loco-can/loco-can-hardware/Graphics/module-images/Messinstrument.png

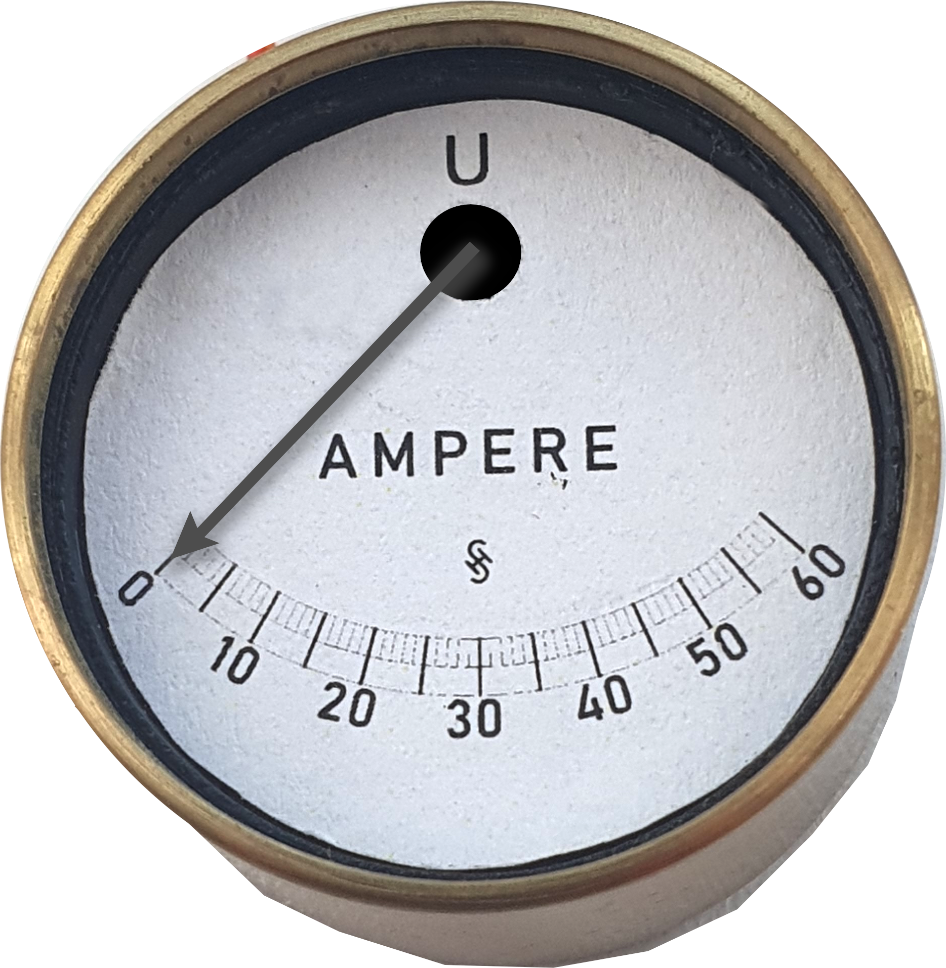
Graphics/module-images/Messinstrument.png
