loco-can/loco-can-hardware/Graphics/module-images/Motor.jpg

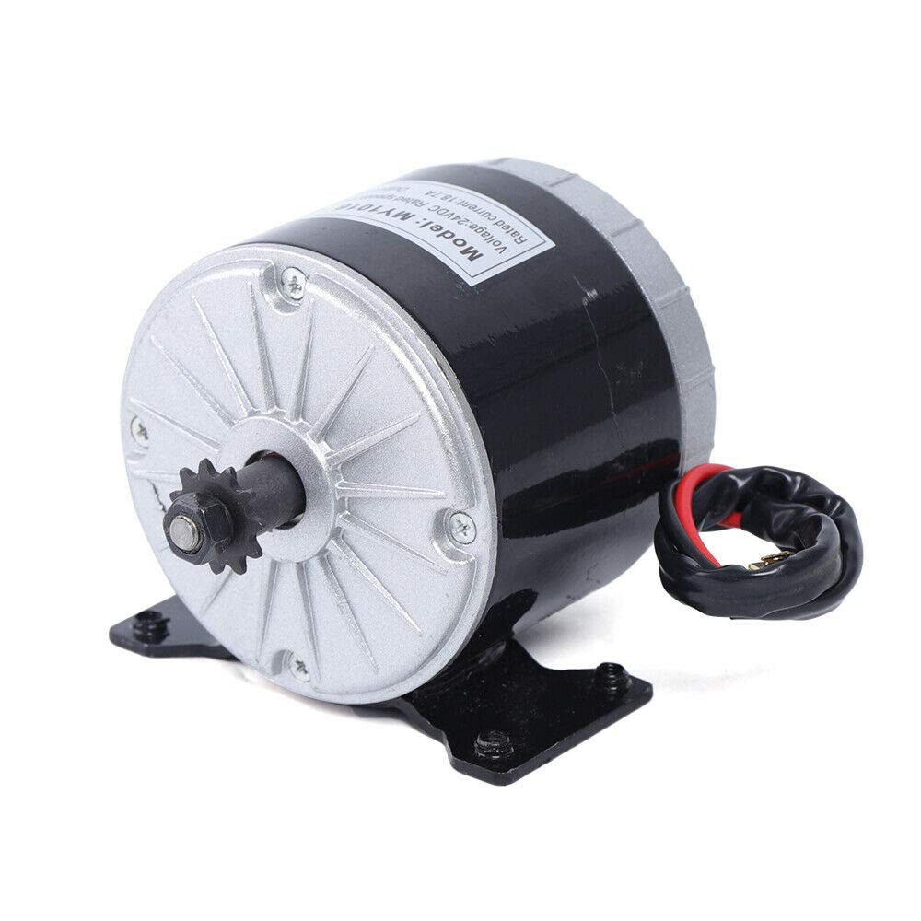
Graphics/module-images/Motor.jpg
