loco-can/loco-can-hardware/Graphics/documentation/Loco-CAN Zusammenstellung.pdf

# Klassische Steuerleitung

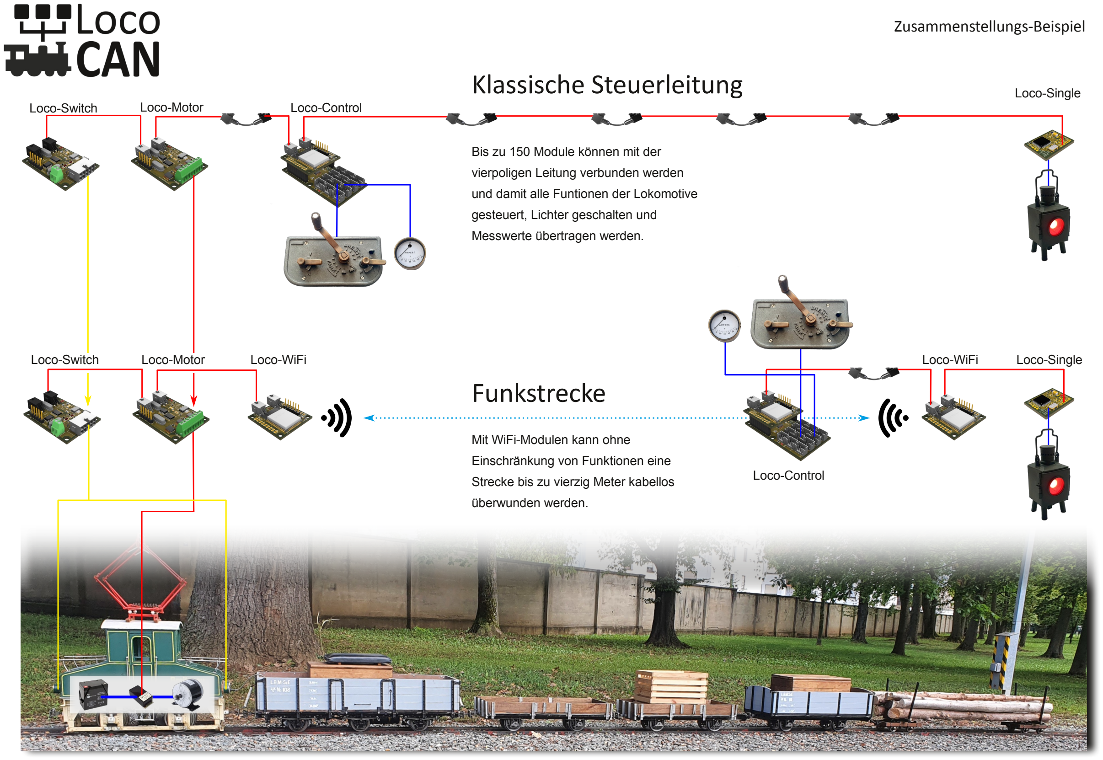
[picture p3: page 1]

Loco-WiFi Loco-Single

Loco-Control

Loco-WiFi

Loco-Single
Loco-Switch | Loco-Motor | Loco-Control
Loco-Switch | Loco-Motor

Bis zu 150 Module können mit der vierpoligen Leitung verbunden werden und damit alle Funtionen der Lokomotive gesteuert, Lichter geschalten und Messwerte übertragen werden.

Mit WiFi-Modulen kann ohne Einschränkung von Funktionen eine Strecke bis zu vierzig Meter kabellos überwunden werden.

# Funkstrecke

Zusammenstellungs‐Beispiel
