loco-can/loco-can-hardware/Graphics/module-images/4QD.png

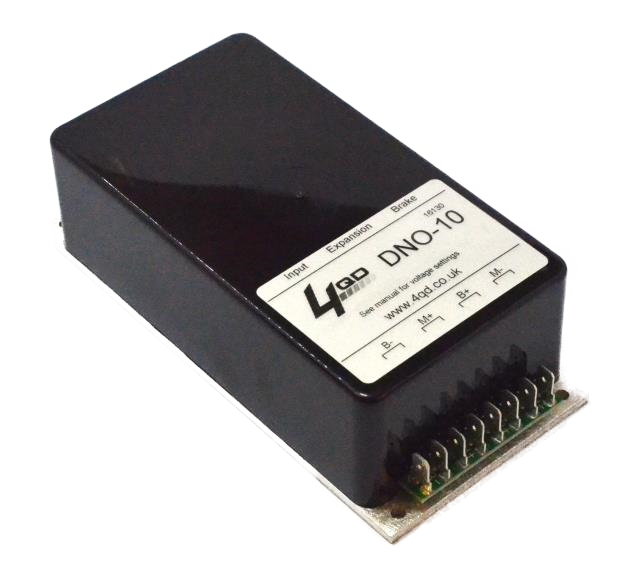
Graphics/module-images/4QD.png
