loco-can/loco-can-hardware/Graphics/module-images/Akku.png

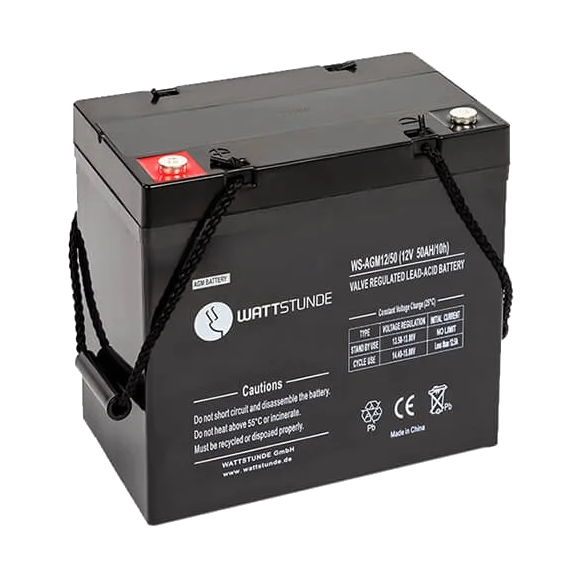
Graphics/module-images/Akku.png
