loco-can/loco-can-hardware/Graphics/module-images/Ausstecklaterne rot.jpg

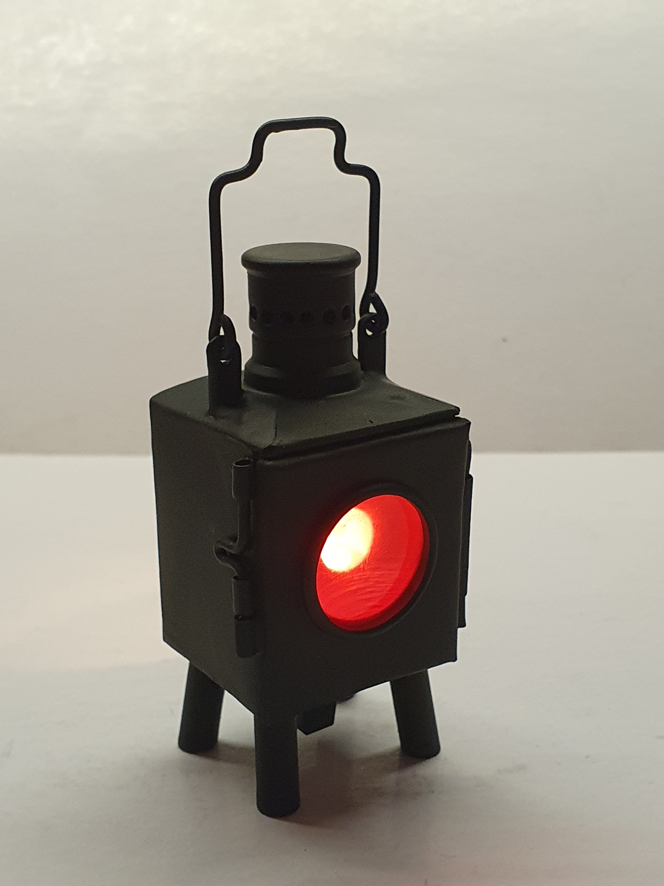
Graphics/module-images/Ausstecklaterne rot.jpg
