loco-can/loco-can-hardware/Graphics/module-images/Ausstecklaterne rot.png

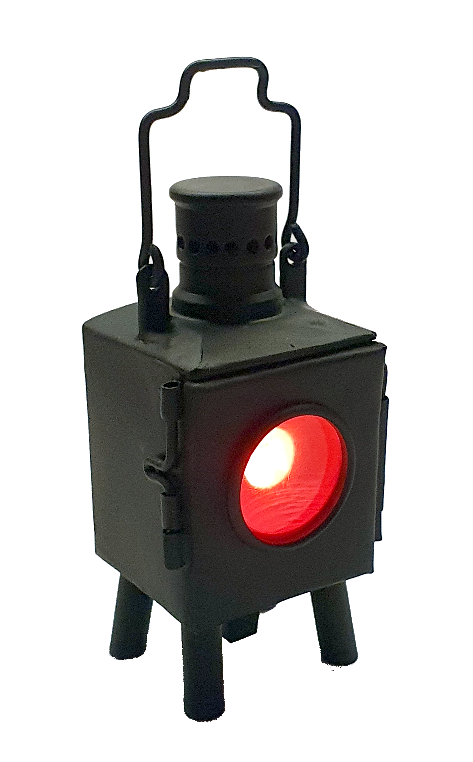
Graphics/module-images/Ausstecklaterne rot.png
