loco-can/loco-can-hardware/Graphics/module-images/Ausstecklaterne weiß.jpg

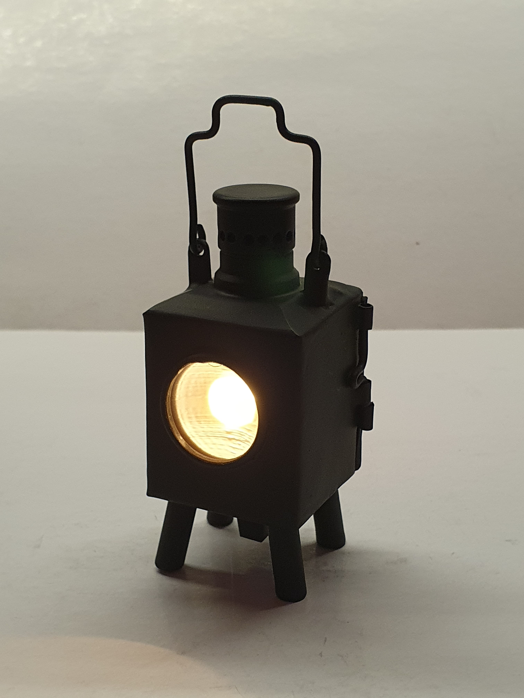
Graphics/module-images/Ausstecklaterne weiß.jpg
