loco-can/loco-can-hardware/Graphics/module-images/Heizungsstecker.jpg

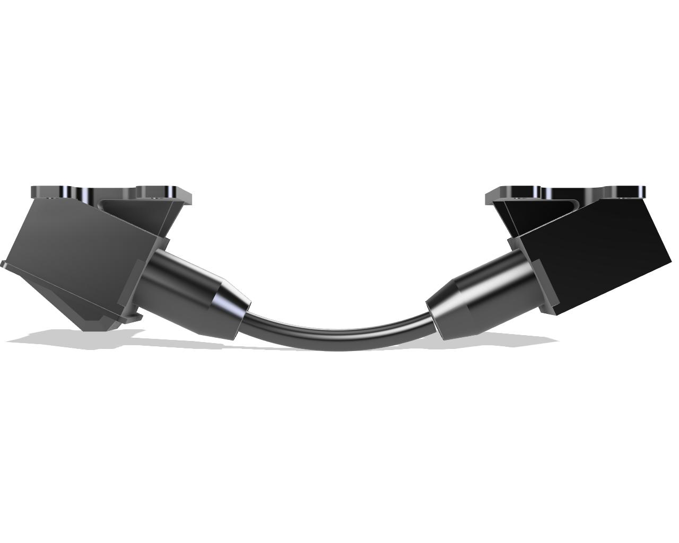
Graphics/module-images/Heizungsstecker.jpg
