loco-can/loco-can-hardware/Graphics/module-images/LOCO-Control-Adapter.jpg

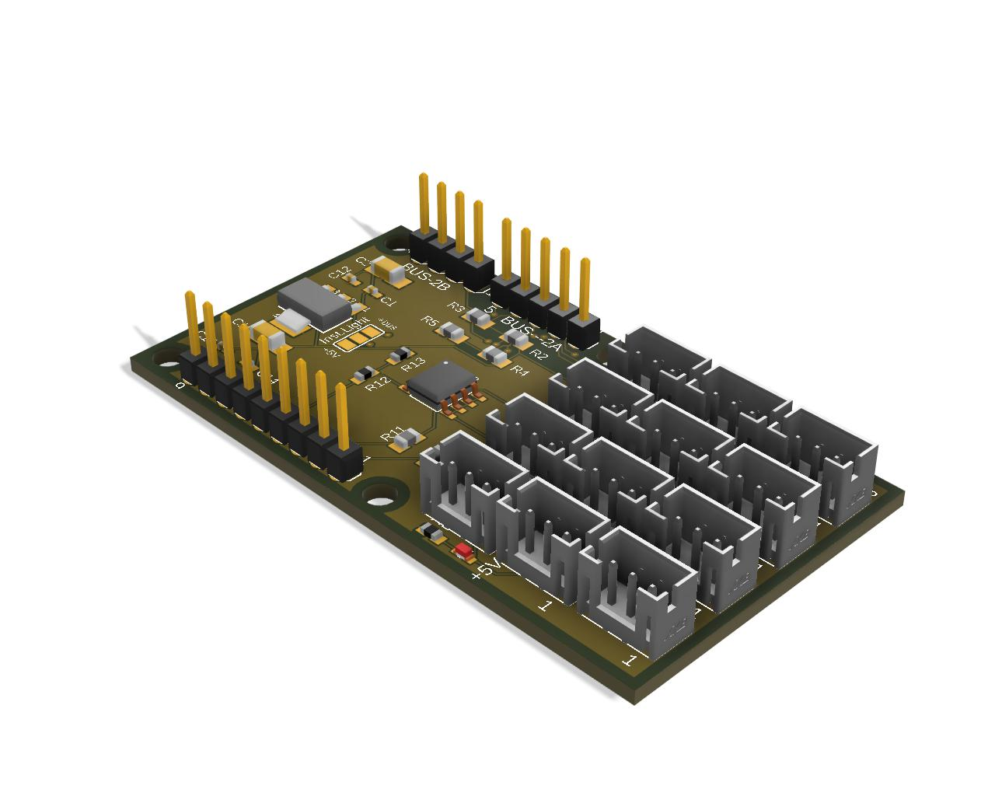
Graphics/module-images/LOCO-Control-Adapter.jpg
