loco-can/loco-can-hardware/Graphics/module-images/Loco-Control-WiFi.jpg

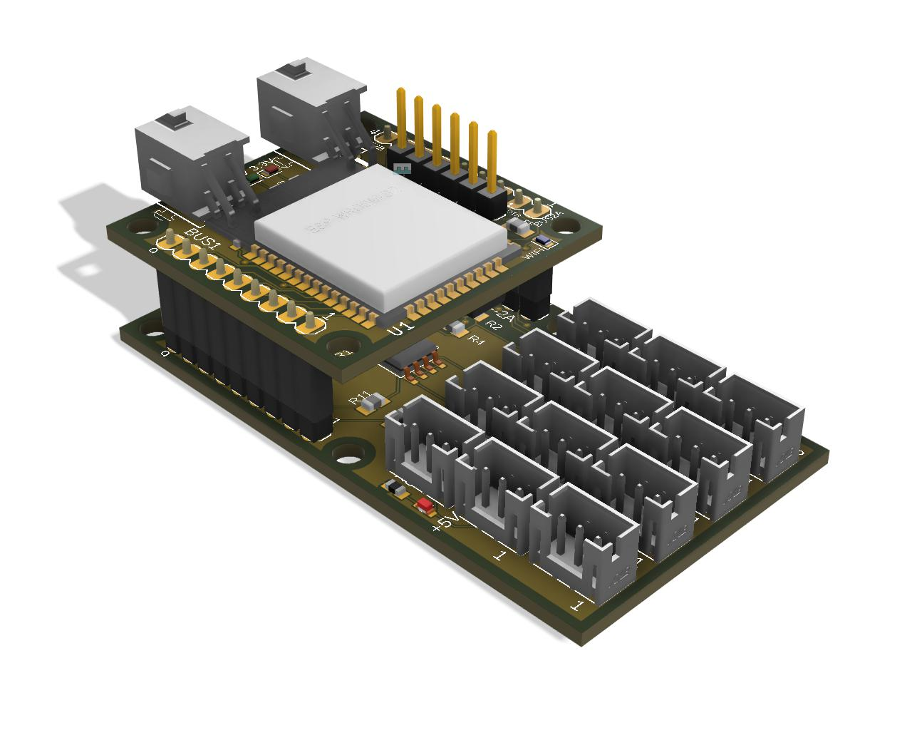
Graphics/module-images/Loco-Control-WiFi.jpg
