loco-can/loco-can-hardware/Graphics/module-images/Loco-Motor.jpg

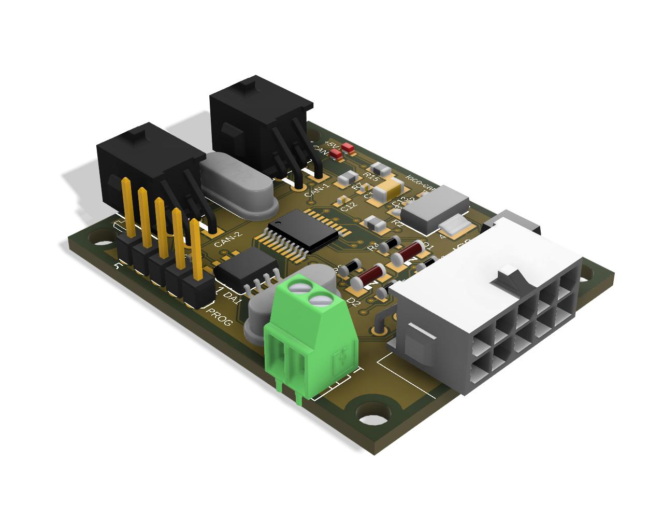
Graphics/module-images/Loco-Motor.jpg
