loco-can/loco-can-hardware/Graphics/module-images/Loco-Servo.jpg

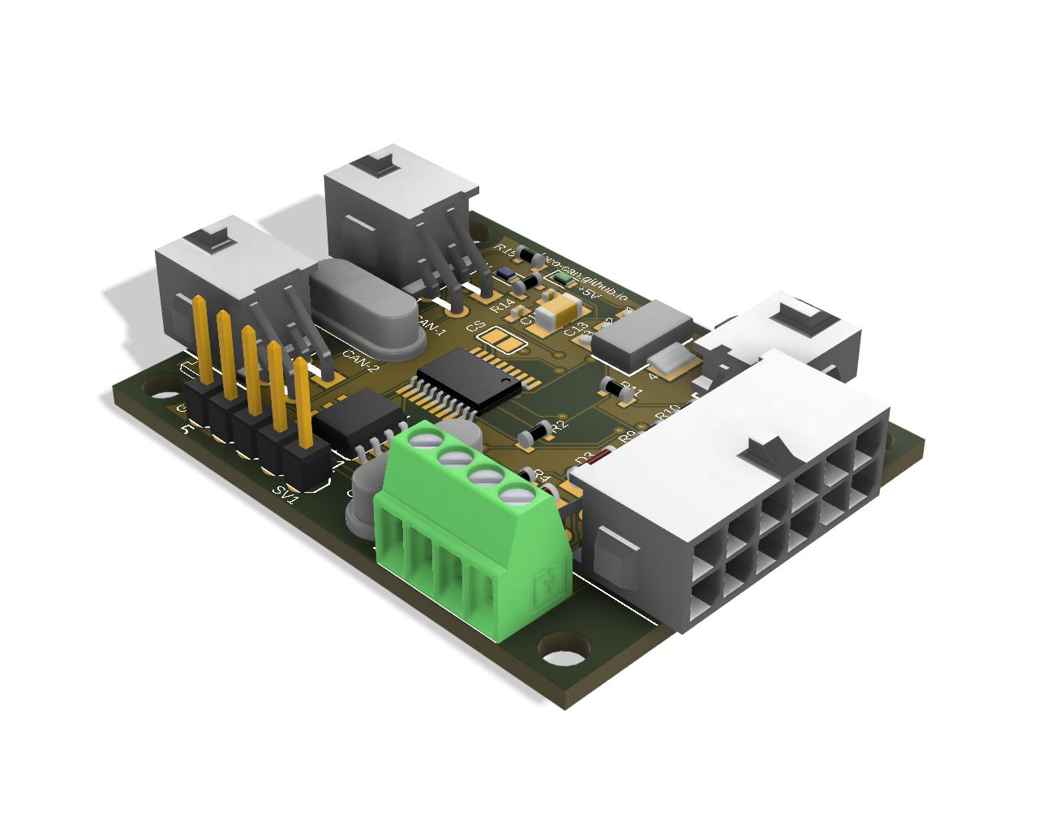
Graphics/module-images/Loco-Servo.jpg
