loco-can/loco-can-hardware/Graphics/module-images/Loco-Single Akku.png

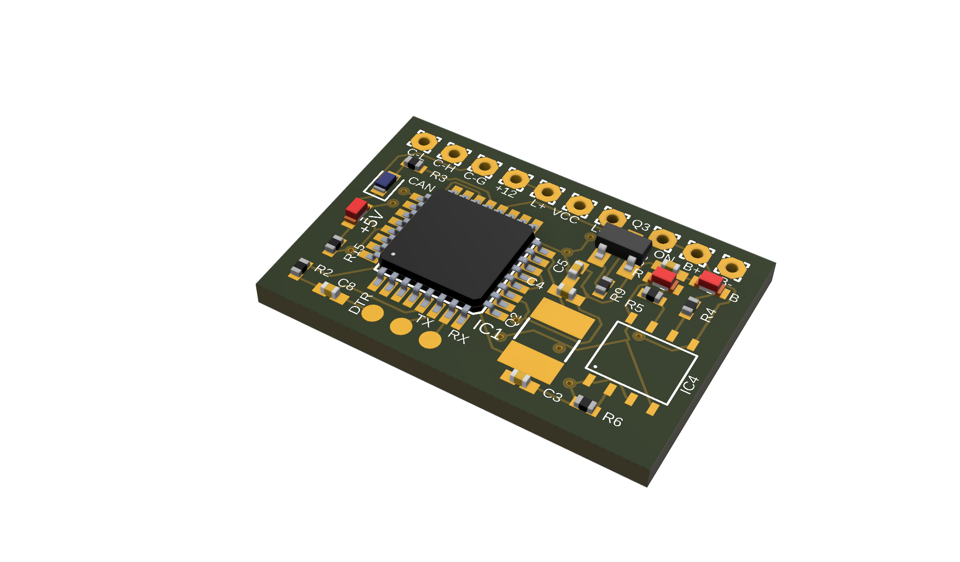
Graphics/module-images/Loco-Single Akku.png
