loco-can/loco-can-hardware/Graphics/module-images/Loco-Single.jpg

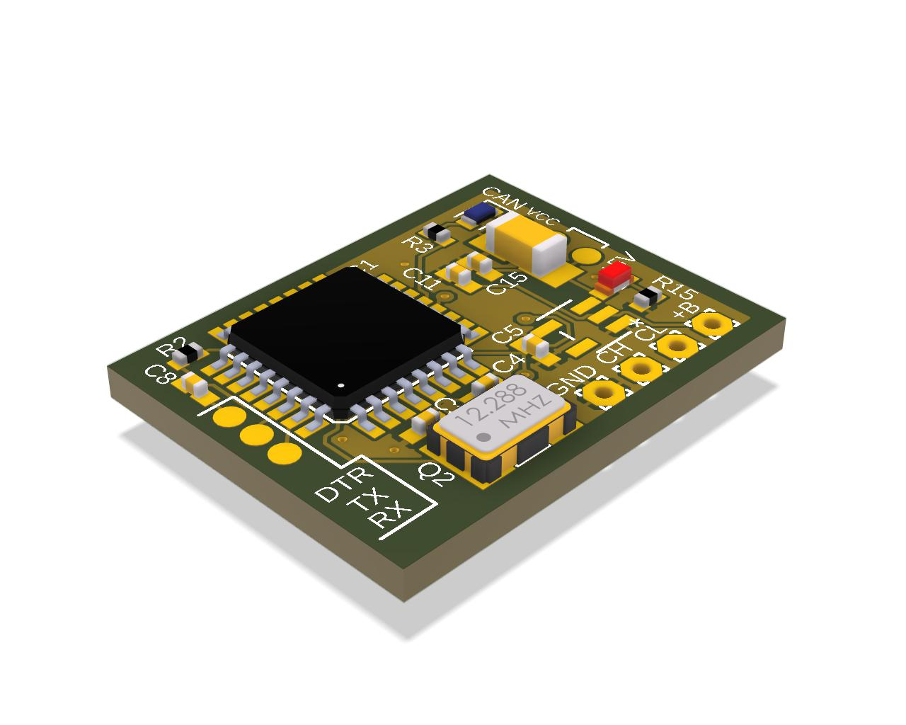
Graphics/module-images/Loco-Single.jpg
