loco-can/loco-can-hardware/Graphics/module-images/Loco-Split.jpg

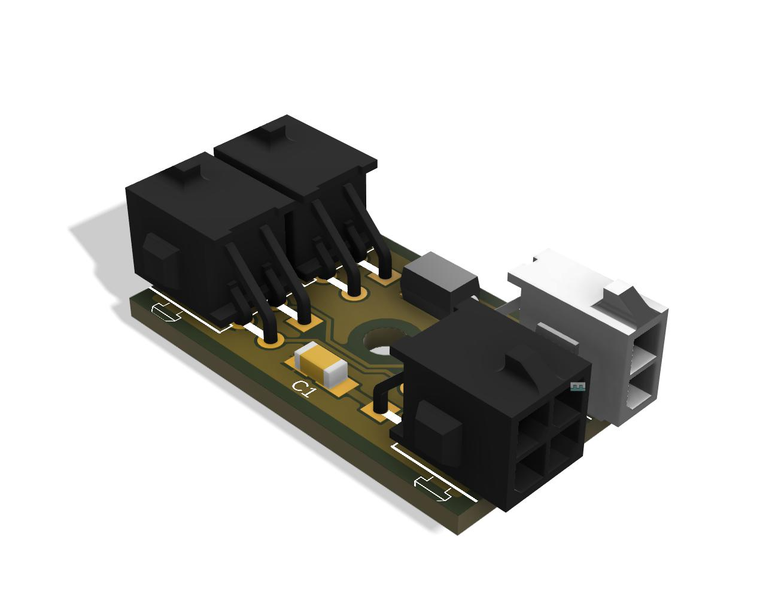
Graphics/module-images/Loco-Split.jpg
