loco-can/loco-can-hardware/Graphics/module-images/Loco-Switch.jpg

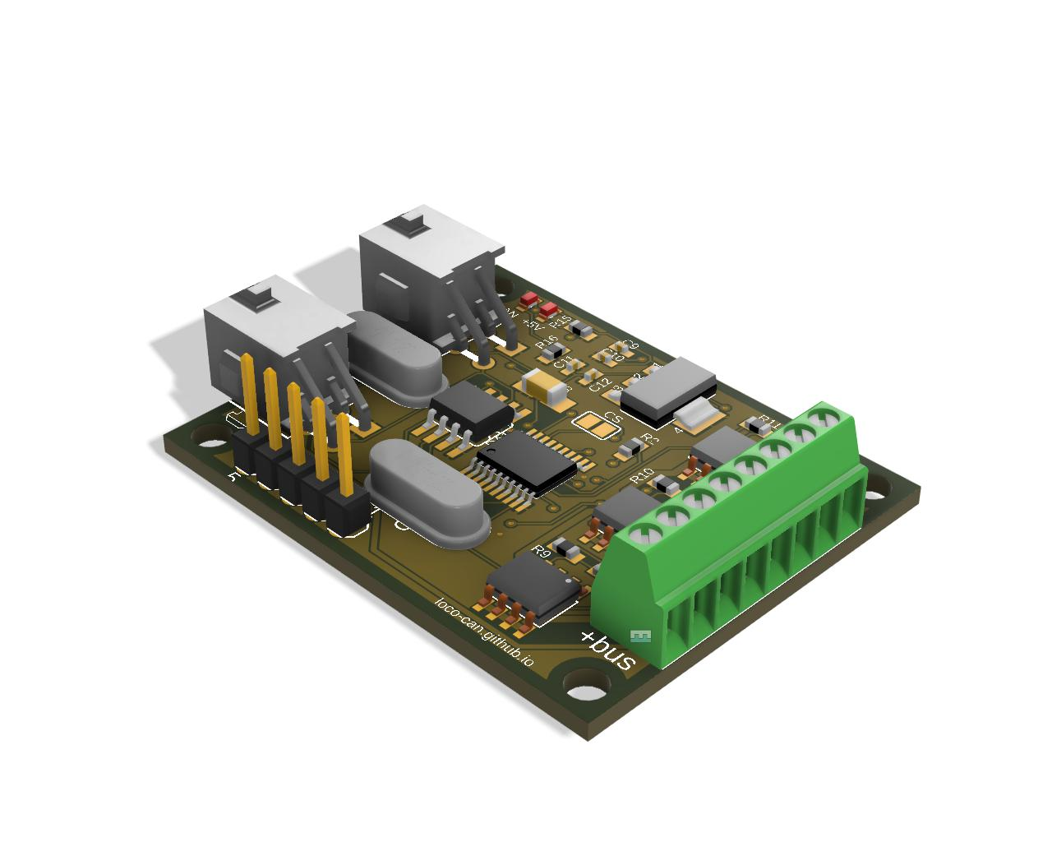
Graphics/module-images/Loco-Switch.jpg
