loco-can/loco-can-hardware/Graphics/module-images/Loco-Universal.jpg

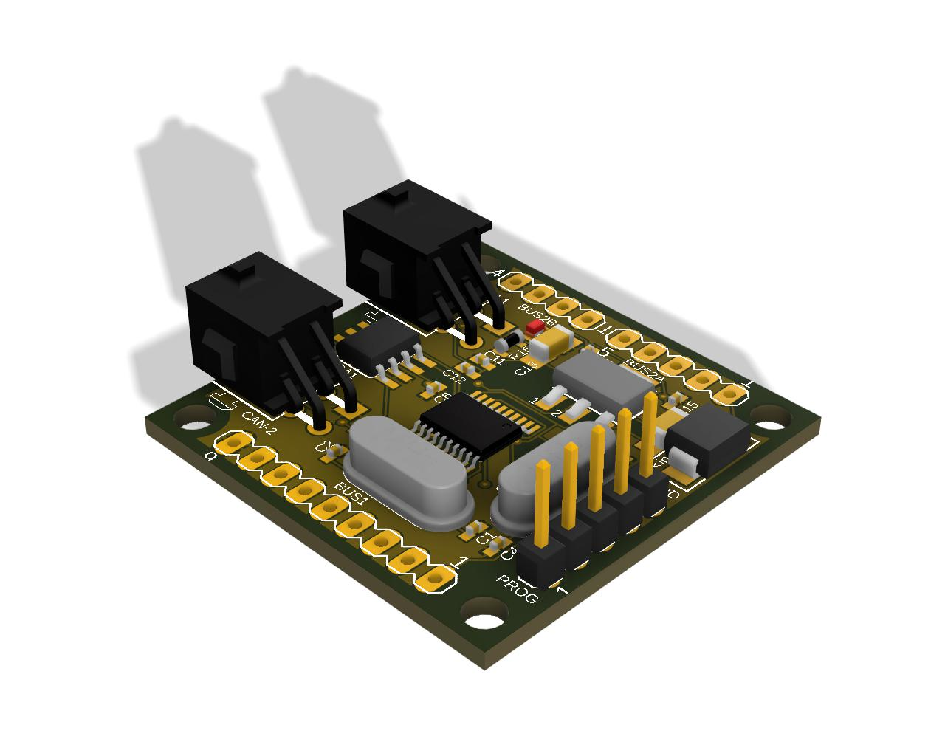
Graphics/module-images/Loco-Universal.jpg
