loco-can/loco-can-hardware/Graphics/module-images/Loco-WiFi.png

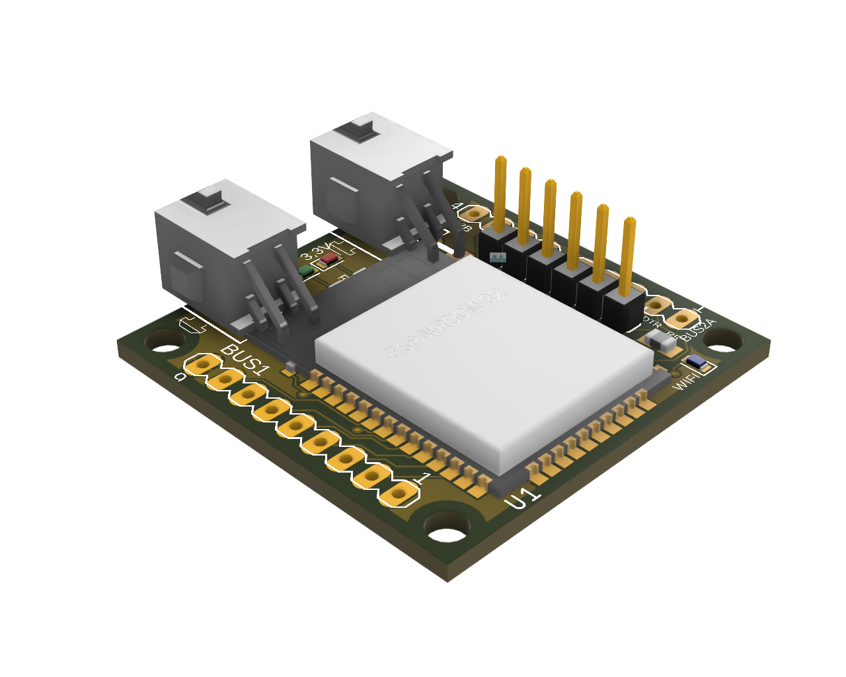
Graphics/module-images/Loco-WiFi.png
