loco-can/loco-can-hardware/Graphics/module-images/Motor.png

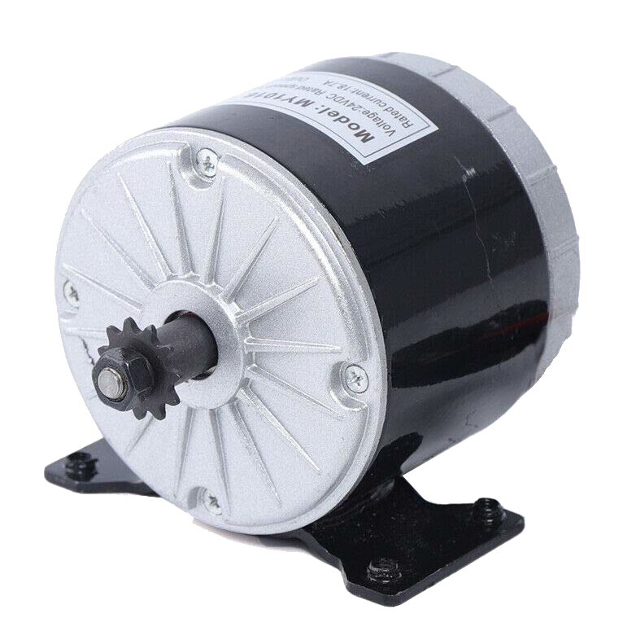
Graphics/module-images/Motor.png
