loco-can/loco-can-hardware/Graphics/module-images/oshw.bmp

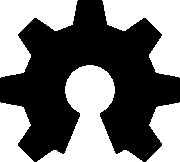
Graphics/module-images/oshw.bmp
