loco-can/loco-can-hardware/Mechanics/cover motor module.stl

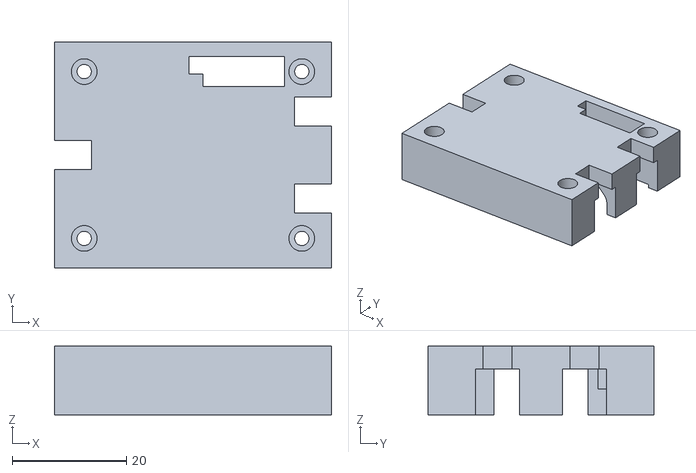
[picture p22: CAD file, 2023-09-08]
Mechanics/cover motor module.stl
48.5 x 39.5 x 12.0
