loco-can/loco-can-hardware/Mechanics/cover servo module.stl

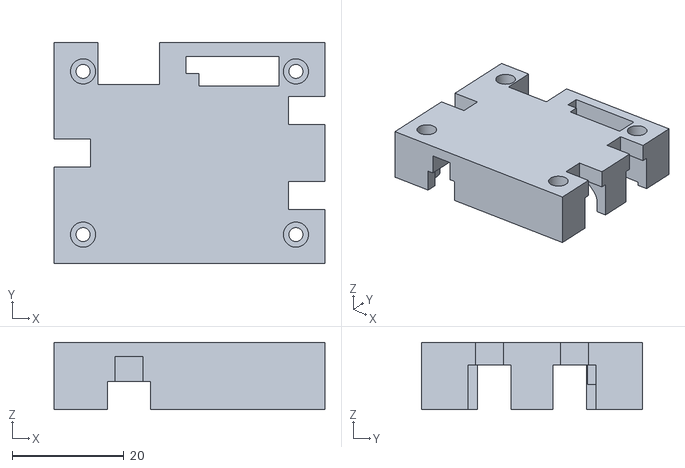
[picture p23: CAD file, 2023-09-08]
Mechanics/cover servo module.stl
48.5 x 39.5 x 12.0
