loco-can/loco-can-hardware/Mechanics/frame control adapter.stl

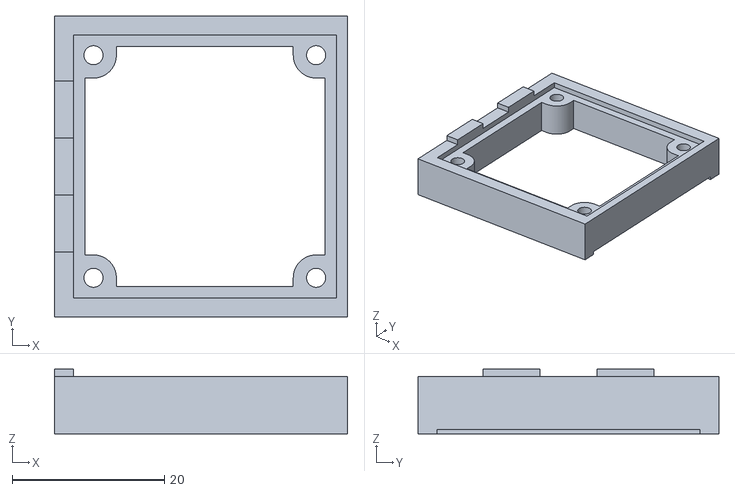
[picture p24: CAD file, 2023-09-08]
Mechanics/frame control adapter.stl
38.5 x 39.5 x 8.50
