loco-can/loco-can-hardware/Mechanics/baseplate controller.stl

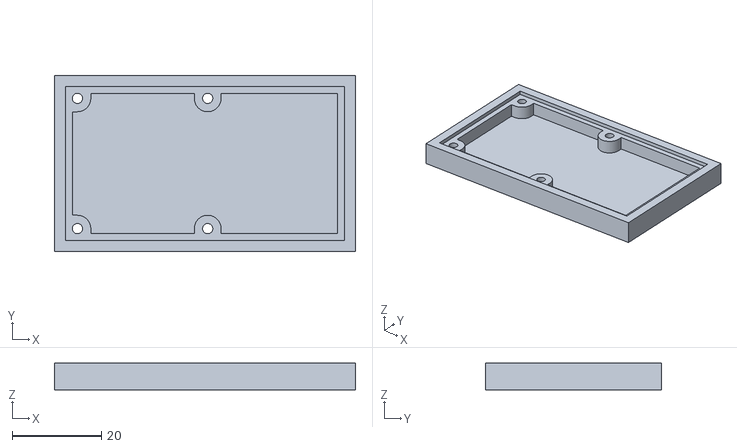
[picture p25: CAD file, 2023-09-08]
Mechanics/baseplate controller.stl
67.5 x 39.5 x 6.00
