loco-can/loco-can-hardware/Mechanics/baseplate.stl

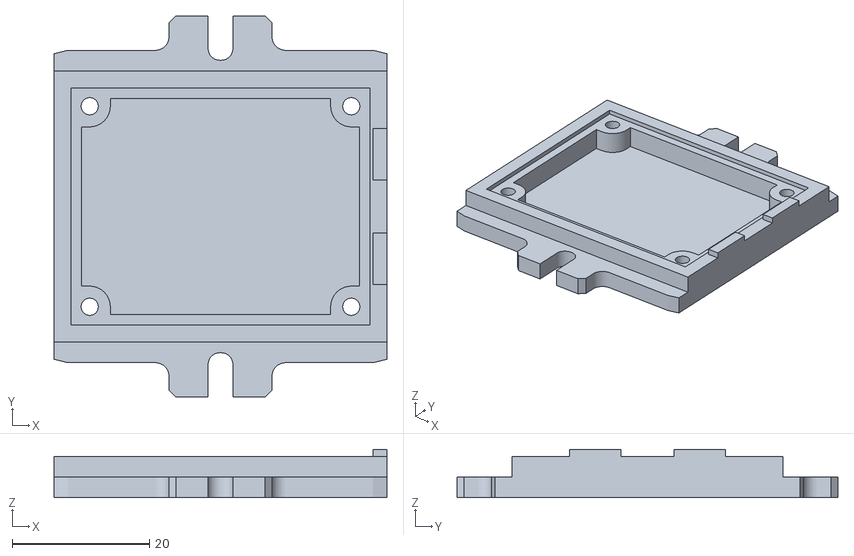
[picture p26: CAD file, 2023-09-08]
Mechanics/baseplate.stl
48.5 x 55.5 x 7.00
