loco-can/loco-can-hardware/Mechanics/cover universal module.stl

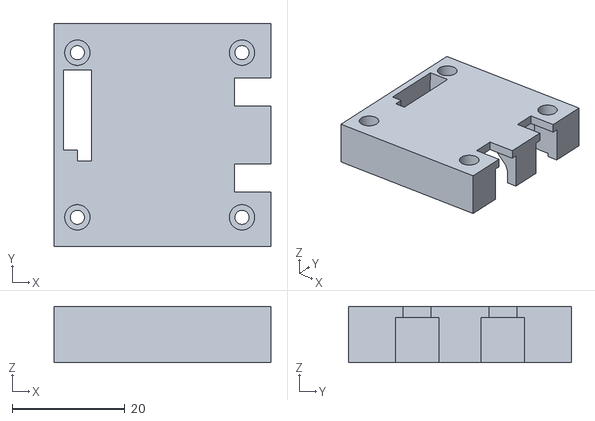
[picture p27: CAD file, 2023-09-08]
Mechanics/cover universal module.stl
38.5 x 39.5 x 10.0
