loco-can/loco-can-hardware/(list of files, cad)

Other CAD files:
Graphics/meter/Messgeräteskala.FCStd
Mechanics/cover switch module.stl
Graphics/meter/Messgeräteskala.dxf
Mechanics/baseplate controller.f3d
Mechanics/baseplate.f3d
Mechanics/cover motor module.f3d
Mechanics/cover servo module.f3d
Mechanics/cover switch module.f3d
Mechanics/cover universal module.f3d
Mechanics/frame control adapter.f3d
Program Cable/Program Cable v3.f3z
V2.x/Micro/Loco-Micro.f3z
V2.x/Powersplit/Powersplit v1.f3z
V2.x/Single Akku/LOCO-Single Light-Akku.f3z
V2.x/Single Akku/Loco-Single Akku.f3z
V2.x/Single/Loco-Single.f3z
V2.x/Split/Loco-Split.f3z
