loco-can/loco-can-hardware/Graphics/documentation/Loco-CAN Assembly.pdf

# Classic control line

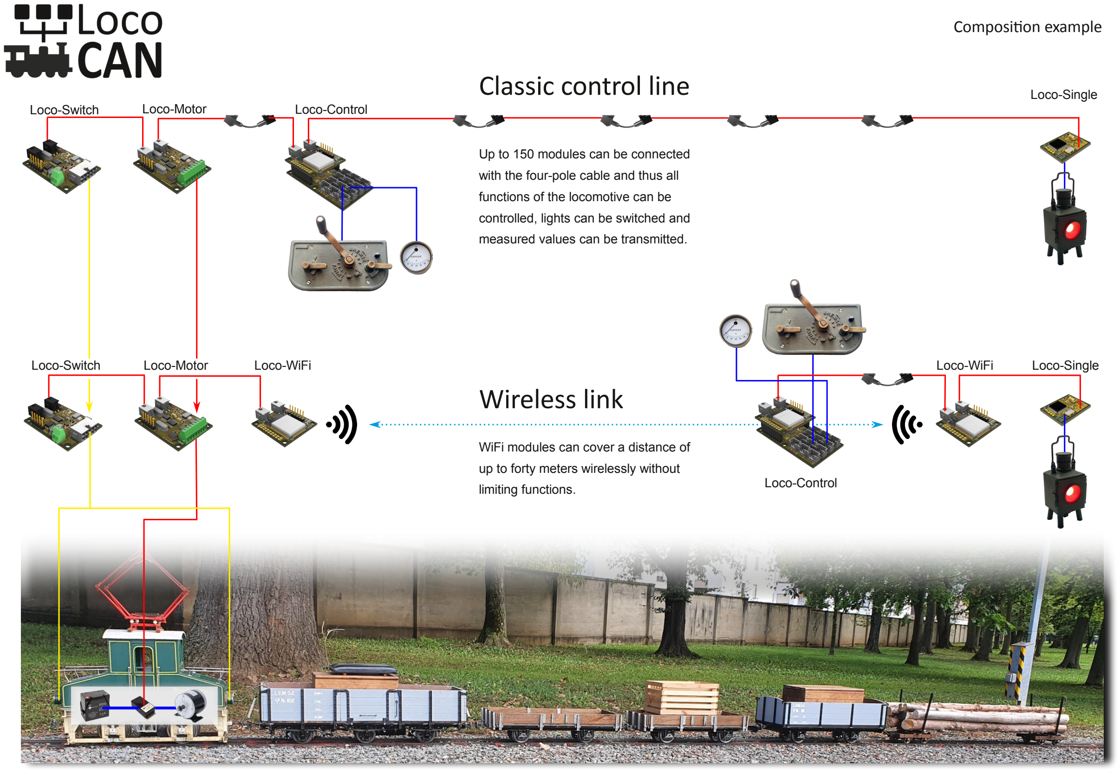
[picture p28: page 1]

Loco-WiFi Loco-Single

Loco-Control

Loco-WiFi

Loco-Single
Loco-Switch | Loco-Motor | Loco-Control
Loco-Switch | Loco-Motor

# Wireless link

Composion example

Up to 150 modules can be connected with the fourpole cable and thus all functions of the locomotive can be controlled, lights can be switched and measured values can be transmitted.

WiFi modules can cover a distance of up to forty meters wirelessly without limiting functions.
