loco-can/loco-can-hardware/Tripple LED/Tripple-LED.pdf

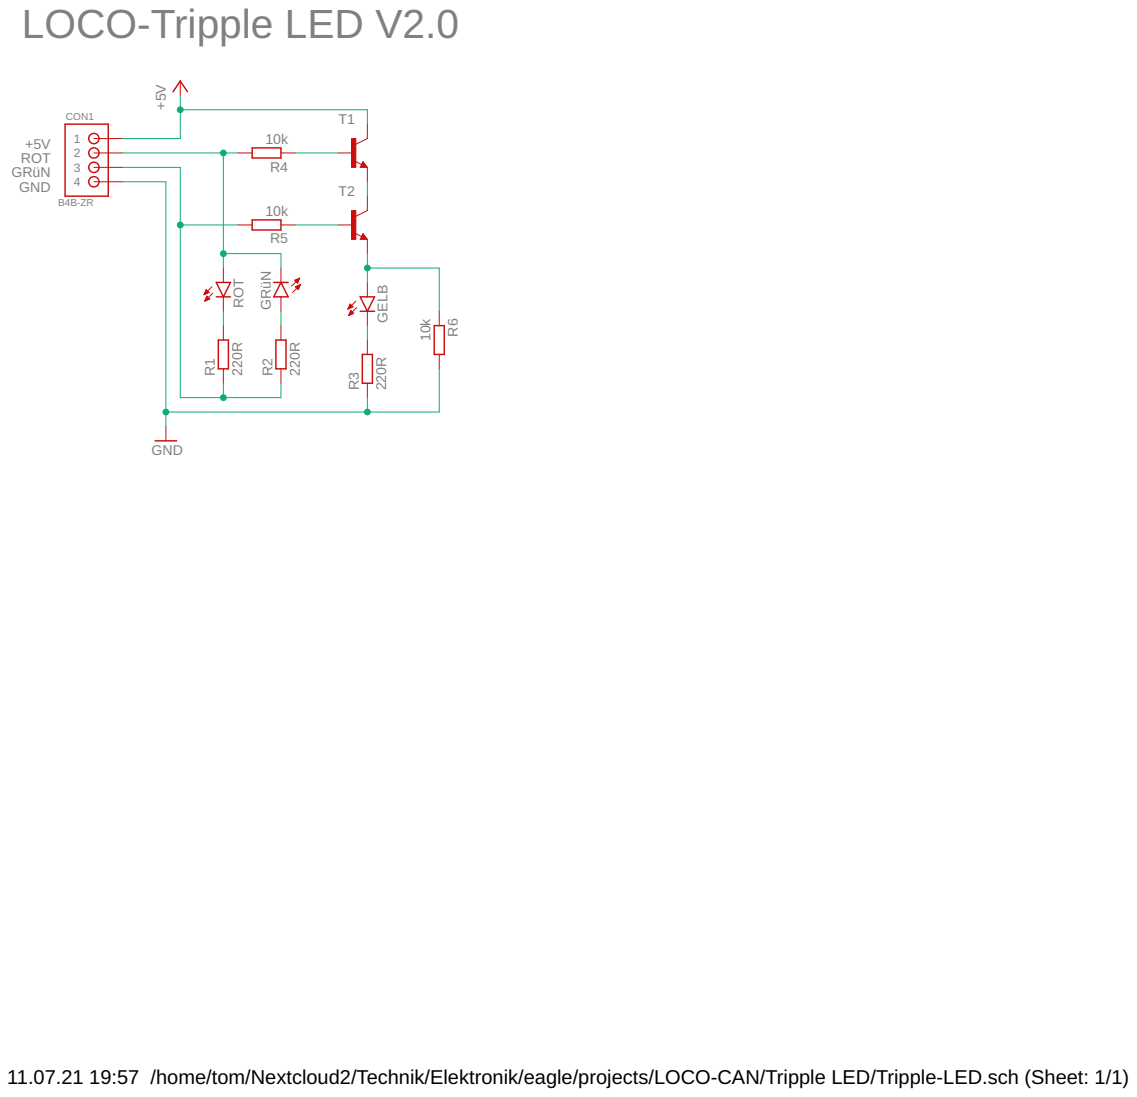
[picture p29: page 1]

B4B-ZR LOCO-Tripple LED V2.0

11.07.21 19:57 /home/tom/Nextcloud2/Technik/Elektronik/eagle/projects/LOCO-CAN/Tripple LED/Tripple-LED.sch (Sheet: 1/1)
