loco-can/loco-can-hardware/V2.x/Motor/Loco-Motor.pdf

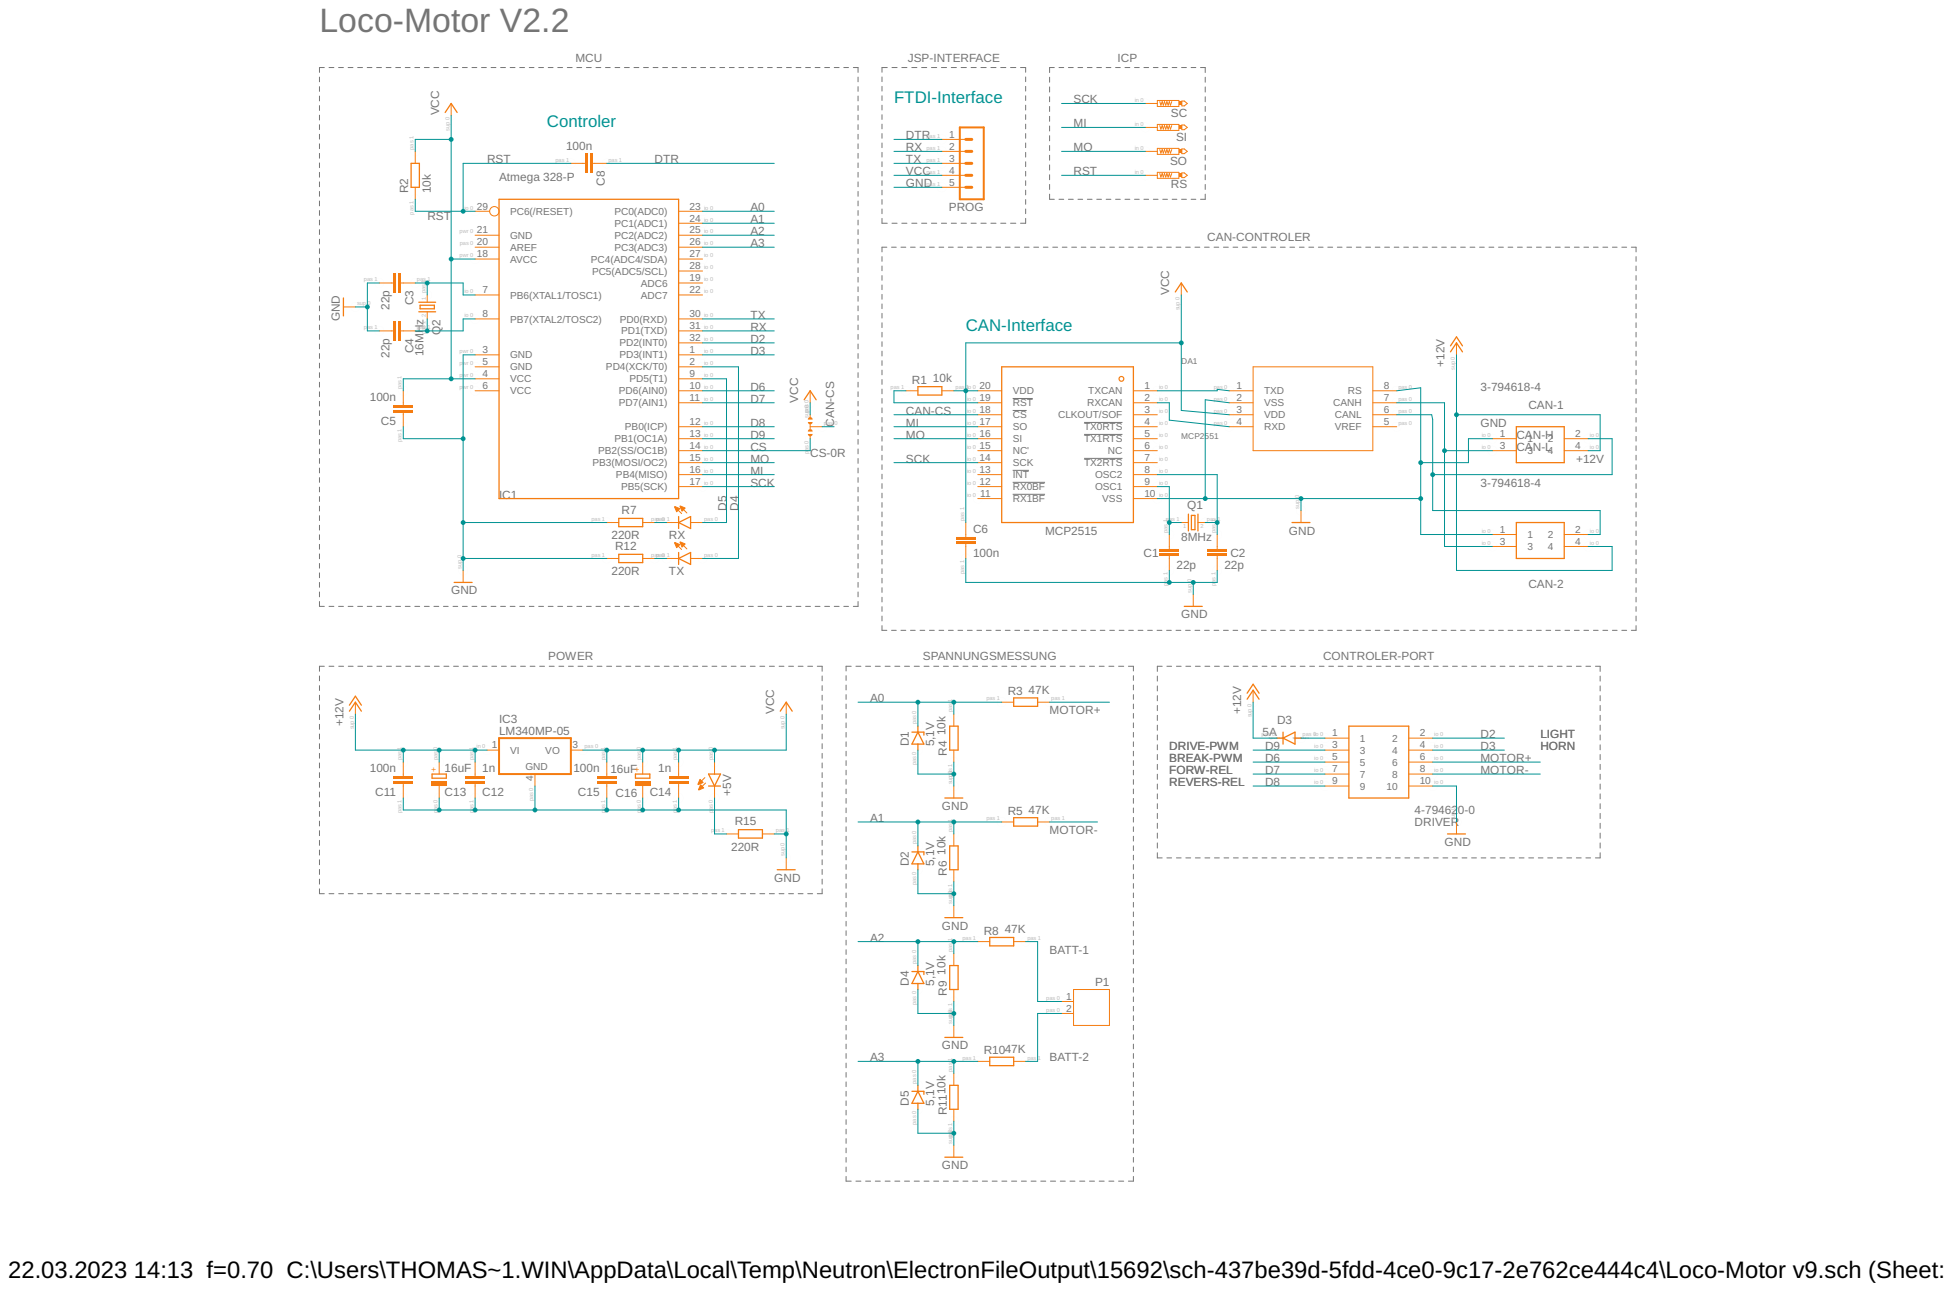
[picture p30: page 1]

CAN-CS CAN-CS D5

BREAK-PWM
FORW-REL REVERS-REL

22.03.2023 14:13 f=0.70 C:\Users\THOMAS~1.WIN\AppData\Local\Temp\Neutron\ElectronFileOutput\15692\sch-437be39d-5fdd-4ce0-9c17-2e762ce444c4\Loco-Motor v9.sch (Sheet: 1/2)
