loco-can/loco-can-hardware/V2.x/Switch/LOCO-Switch.pdf

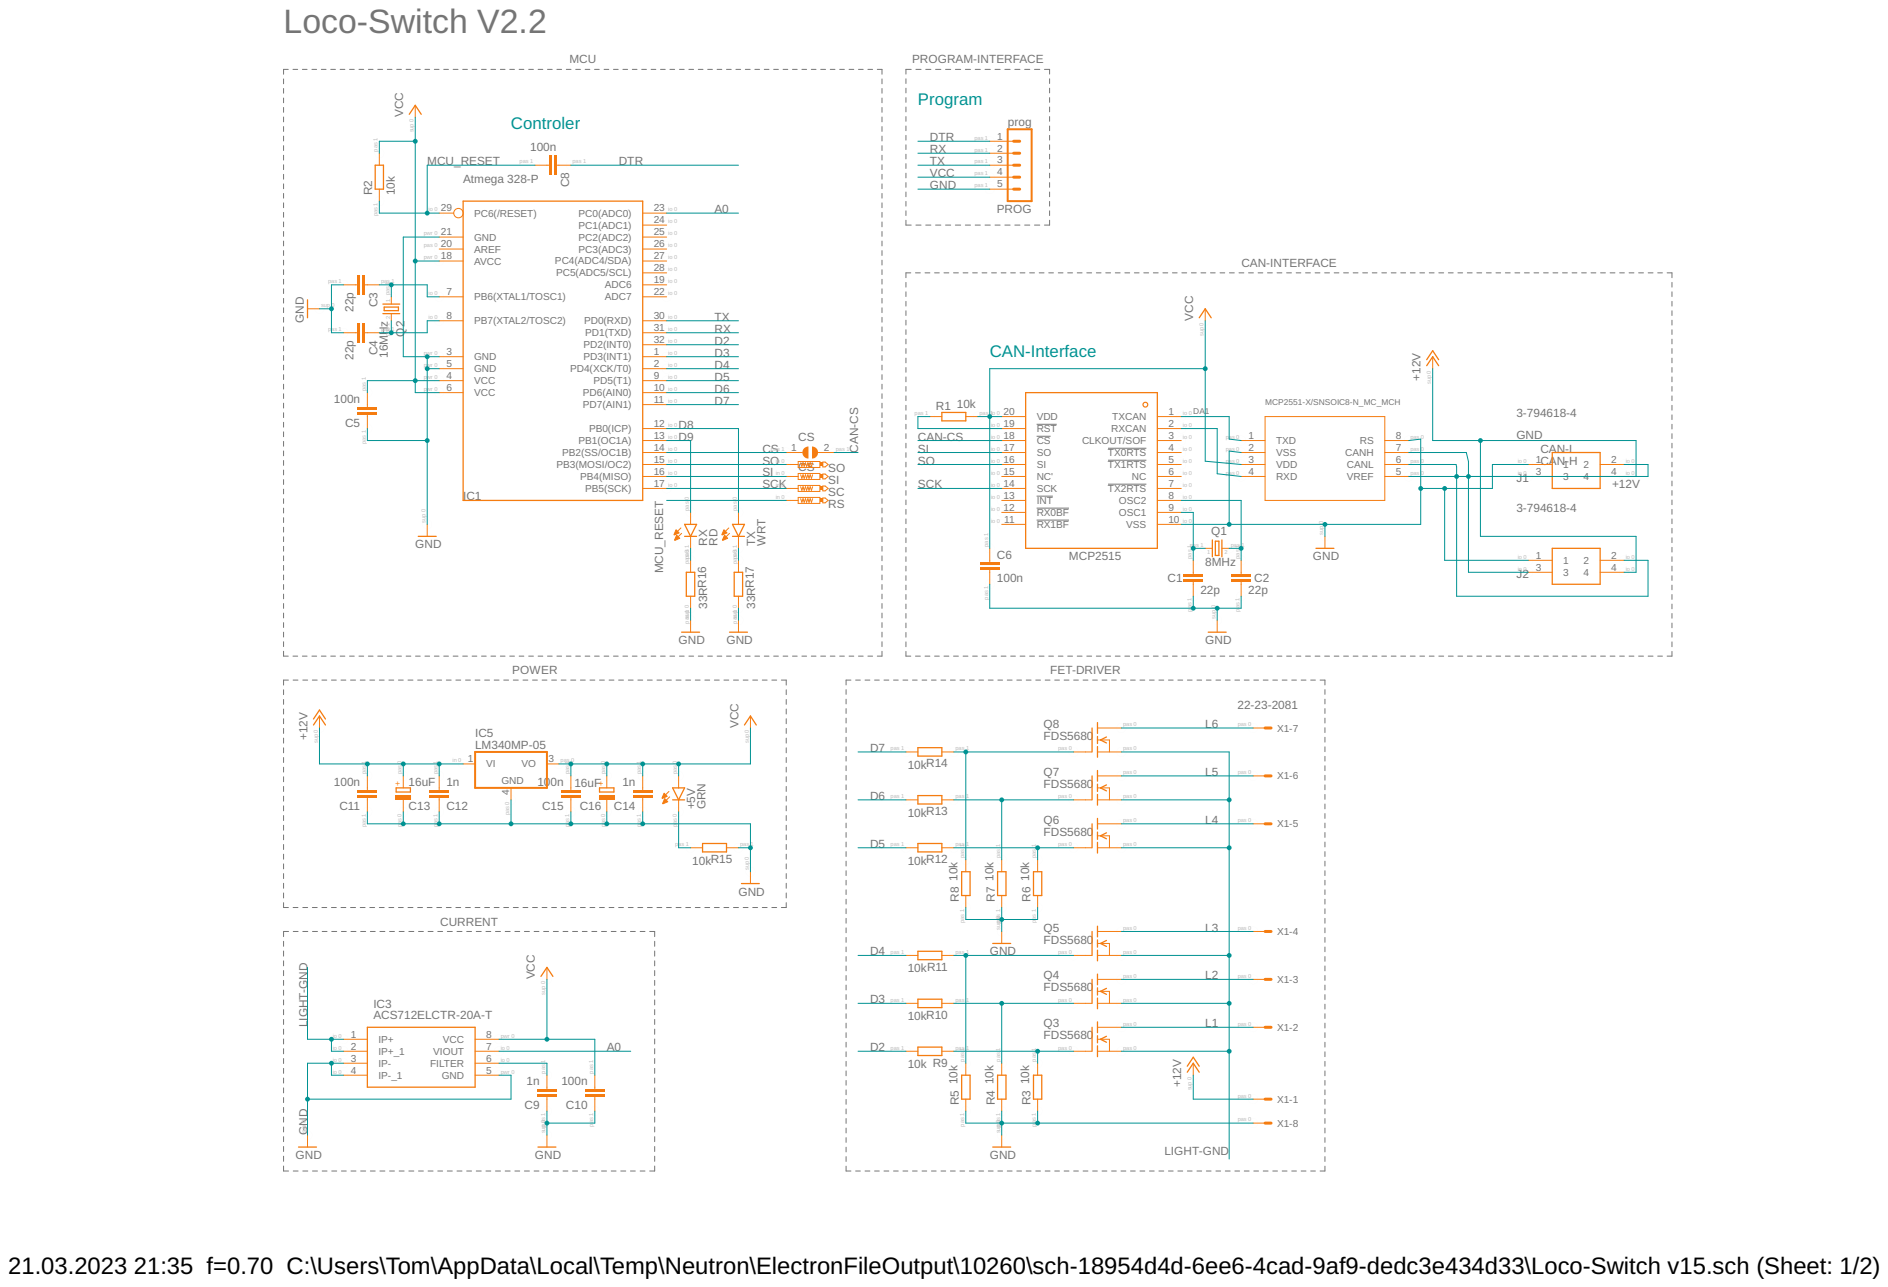
[picture p31: page 1]

CAN-CS

pas 0 pas 0 pas 1 pas 1 sup 0

sup 0 pas 1 pas 1 sup 0

21.03.2023 21:35 f=0.70 C:\Users\Tom\AppData\Local\Temp\Neutron\ElectronFileOutput\10260\sch-18954d4d-6ee6-4cad-9af9-dedc3e434d33\Loco-Switch v15.sch (Sheet: 1/2)
