loco-can/loco-can-hardware/V2.x/Servo/LOCO-Servo.pdf

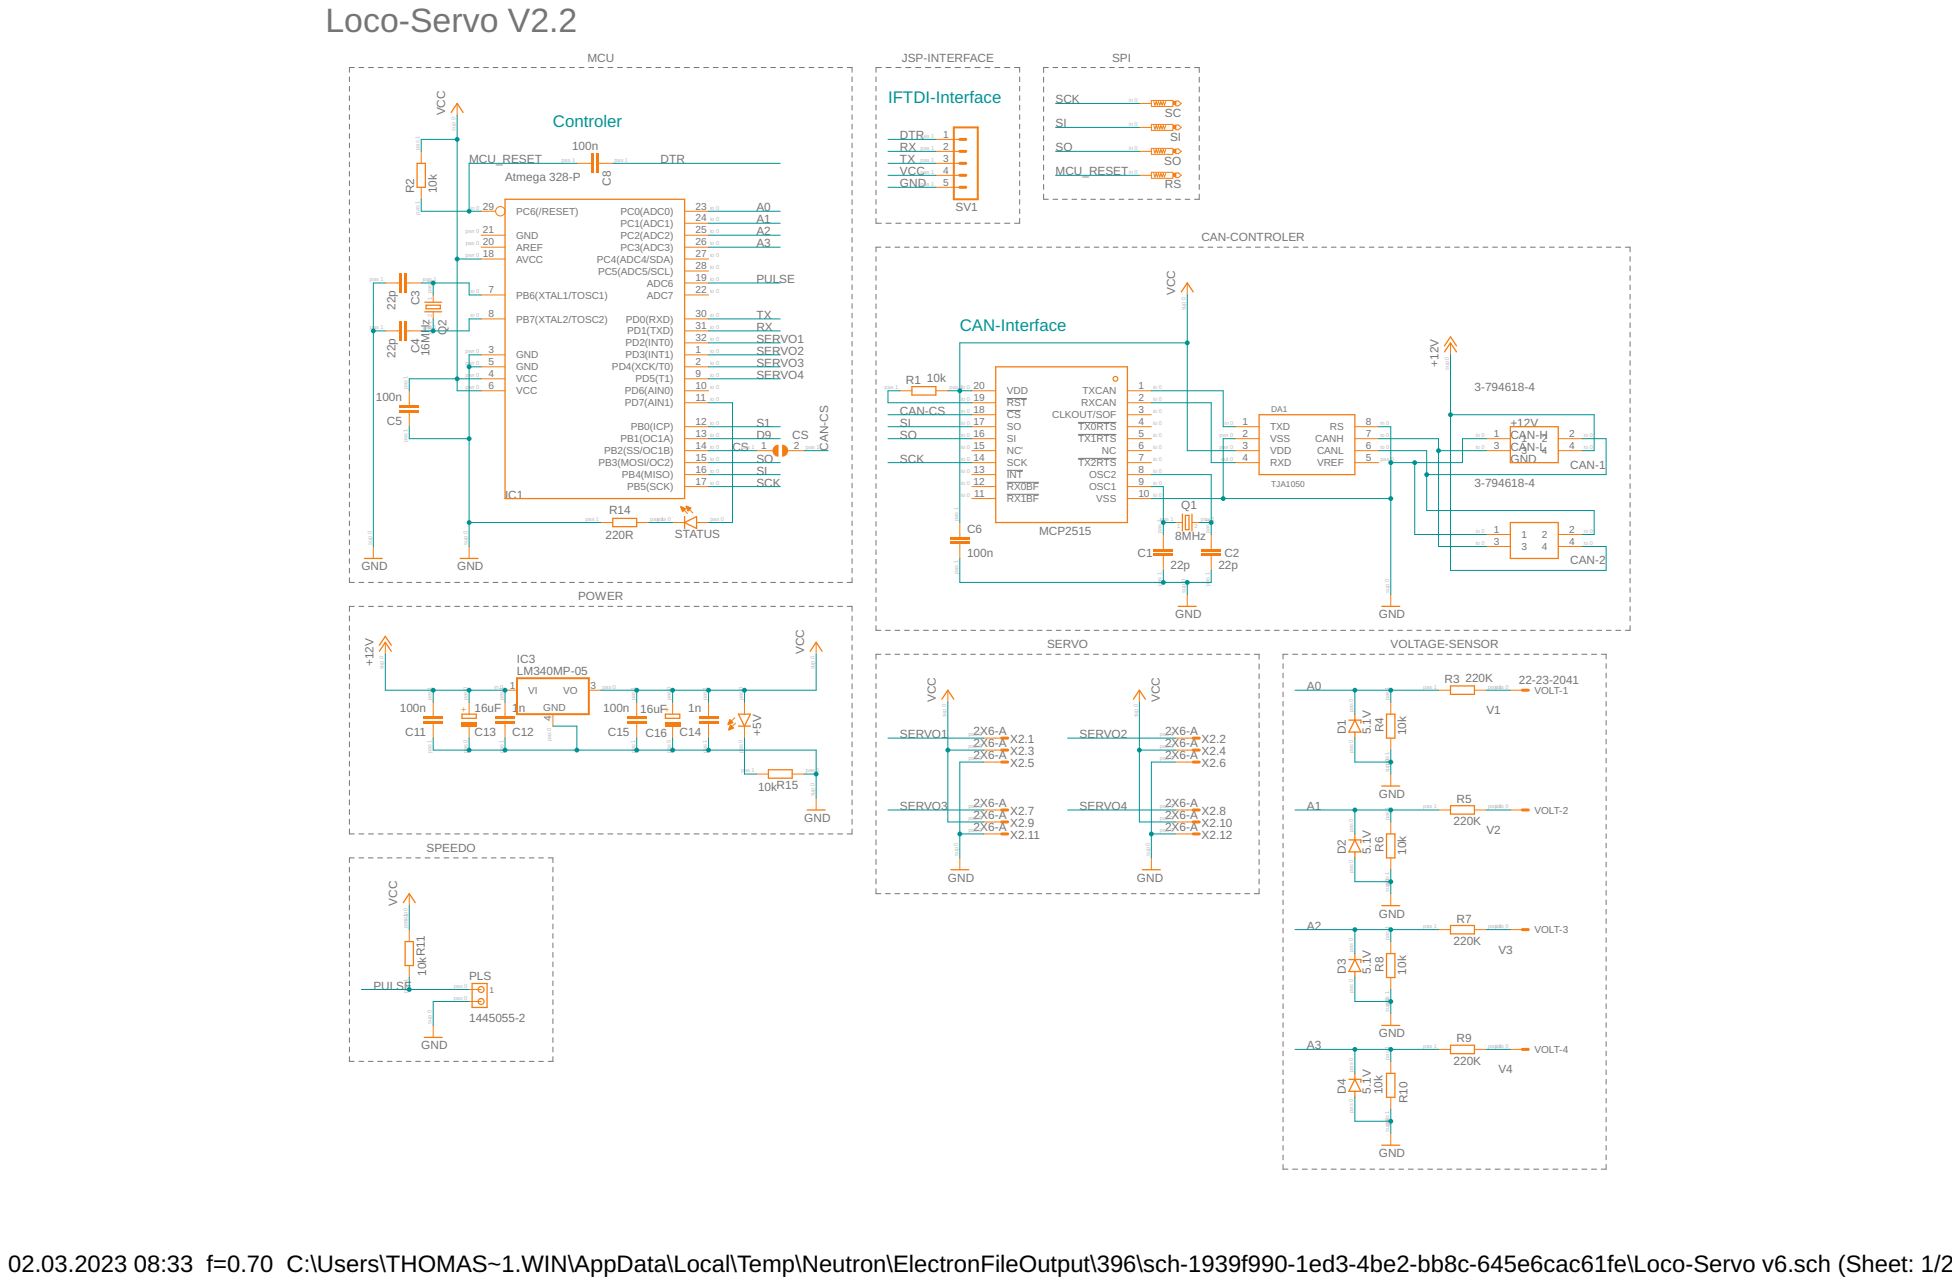
[picture p32: page 1]

02.03.2023 08:33 f=0.70 C:\Users\THOMAS~1.WIN\AppData\Local\Temp\Neutron\ElectronFileOutput\396\sch-1939f990-1ed3-4be2-bb8c-645e6cac61fe\Loco-Servo v6.sch (Sheet: 1/2)
