loco-can/loco-can-hardware/V2.x/Universal/Loco-Universal.pdf

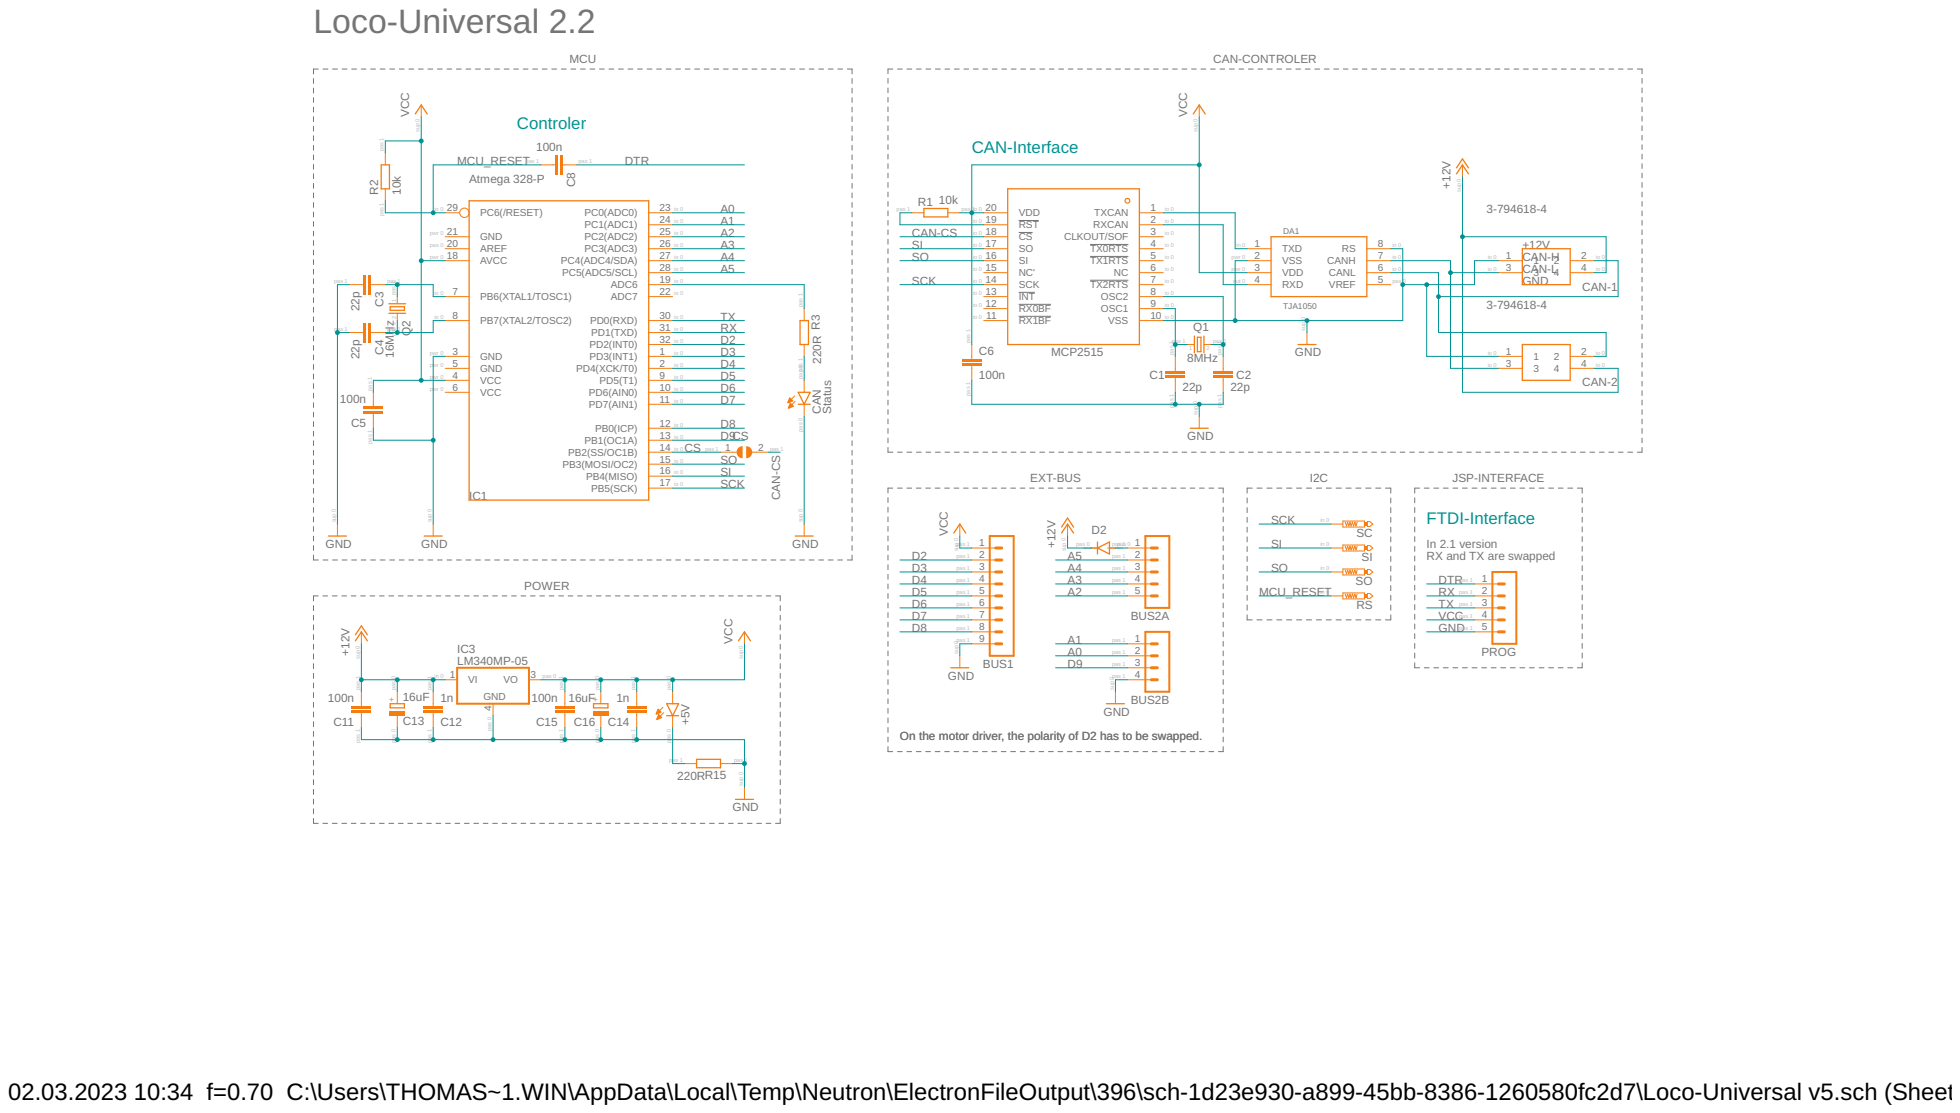
[picture p33: page 1]

pas 1 pas 1 sup 0 pas 0 pas 0

In 2.1 version
RX and TX are swapped

On the motor driver, the polarity of D2 has to be swapped.

02.03.2023 10:34 f=0.70 C:\Users\THOMAS~1.WIN\AppData\Local\Temp\Neutron\ElectronFileOutput\396\sch-1d23e930-a899-45bb-8386-1260580fc2d7\Loco-Universal v5.sch (Sheet: 1/2)
