loco-can/loco-can-hardware/V2.x/Powersplit/Powersplit.pdf

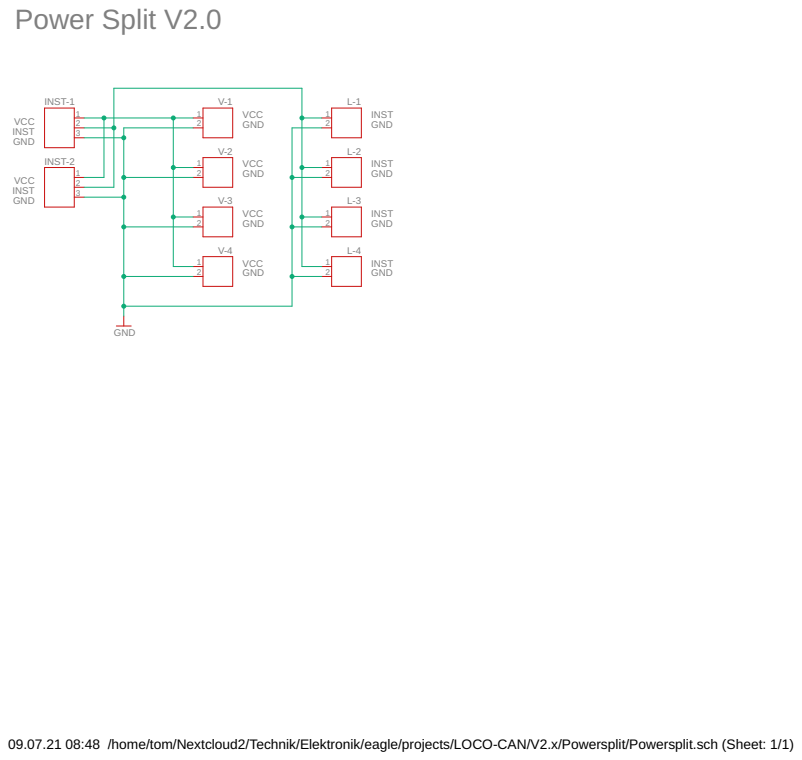
[picture p34: page 1]

09.07.21 08:48 /home/tom/Nextcloud2/Technik/Elektronik/eagle/projects/LOCO-CAN/V2.x/Powersplit/Powersplit.sch (Sheet: 1/1)
