loco-can/loco-can-hardware/V2.x/Speedometer/Loco-Speedometer.pdf

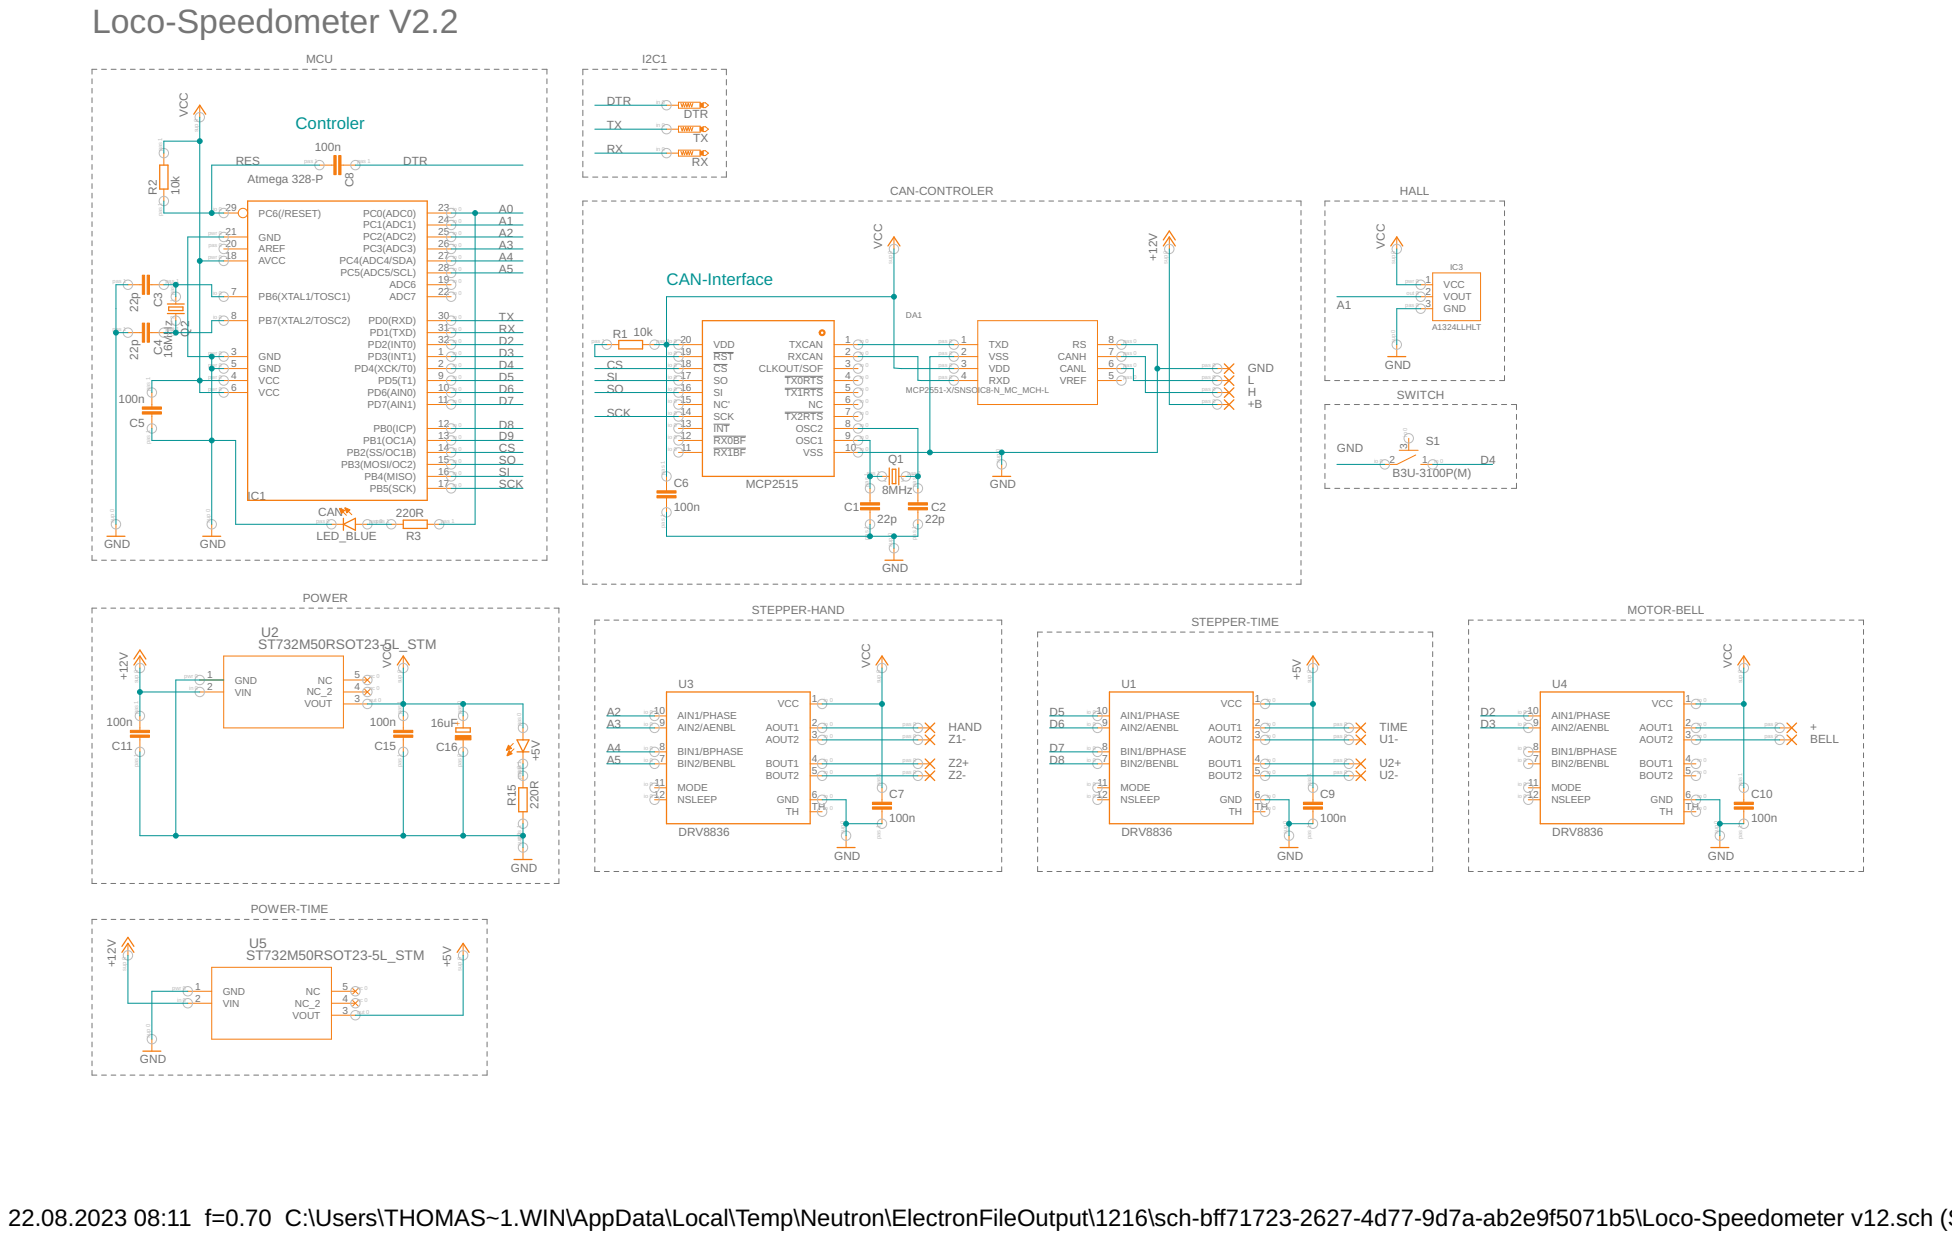
[picture p35: page 1]

sup 0 pas 1 pas 1 pas 0 pas 0

22.08.2023 08:11 f=0.70 C:\Users\THOMAS~1.WIN\AppData\Local\Temp\Neutron\ElectronFileOutput\1216\sch-bff71723-2627-4d77-9d7a-ab2e9f5071b5\Loco-Speedometer v12.sch (Sheet: 1/2)
