loco-can/loco-can-hardware/V2.x/Control Adapter/Loco-Control-Adapter.pdf

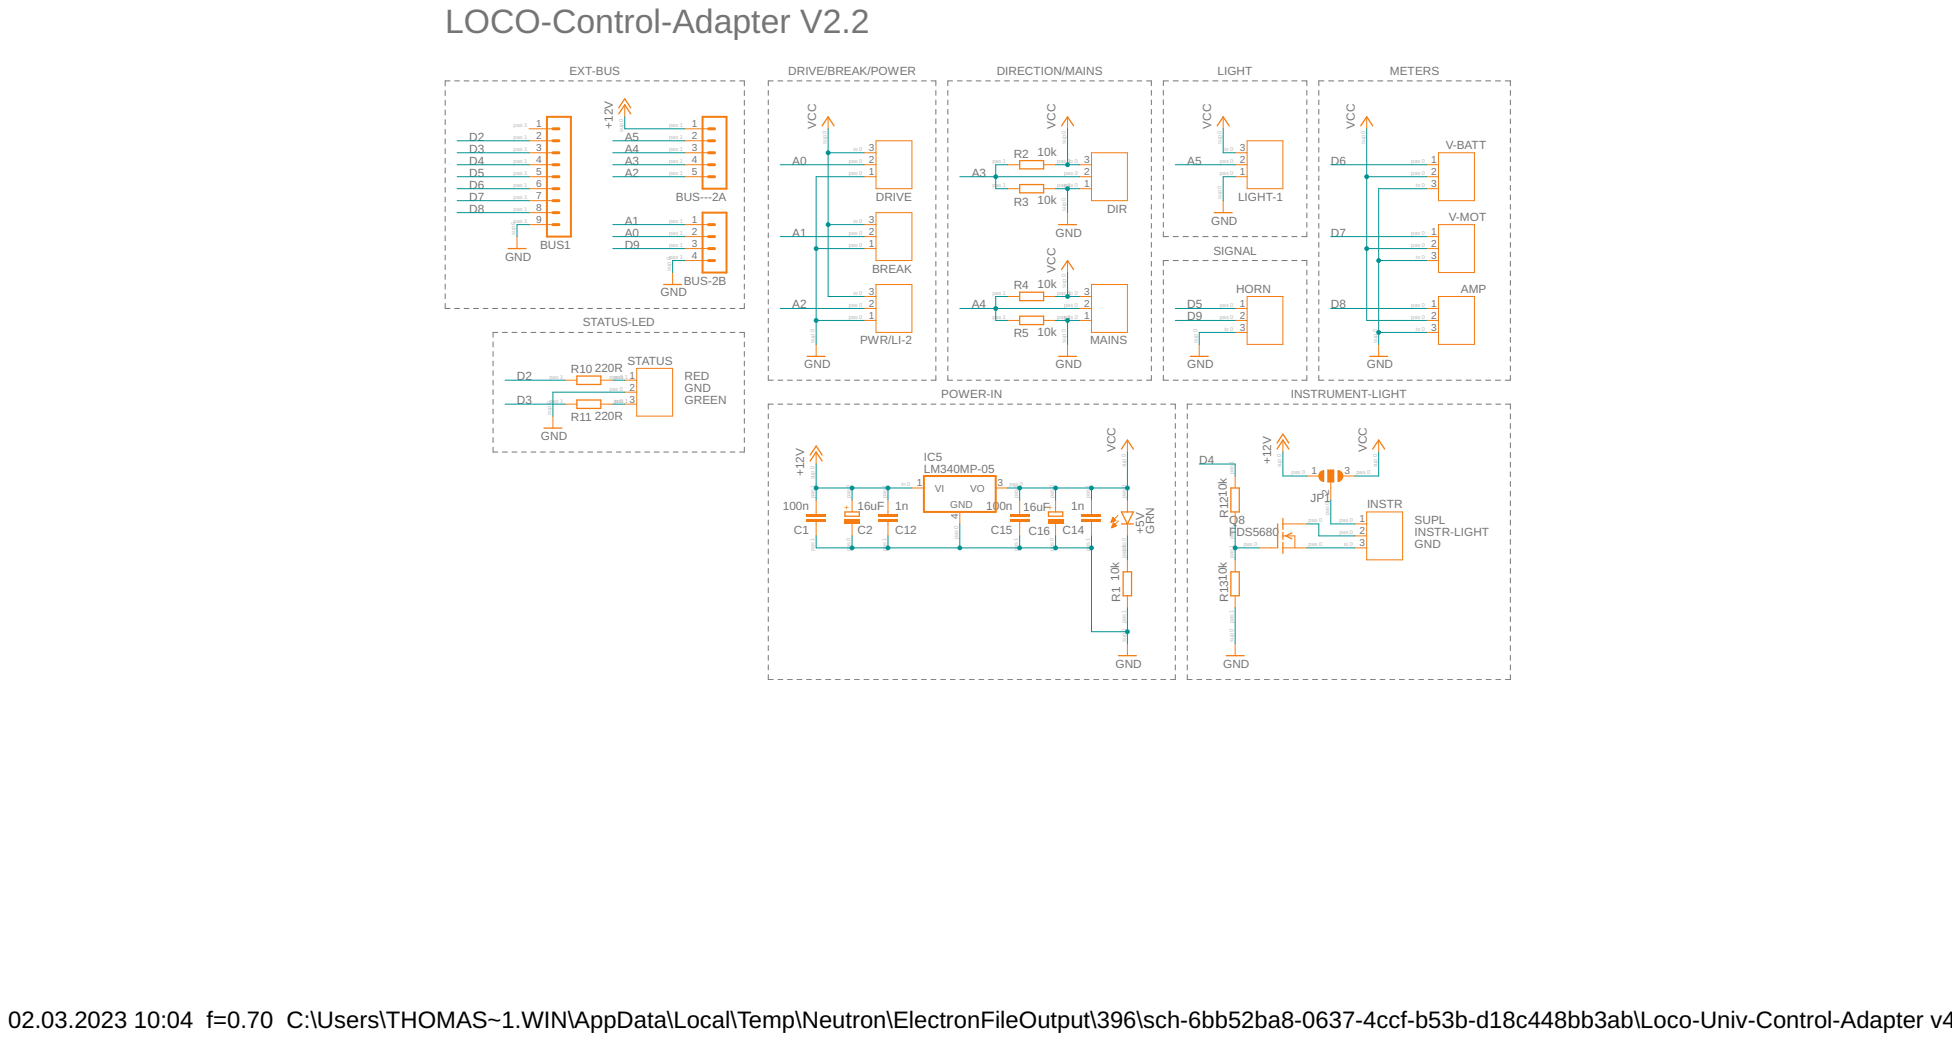
[picture p36: page 1]

pas 0 2

pas 1 pas 1 pas 1 pas 1 sup 0

sup 0 pas 1 pas 1 pas 0 pas

02.03.2023 10:04 f=0.70 C:\Users\THOMAS~1.WIN\AppData\Local\Temp\Neutron\ElectronFileOutput\396\sch-6bb52ba8-0637-4ccf-b53b-d18c448bb3ab\Loco-Univ-Control-Adapter v4.sch (Sheet: 1/2)
