loco-can/loco-can-hardware/V2.x/Single/Loco-Single.pdf

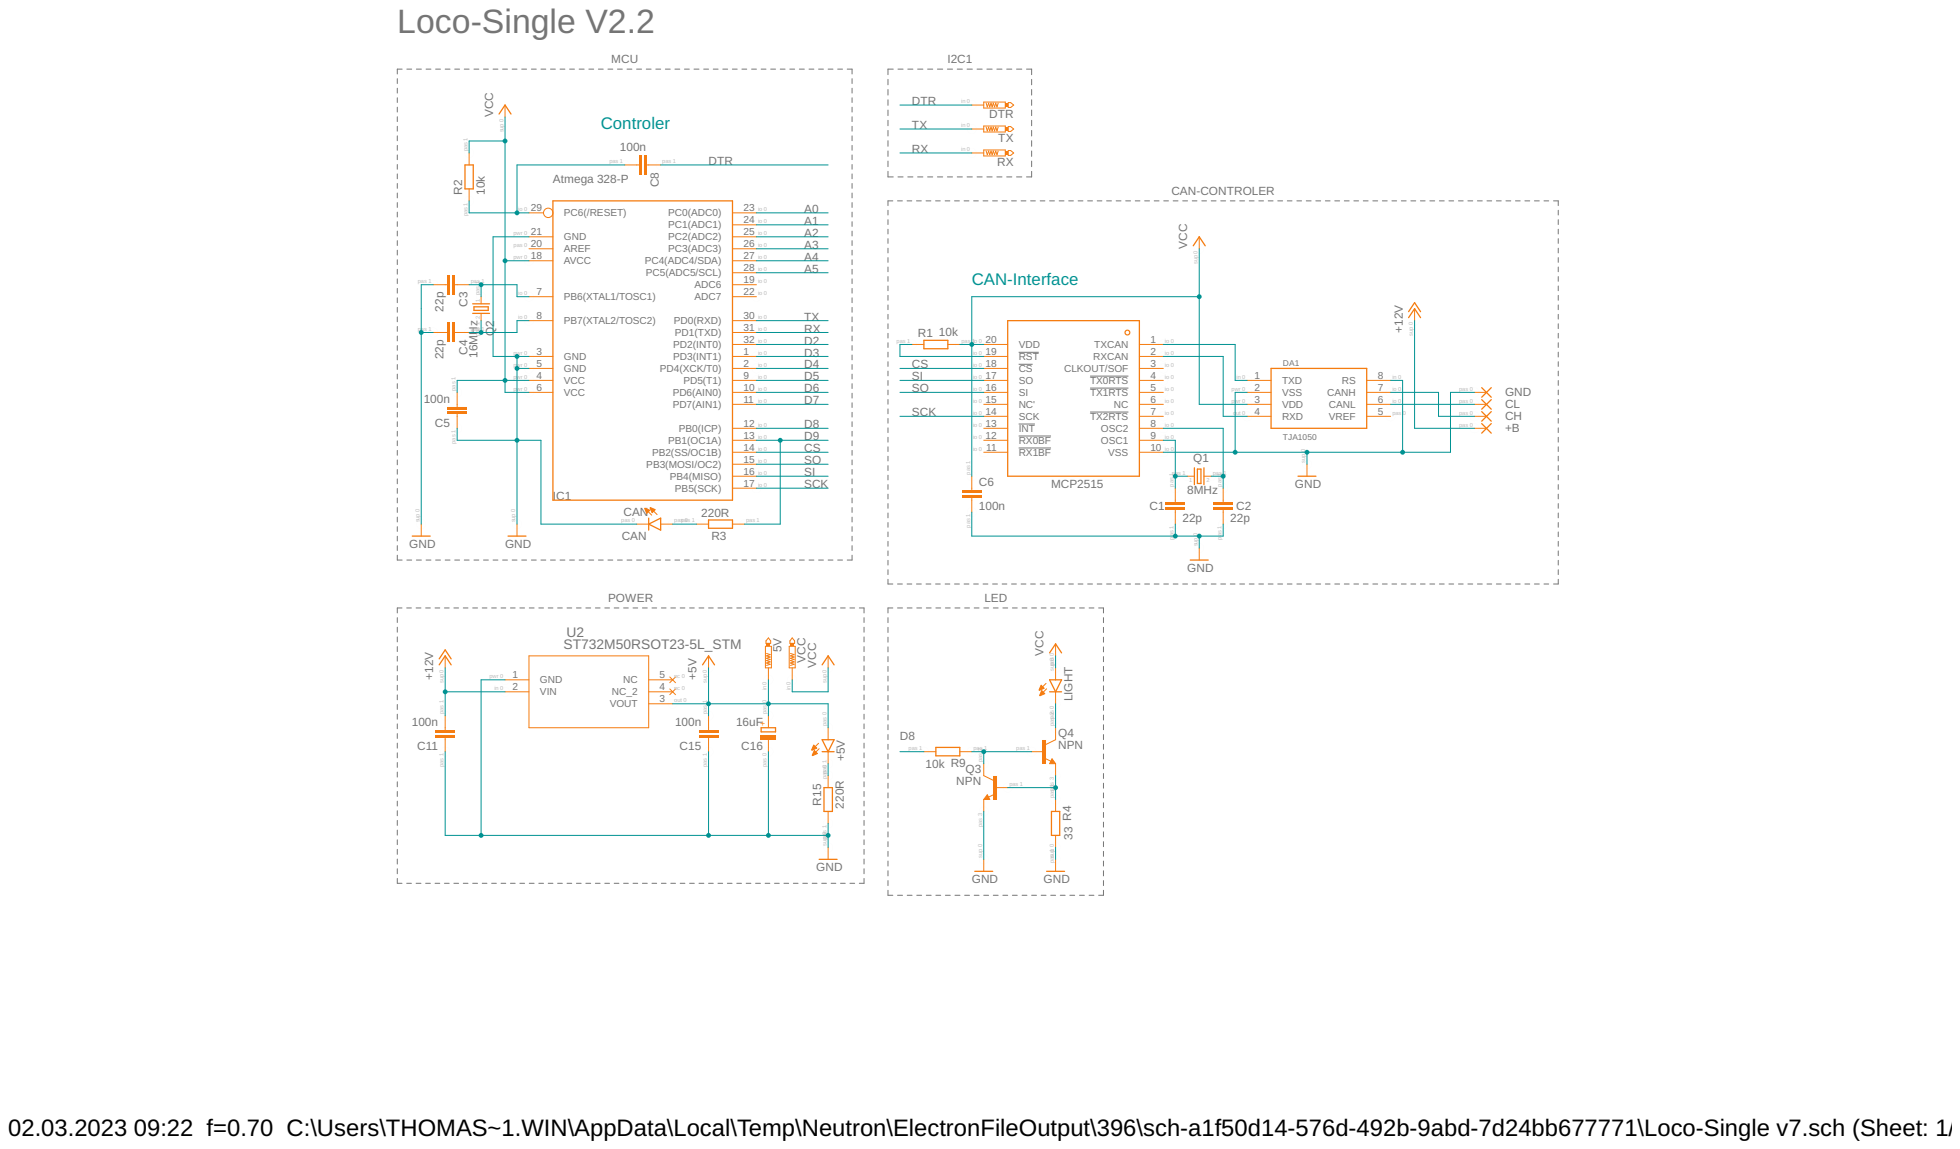
[picture p37: page 1]

pas 1 pas 1 pas 0 pas 0

pas 3 pas 2 pas 1 pas 1

02.03.2023 09:22 f=0.70 C:\Users\THOMAS~1.WIN\AppData\Local\Temp\Neutron\ElectronFileOutput\396\sch-a1f50d14-576d-492b-9abd-7d24bb677771\Loco-Single v7.sch (Sheet: 1/2)
