loco-can/loco-can-hardware/V2.x/Split/Loco-Split.pdf

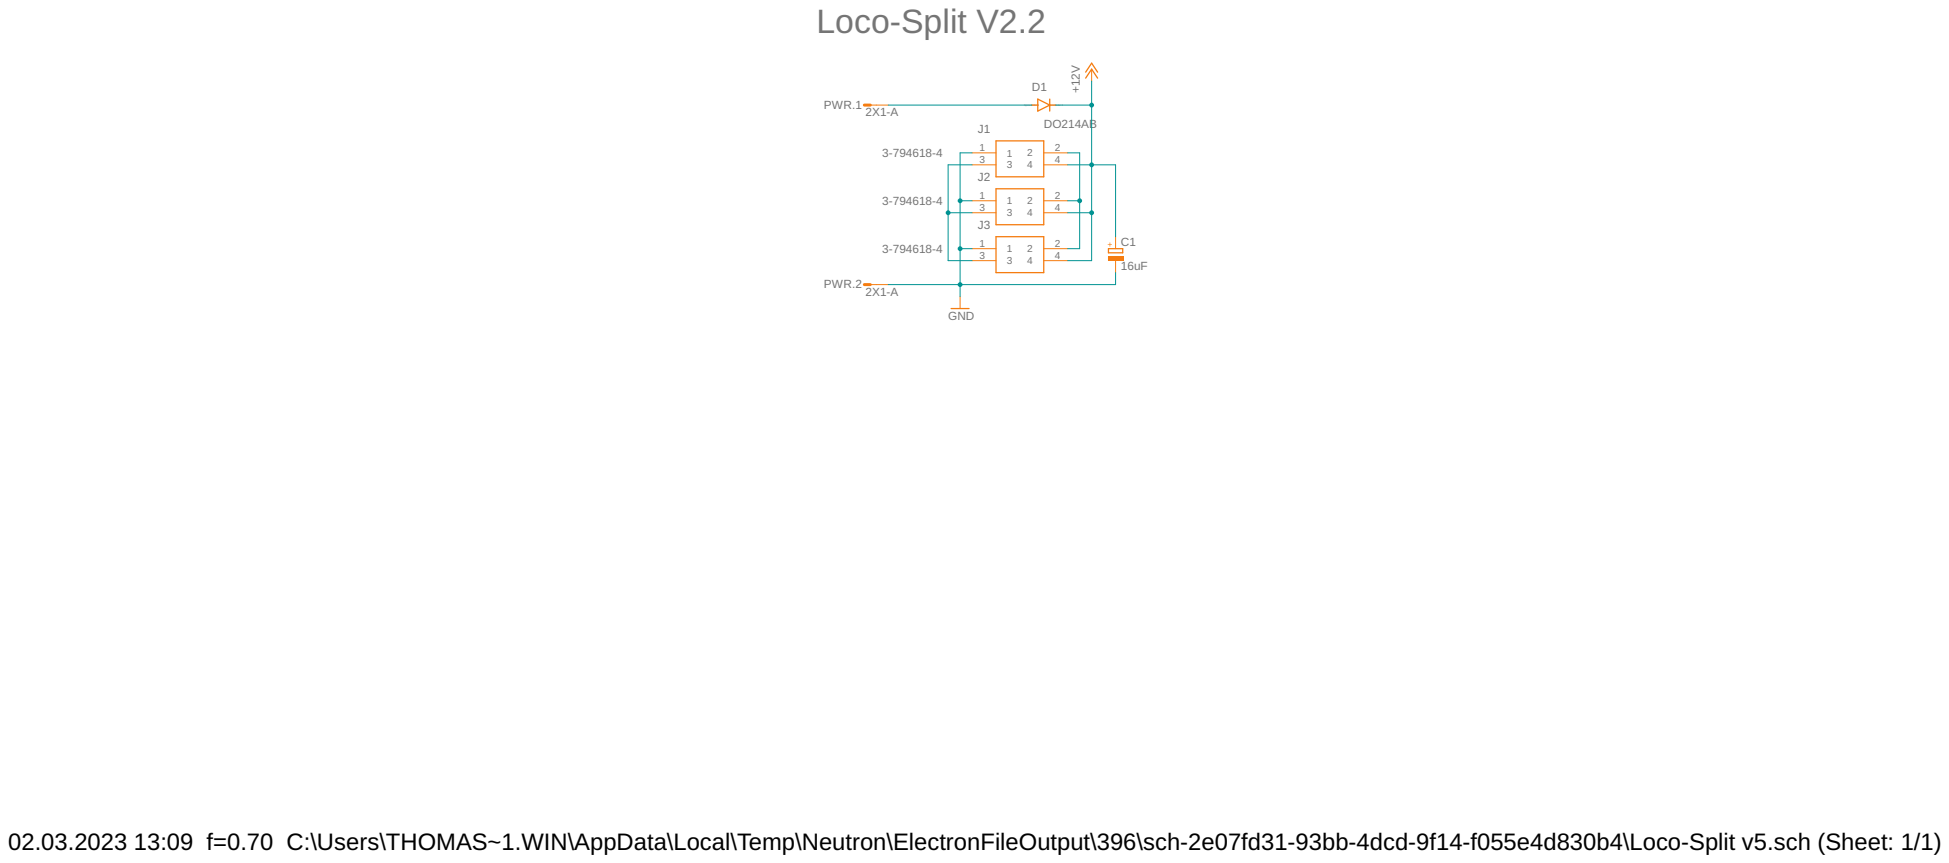
[picture p38: page 1]

02.03.2023 13:09 f=0.70 C:\Users\THOMAS~1.WIN\AppData\Local\Temp\Neutron\ElectronFileOutput\396\sch-2e07fd31-93bb-4dcd-9f14-f055e4d830b4\Loco-Split v5.sch (Sheet: 1/1)
