loco-can/loco-can-hardware/V2.x/Speedometer/Loco-Speedometer.brd

## EAGLE design V2.x/Speedometer/Loco-Speedometer.brd (2023-09-08, an earlier design)

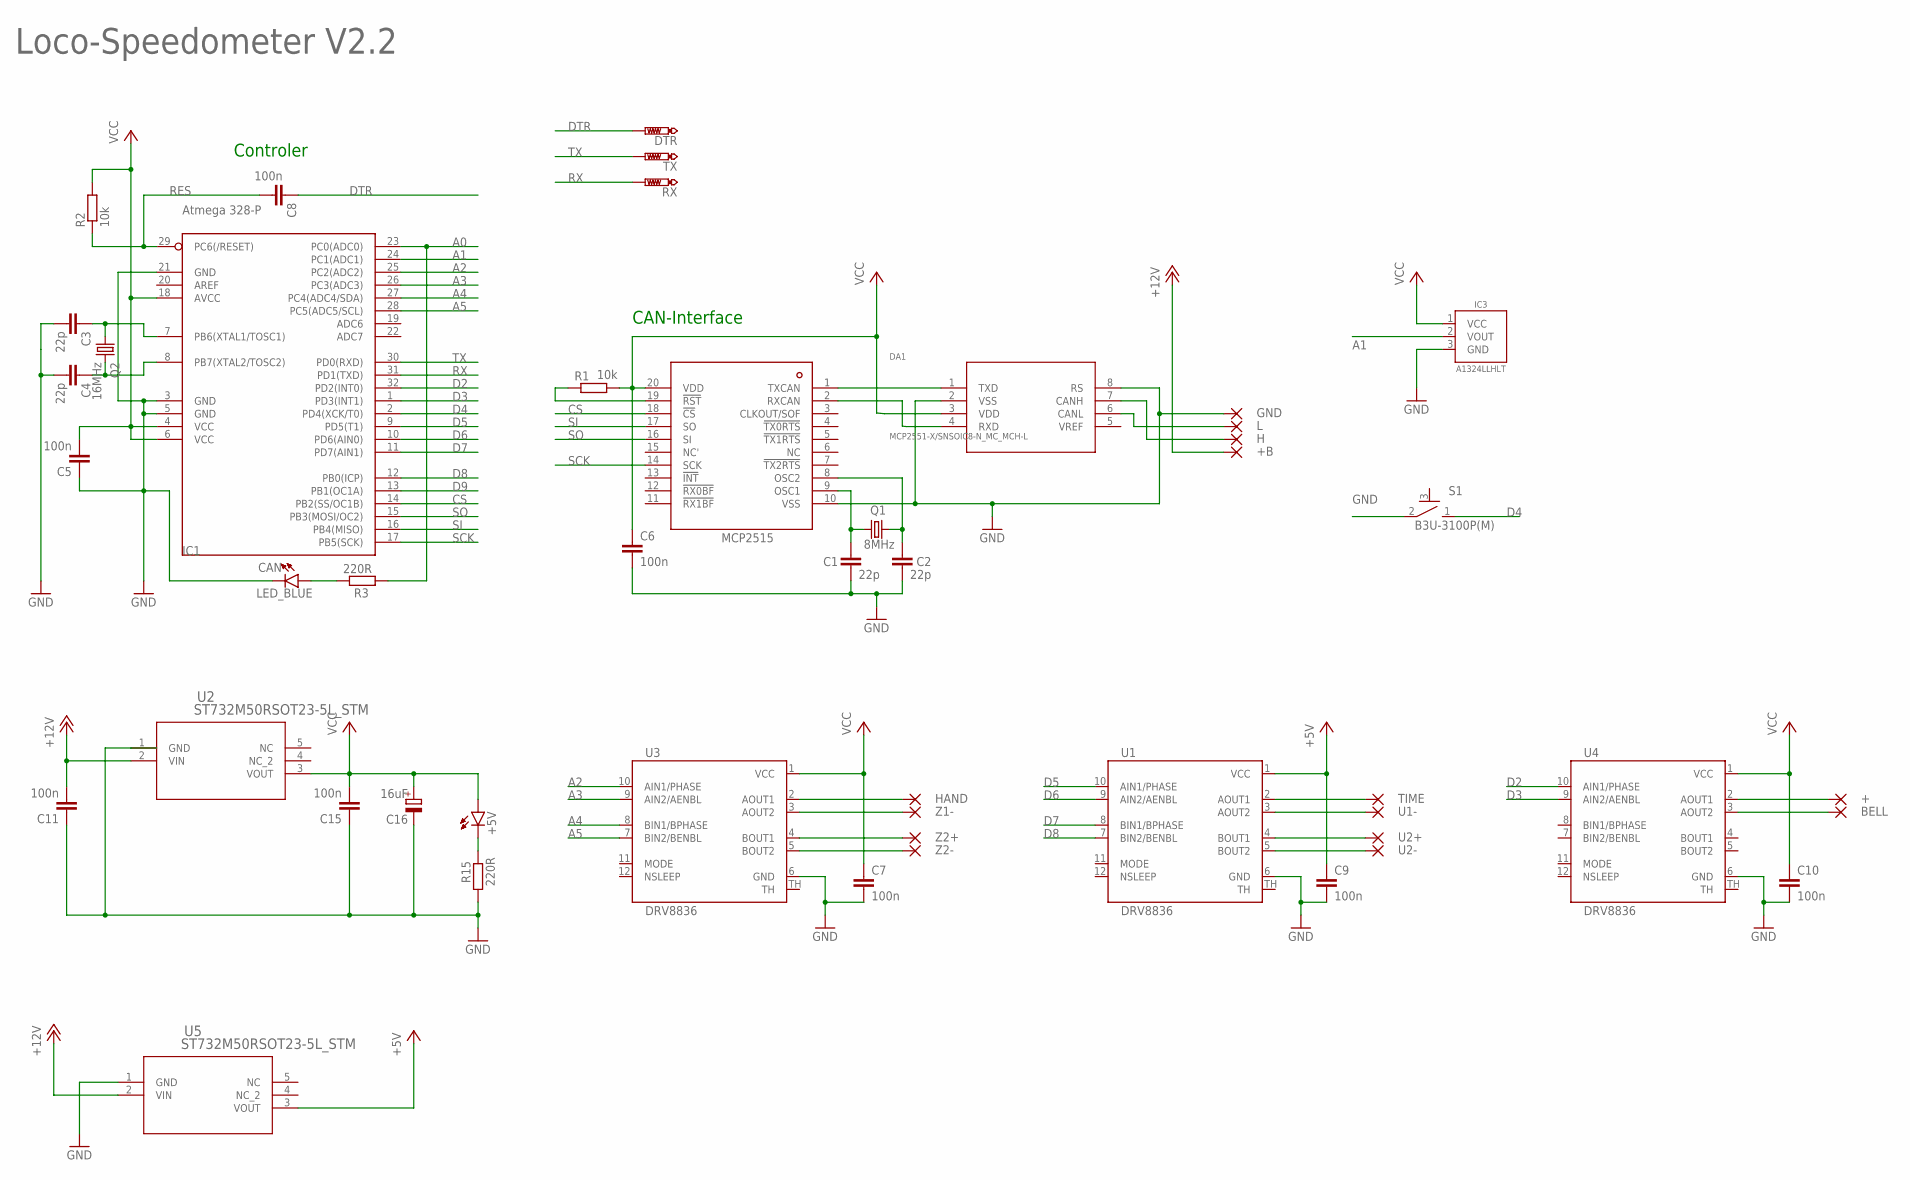
[picture p39: schematic Loco-Speedometer.sch, sheet 1]

Parts:
+: SMD1; SMD1,27-1,90
+5V: LEDCHIP-LED0603; CHIP-LED0603
+B: SMD1; SMD1,27-1,90
BELL: SMD1; SMD1,27-1,90
C1, C2, C3, C4: 22p; C0402K
C5, C6, C7, C8, C9, C10, C11, C15: 100n; C0402K
C16: 16uF; A/3216-18W
CAN: LED_BLUE; LEDC1608X39N_B
DA1: MCP2551-X/SNSOIC8-N_MC_MCH-L; SOIC8-N_MC_MCH-L
DTR: PTR1B1,27; B1,27
GND: SMD1; SMD1,27-1,90
H: SMD1; SMD1,27-1,90
HAND: SMD1; SMD1,27-1,90
IC1: Atmega 328-P; TQFP32-08
IC2: MCP2515; TSSOP20
IC3: A1324LLHLT; SOT95P285X113-3N
L: SMD1; SMD1,27-1,90
Q1: 8MHz; 5.0X3.2_2
Q2: 16MHz; 5.0X3.2_2
R1, R2: 10k; R0402
R3, R15: 220R; R0402
RX: PTR1B1,27; B1,27
S1: B3U-3100P(M)
TIME: SMD1; SMD1,27-1,90
TX: PTR1B1,27; B1,27
U1, U3, U4: DRV8836; 12WSON
U1-, U2+, U2-: SMD1; SMD1,27-1,90
U2, U5: ST732M50RSOT23-5L_STM; SOT23-5L_STM
Z1-, Z2+, Z2-: SMD1; SMD1,27-1,90

Connections:
+5V: C9.1, U1.1 (VCC), U5.3 (VOUT)
+12V: +B.1, C11.2, U2.2 (VIN), U5.2 (VIN)
A0: IC1.23 (PC0(ADC0)), R3.1
A1: IC1.24 (PC1(ADC1)), IC3.2 (VOUT)
A2: IC1.25 (PC2(ADC2)), U3.10 (AIN1/PHASE)
A3: IC1.26 (PC3(ADC3)), U3.9 (AIN2/AENBL)
A4: IC1.27 (PC4(ADC4/SDA)), U3.8 (BIN1/BPHASE)
A5: IC1.28 (PC5(ADC5/SCL)), U3.7 (BIN2/BENBL)
CAN-H: DA1.7 (CANH), H.1
CAN-L: DA1.6 (CANL), L.1
CAN-OCC1: C1.1, IC2.9 (OSC1), Q1.1
CAN-OCC2: C2.1, IC2.8 (OSC2), Q1.2
CS: IC1.14 (PB2(SS/OC1B)), IC2.18 (!CS)
D2: IC1.32 (PD2(INT0)), U4.10 (AIN1/PHASE)
D3: IC1.1 (PD3(INT1)), U4.9 (AIN2/AENBL)
D4: IC1.2 (PD4(XCK/T0)), S1.1 (2)
D5: IC1.9 (PD5(T1)), U1.10 (AIN1/PHASE)
D6: IC1.10 (PD6(AIN0)), U1.9 (AIN2/AENBL)
D7: IC1.11 (PD7(AIN1)), U1.8 (BIN1/BPHASE)
D8: IC1.12 (PB0(ICP)), U1.7 (BIN2/BENBL)
D9: IC1.13 (PB1(OC1A))
DTR: C8.1, DTR.TP
GND: C1.2, C2.2, C3.2, C4.2, C5.1, C6.2, C7.2, C9.2, C10.2, C11.1, C15.1, C16.-, CAN.1 (C), DA1.2 (VSS), DA1.8 (RS), GND.1, IC1.3 (GND), IC1.5 (GND), IC1.21 (GND), IC2.10 (VSS), IC3.3 (GND), R15.1, S1.2 (1), U1.6 (GND), U2.1 (GND), U3.6 (GND), U4.6 (GND), U5.1 (GND)
unnamed: CAN.2 (A), R3.2
unnamed: IC2.19 (!RST), R1.1
unnamed: C7.1, U3.1 (VCC)
unnamed: C3.1, IC1.7 (PB6(XTAL1/TOSC1)), Q2.1
unnamed: C4.1, IC1.8 (PB7(XTAL2/TOSC2)), Q2.2
unnamed: +5V.C, R15.2
RES: C8.2, IC1.29 (PC6(/RESET)), R2.1
RX: IC1.31 (PD1(TXD)), RX.TP
RXCAN: DA1.4 (RXD), IC2.2 (RXCAN)
SCK: IC1.17 (PB5(SCK)), IC2.14 (SCK)
SI: IC1.16 (PB4(MISO)), IC2.17 (SO)
SO: IC1.15 (PB3(MOSI/OC2)), IC2.16 (SI)
TX: IC1.30 (PD0(RXD)), TX.TP
TXCAN: DA1.1 (TXD), IC2.1 (TXCAN)
U1+: TIME.1, U1.2 (AOUT1)
U1+1: +.1, U4.2 (AOUT1)
U1-: U1.3 (AOUT2), U1-.1
U1-1: BELL.1, U4.3 (AOUT2)
U2+: U1.4 (BOUT1), U2+.1
U2-: U1.5 (BOUT2), U2-.1
VCC: +5V.A, C5.2, C6.1, C10.1, C15.2, C16.+, DA1.3 (VDD), IC1.4 (VCC), IC1.6 (VCC), IC1.18 (AVCC), IC2.20 (VDD), IC3.1 (VCC), R1.2, R2.2, U2.3 (VOUT), U4.1 (VCC)
Z1+: HAND.1, U3.2 (AOUT1)
Z1-: U3.3 (AOUT2), Z1-.1
Z2+: U3.4 (BOUT1), Z2+.1
Z2-: U3.5 (BOUT2), Z2-.1

Notes on the sheet:
CAN-Interface
Controler
Loco-Speedometer V2.2

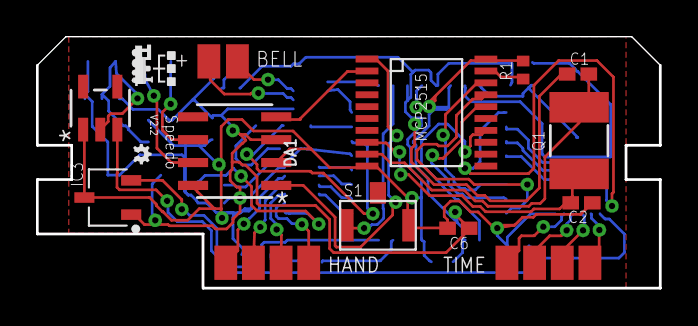
[picture p40: board Loco-Speedometer.brd from above]

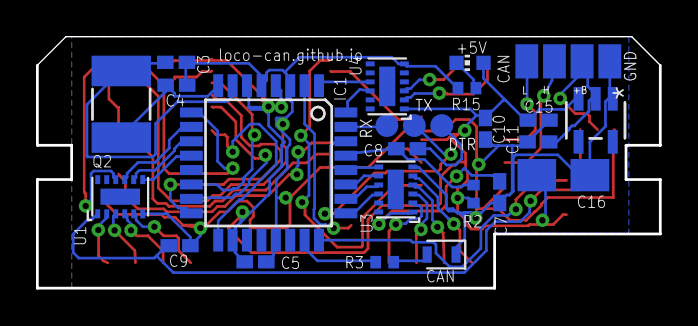
[picture p41: board Loco-Speedometer.brd from below]

Board: 2 copper layers, 34.6 x 14.0 mm, 48 parts (28 on the bottom side), 47 nets.
