loco-can/loco-can-hardware/V2.x/Motor/Loco-Motor.brd

## EAGLE design V2.x/Motor/Loco-Motor.brd (2023-04-18, an earlier design)

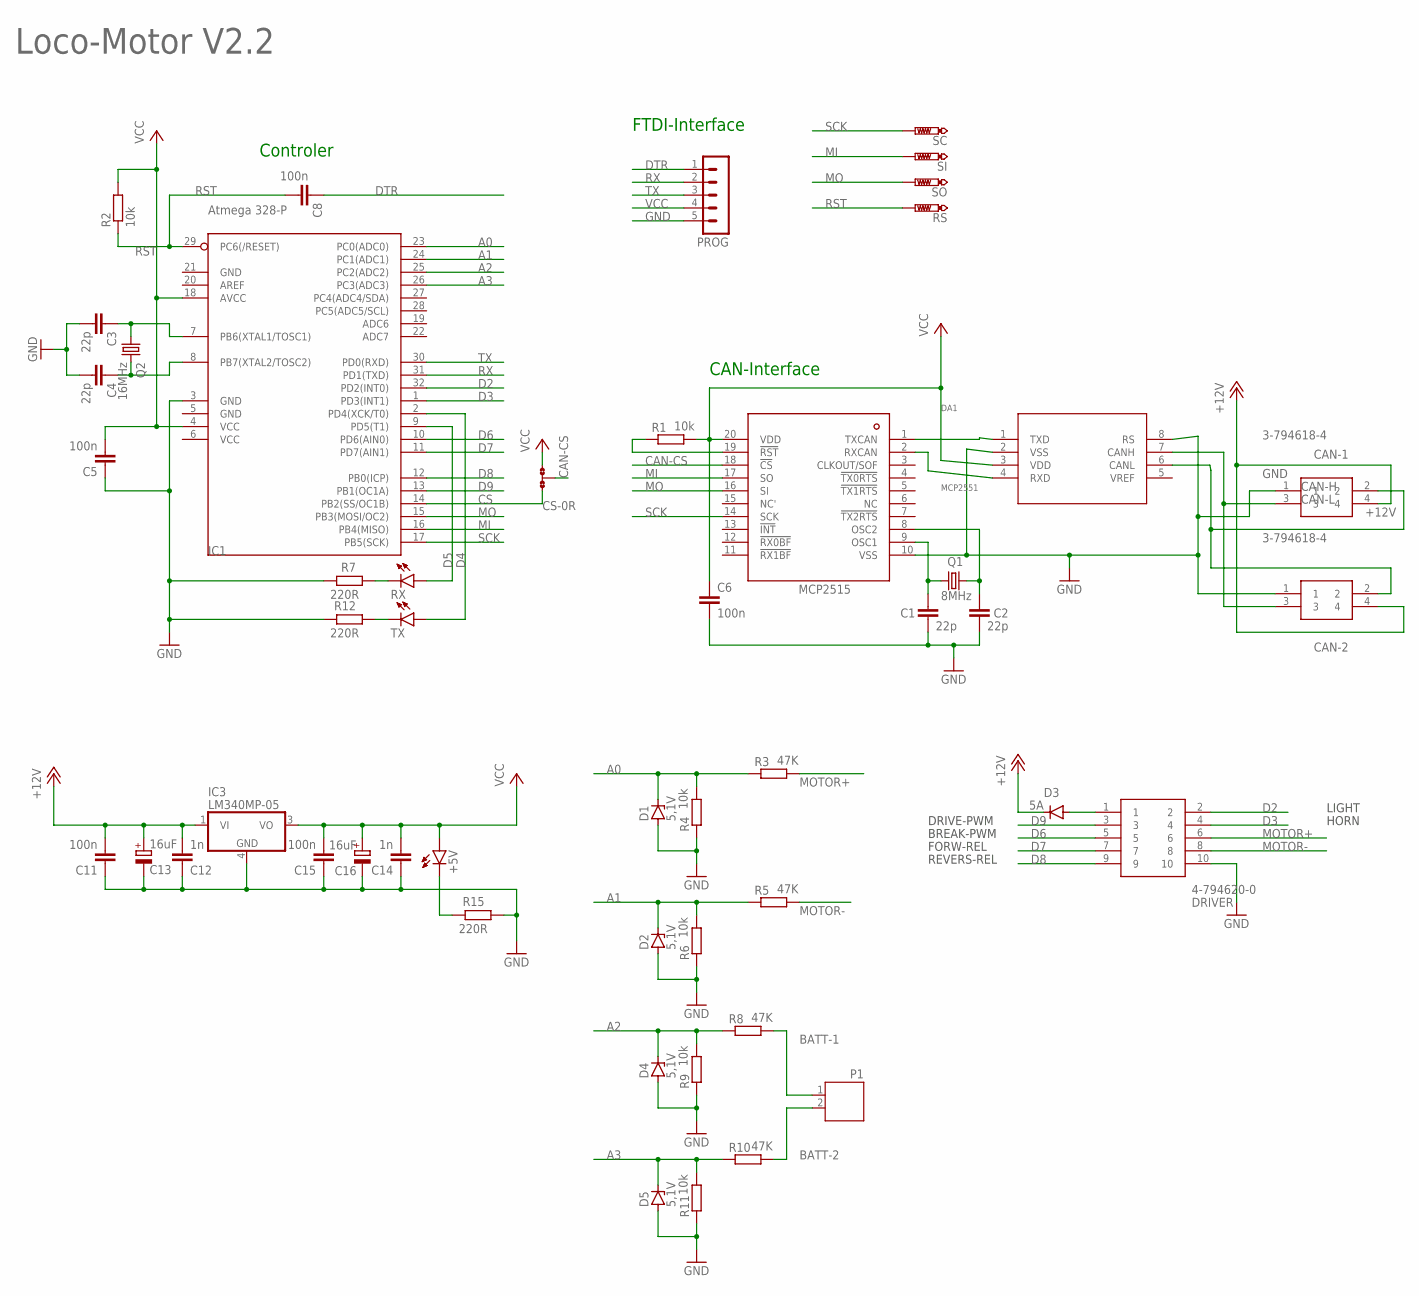
[picture p42: schematic Loco-Motor.sch, sheet 1]

Parts:
+5V: LEDCHIP-LED0603; CHIP-LED0603
C1, C2, C3, C4: 22p; C0402K
C5, C6, C8, C11, C15: 100n; C0402K
C12, C14: 1n; C0402K
C13, C16: 16uF; A/3216-18W
CAN-1, CAN-2: 3-794618-4
CS: 0R-JUMPA; A0R-JMP
D1, D2, D4, D5: 5,1V; SOD80C
D3: 5A; DO214AA
DA1: MCP2551; SOIC8-N_MC_MCH
DRIVER: 4-794620-0; 47946200
IC1: Atmega 328-P; TQFP32-08
IC2: MCP2515; TSSOP20
IC3: LM340MP-05; SOT223
P1: JST-PH2
PROG: MA05-1
Q1: 8MHz; HC49/S
Q2: 16MHz; HC49/S
R1, R2: 10k; R0805
R3, R5, R8, R10: 47K; MINI_MELF-0102W
R4, R6, R9, R11: 10k; MINI_MELF-0102W
R7, R12, R15: 220R; R0805
RS: PTR1B1,27; B1,27
RX: LEDCHIP-LED0603; CHIP-LED0603
SC: PTR1B1,27; B1,27
SI: PTR1B1,27; B1,27
SO: PTR1B1,27; B1,27
TX: LEDCHIP-LED0603; CHIP-LED0603

Connections:
+12V: C11.2, C12.2, C13.+, CAN-1.4, CAN-2.4, D3.C, IC3.1 (VI)
A0: D1.C, IC1.23 (PC0(ADC0)), R3.1, R4.2
A1: D2.C, IC1.24 (PC1(ADC1)), R5.1, R6.2
A2: D4.C, IC1.25 (PC2(ADC2)), R8.1, R9.2
A3: D5.C, IC1.26 (PC3(ADC3)), R10.1, R11.2
BATT-1: P1.1, R8.2
BATT-2: P1.2, R10.2
CAN-CS: CS.2, IC2.18 (!CS)
CAN-H: CAN-1.3, CAN-2.3, DA1.7 (CANH)
CAN-L: CAN-1.2, CAN-2.2, DA1.6 (CANL)
CAN-OCC1: C1.1, IC2.9 (OSC1), Q1.1
CAN-OCC2: C2.1, IC2.8 (OSC2), Q1.2
CS: CS.3, IC1.14 (PB2(SS/OC1B))
D2: DRIVER.2, IC1.32 (PD2(INT0))
D3: DRIVER.4, IC1.1 (PD3(INT1))
D4: IC1.2 (PD4(XCK/T0)), TX.A
D5: IC1.9 (PD5(T1)), RX.A
D6: DRIVER.5, IC1.10 (PD6(AIN0))
D7: DRIVER.7, IC1.11 (PD7(AIN1))
D8: DRIVER.9, IC1.12 (PB0(ICP))
D9: DRIVER.3, IC1.13 (PB1(OC1A))
DTR: C8.1, PROG.1
GND: C1.2, C2.2, C3.2, C4.2, C5.1, C6.2, C11.1, C12.1, C13.-, C14.1, C15.1, C16.-, CAN-1.1, CAN-2.1, D1.A, D2.A, D4.A, D5.A, DA1.2 (VSS), DA1.8 (RS), DRIVER.10, IC1.3 (GND), IC1.5 (GND), IC1.21 (GND), IC2.10 (VSS), IC3.4 (GND), PROG.5, R4.1, R6.1, R7.2, R9.1, R11.1, R12.2, R15.1
MI: IC1.16 (PB4(MISO)), IC2.17 (SO), SI.TP
MO: IC1.15 (PB3(MOSI/OC2)), IC2.16 (SI), SO.TP
MOTOR+: DRIVER.6, R3.2
MOTOR-: DRIVER.8, R5.2
unnamed: D3.A, DRIVER.1
unnamed: R7.1, RX.C
unnamed: R12.1, TX.C
unnamed: IC2.19 (!RST), R1.1
unnamed: C3.1, IC1.7 (PB6(XTAL1/TOSC1)), Q2.1
unnamed: C4.1, IC1.8 (PB7(XTAL2/TOSC2)), Q2.2
unnamed: +5V.C, R15.2
RST: C8.2, IC1.29 (PC6(/RESET)), R2.1, RS.TP
RX: IC1.31 (PD1(TXD)), PROG.2
RXCAN: DA1.4 (RXD), IC2.2 (RXCAN)
SCK: IC1.17 (PB5(SCK)), IC2.14 (SCK), SC.TP
TX: IC1.30 (PD0(RXD)), PROG.3
TXCAN: DA1.1 (TXD), IC2.1 (TXCAN)
VCC: +5V.A, C5.2, C6.1, C14.2, C15.2, C16.+, CS.1, DA1.3 (VDD), IC1.4 (VCC), IC1.6 (VCC), IC1.18 (AVCC), IC2.20 (VDD), IC3.3 (VO), PROG.4, R1.2, R2.2

Notes on the sheet:
FTDI-Interface
CAN-Interface
Controler
DRIVE-PWM
BREAK-PWM
LIGHT
FORW-REL
REVERS-REL
HORN
Loco-Motor V2.2

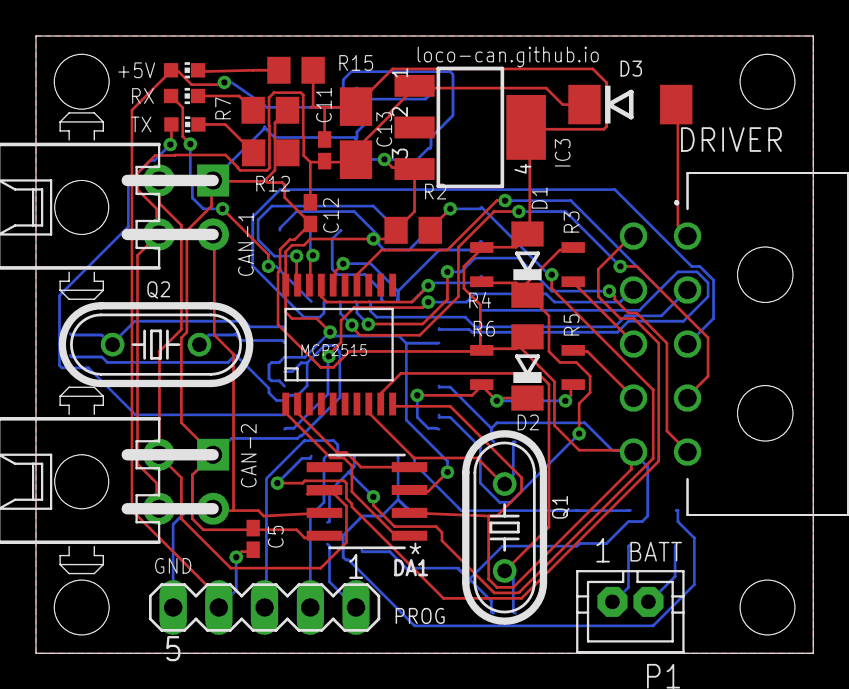
[picture p43: board Loco-Motor.brd from above]

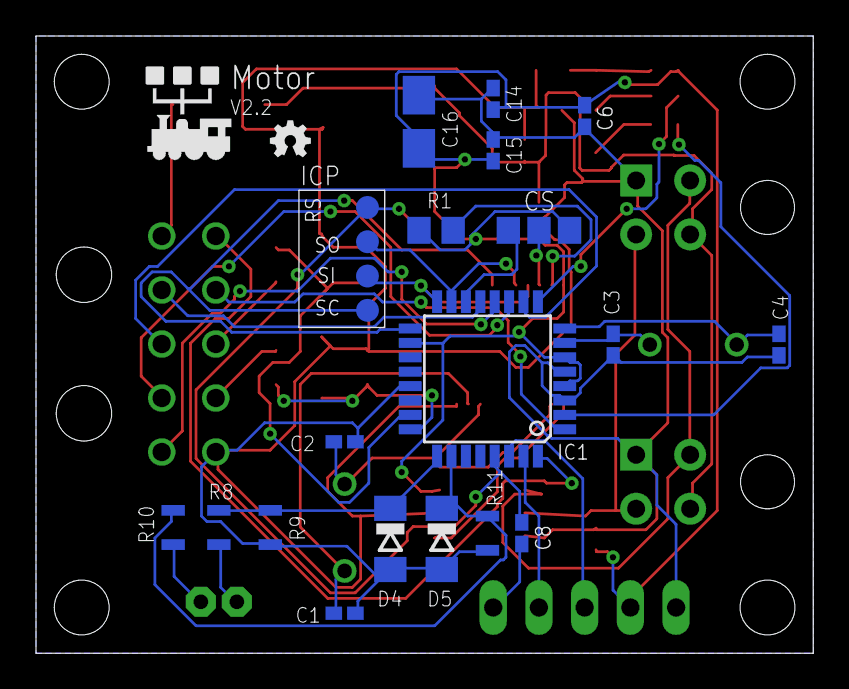
[picture p44: board Loco-Motor.brd from below]

Board: 2 copper layers, 43.2 x 34.3 mm, 50 parts (22 on the bottom side), 41 nets.
