loco-can/loco-can-hardware/V2.x/Micro/Loco-Micro.brd

## EAGLE design V2.x/Micro/Loco-Micro.brd (2023-04-18, an earlier design)

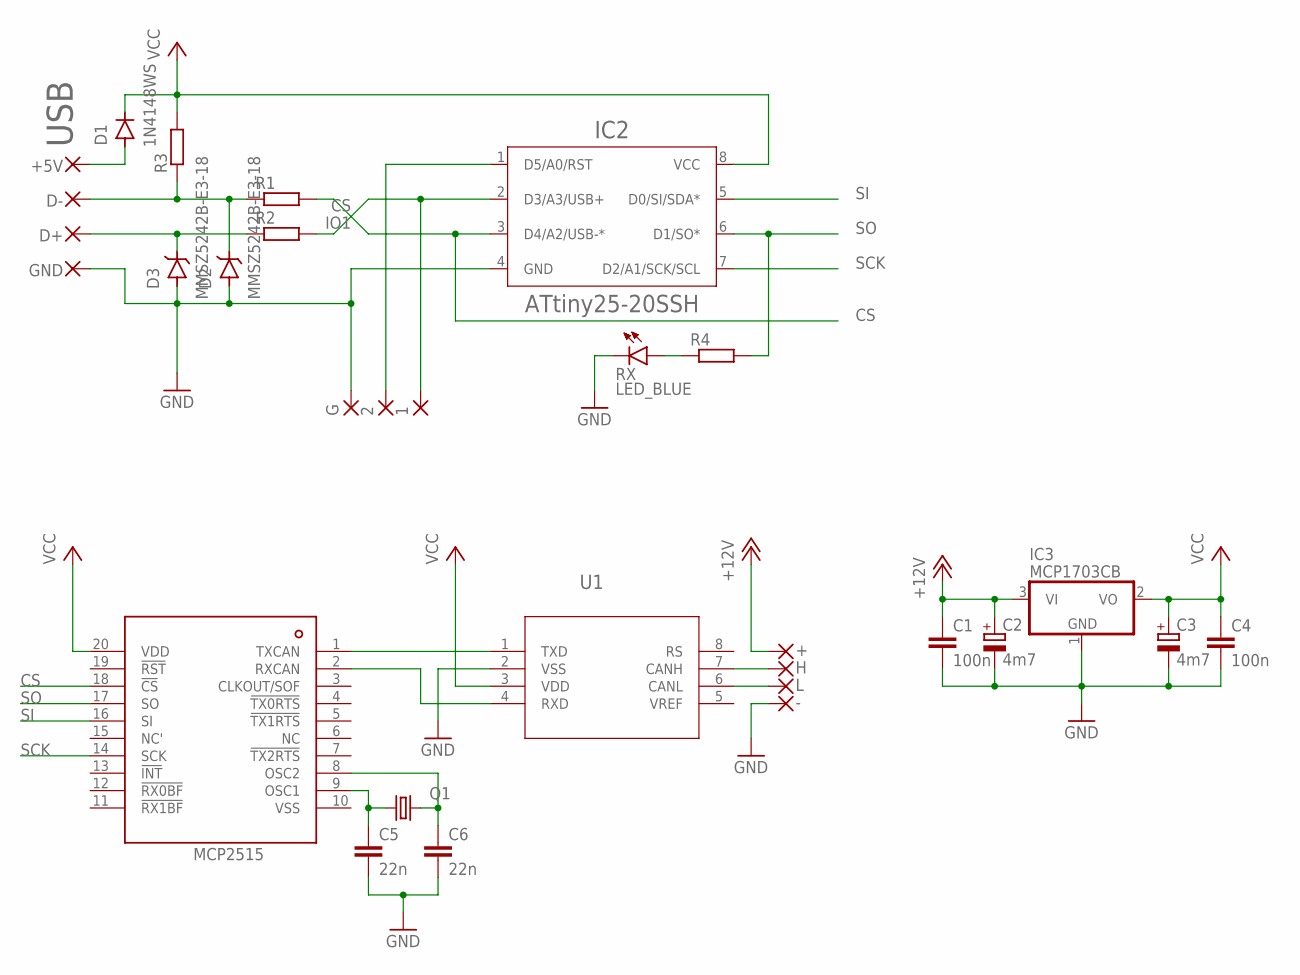
[picture p45: schematic Loco-Micro.sch]

Parts:
1, 2: 1,6/0,8
+: 1,6/0,8
+5V: SMD2; SMD1,27-2,54
-: 1,6/0,8
C1, C4: 100n; C0402K
C2, C3: 4m7; CT3216
C5, C6: 22n; C0402K
D1: 1N4148WS; SOD-323
D2, D3: MMSZ5242B-E3-18; SOD-123
D+: SMD2; SMD1,27-2,54
D-: SMD2; SMD1,27-2,54
G: 1,6/0,8
GND: SMD2; SMD1,27-2,54
H: 1,6/0,8
IC2: ATtiny25-20SSH; SOIC127P600X175-8N
IC3: MCP1703CB; SOT23
L: 1,6/0,8
Q1: KX-9A; 5.0X3.2_KX-9A
R1, R2, R3, R4: R-EU_R0402; R0402
RX: LED_BLUE; LEDC1005X25N_FLAT-B
U1: MCP2551-X/SNSOIC8-N_MC_MCH-L; SOIC8-N_MC_MCH-L
U$2: MCP2515; TSSOP20

Connections:
+12V: +.1, C1.1, C2.+, IC3.3 (VI)
CS: IC2.3 (D4/A2/USB-*), R1.2, U$2.18 (!CS)
GND: -.1, C1.2, C2.-, C3.-, C4.2, C5.2, C6.2, D2.A, D3.A, G.1, GND.1, IC2.4 (GND), IC3.1 (GND), RX.C, U1.2 (VSS)
IO1: 1.1, IC2.2 (D3/A3/USB+), R2.2
IO2: 2.1, IC2.1 (D5/A0/RST)
unnamed: C6.1, Q1.3 (2), U$2.8 (OSC2)
unnamed: R4.1, RX.A
unnamed: U1.1 (TXD), U$2.1 (TXCAN)
unnamed: U1.4 (RXD), U$2.2 (RXCAN)
unnamed: H.1, U1.7 (CANH)
unnamed: L.1, U1.6 (CANL)
unnamed: C5.1, Q1.1, U$2.9 (OSC1)
SCK: IC2.7 (D2/A1/SCK/SCL), U$2.14 (SCK)
SI: IC2.5 (D0/SI/SDA*), U$2.16 (SI)
SO: IC2.6 (D1/SO*), R4.2, U$2.17 (SO)
USB_5V: +5V.1, D1.A
USB_D+: D3.C, D+.1, R2.1
USB_D-: D2.C, D-.1, R1.1, R3.1
VCC: C3.+, C4.1, D1.C, IC2.8 (VCC), IC3.2 (VO), R3.2, U1.3 (VDD), U$2.20 (VDD)

Notes on the sheet:
USB

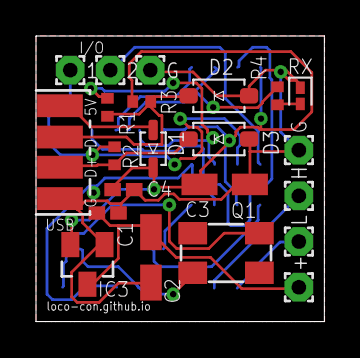
[picture p46: board Loco-Micro.brd from above]

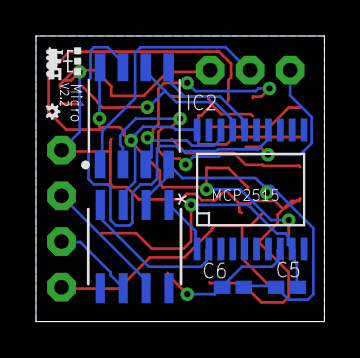
[picture p47: board Loco-Micro.brd from below]

Board: 2 copper layers, 16.0 x 15.9 mm, 30 parts (5 on the bottom side), 19 nets.
