loco-can/loco-can-hardware/V2.x/Switch/LOCO-Switch.brd

## EAGLE design V2.x/Switch/LOCO-Switch.brd (2023-04-18, an earlier design)

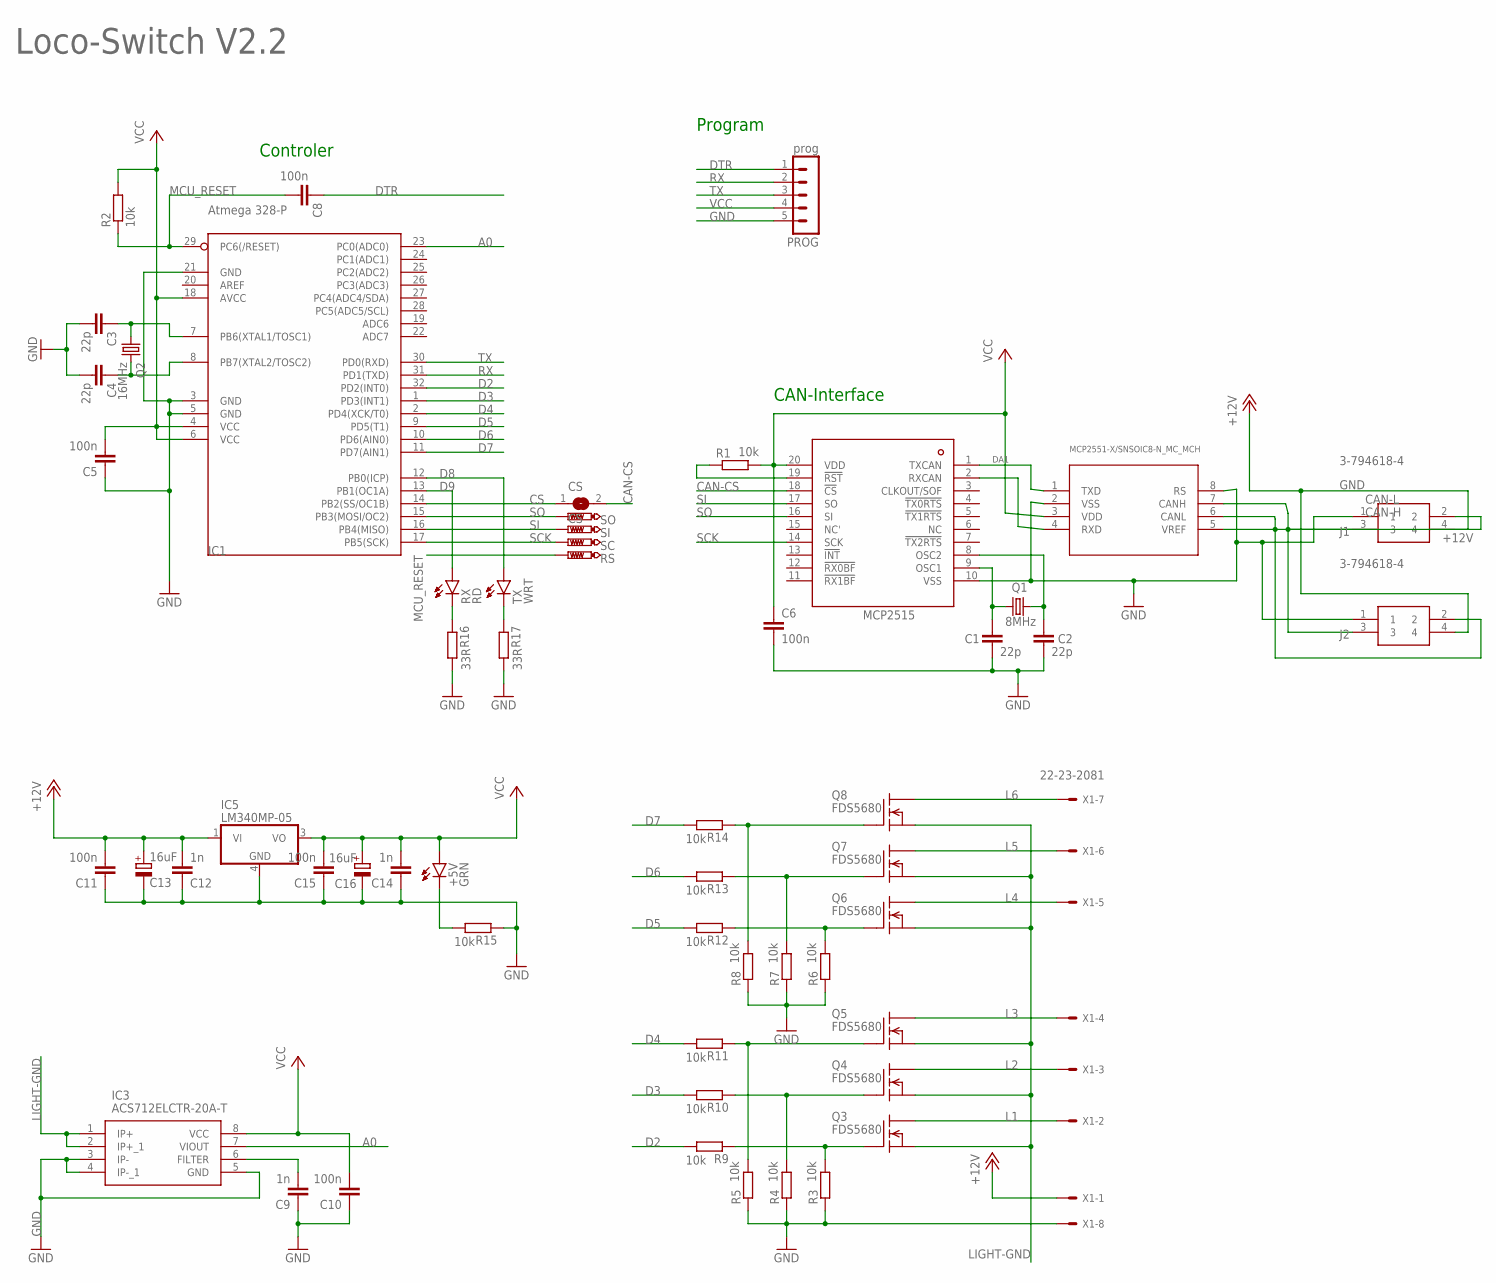
[picture p48: schematic LOCO-Switch.sch, sheet 1]

Parts:
+5V: GRN; CHIP-LED0603
C1, C2, C3, C4: 22p; C0402K
C5, C6, C8, C10, C11, C15: 100n; C0402K
C9, C12, C14: 1n; C0402K
C13, C16: 16uF; A/3216-18W
CS: CS; SJ
DA1: MCP2551-X/SNSOIC8-N_MC_MCH; SOIC8-N_MC_MCH
IC1: Atmega 328-P; TQFP32-08
IC2: MCP2515; TSSOP20
IC3: ACS712ELCTR-20A-T; SOIC127P600X175-8N
IC5: LM340MP-05; SOT223
J1, J2: 3-794618-4
PROG: prog; MA05-1
Q1: 8MHz; HC49/S
Q2: 16MHz; HC49/S
Q3, Q4, Q5, Q6, Q7, Q8: FDS5680; SO-8
R1, R2, R3, R4, R5, R6, R7, R8, R9, R10, R11, R12, R13, R14, R15: 10k; R0603
R16, R17: 33R; R0603
RS: PTR1B1,27; B1,27
RX: RD; CHIP-LED0603
SC: PTR1B1,27; B1,27
SI: PTR1B1,27; B1,27
SO: PTR1B1,27; B1,27
TX: WRT; CHIP-LED0603
X1: 22-23-2081

Connections:
+12V: C11.2, C12.2, C13.+, IC5.1 (VI), J1.4, J2.4, X1.1
A0: IC1.23 (PC0(ADC0)), IC3.7 (VIOUT)
CAN-CS: CS.2, IC2.18 (!CS)
CAN-H: DA1.7 (CANH), J1.3, J2.3
CAN-L: DA1.5 (VREF), DA1.6 (CANL), J1.2, J2.2
CAN-OCC1: C1.1, IC2.9 (OSC1), Q1.1
CAN-OCC2: C2.1, IC2.8 (OSC2), Q1.2
CS: CS.1, IC1.14 (PB2(SS/OC1B))
D2: IC1.32 (PD2(INT0)), R9.2
D3: IC1.1 (PD3(INT1)), R10.2
D4: IC1.2 (PD4(XCK/T0)), R11.2
D5: IC1.9 (PD5(T1)), R12.2
D6: IC1.10 (PD6(AIN0)), R13.2
D7: IC1.11 (PD7(AIN1)), R14.2
D8: IC1.12 (PB0(ICP)), TX.A
D9: IC1.13 (PB1(OC1A)), RX.A
DTR: C8.1, PROG.1
GND: C1.2, C2.2, C3.2, C4.2, C5.1, C6.2, C9.1, C10.1, C11.1, C12.1, C13.-, C14.1, C15.1, C16.-, DA1.2 (VSS), DA1.8 (RS), IC1.3 (GND), IC1.5 (GND), IC1.21 (GND), IC2.10 (VSS), IC3.3 (IP-), IC3.4 (IP-_1), IC3.5 (GND), IC5.4 (GND), J1.1, J2.1, PROG.5, R3.1, R4.1, R5.1, R6.1, R7.1, R8.1, R15.1, R16.2, R17.2, X1.8
L1: Q3.5 (D), Q3.6 (D), Q3.7 (D), Q3.8 (D), X1.2
L2: Q4.5 (D), Q4.6 (D), Q4.7 (D), Q4.8 (D), X1.3
L3: Q5.5 (D), Q5.6 (D), Q5.7 (D), Q5.8 (D), X1.4
L4: Q6.5 (D), Q6.6 (D), Q6.7 (D), Q6.8 (D), X1.5
L5: Q7.5 (D), Q7.6 (D), Q7.7 (D), Q7.8 (D), X1.6
L6: Q8.5 (D), Q8.6 (D), Q8.7 (D), Q8.8 (D), X1.7
LIGHT-GND: IC3.1 (IP+), IC3.2 (IP+_1), Q3.1 (S), Q3.2 (S), Q3.3 (S), Q4.1 (S), Q4.2 (S), Q4.3 (S), Q5.1 (S), Q5.2 (S), Q5.3 (S), Q6.1 (S), Q6.2 (S), Q6.3 (S), Q7.1 (S), Q7.2 (S), Q7.3 (S), Q8.1 (S), Q8.2 (S), Q8.3 (S)
MCU_RESET: C8.2, IC1.29 (PC6(/RESET)), R2.1, RS.TP
unnamed: C9.2, IC3.6 (FILTER)
unnamed: Q3.4 (G), R3.2, R9.1
unnamed: Q4.4 (G), R4.2, R10.1
unnamed: Q5.4 (G), R5.2, R11.1
unnamed: Q6.4 (G), R6.2, R12.1
unnamed: IC2.19 (!RST), R1.1
unnamed: Q7.4 (G), R7.2, R13.1
unnamed: Q8.4 (G), R8.2, R14.1
unnamed: R16.1, RX.C
unnamed: C3.1, IC1.7 (PB6(XTAL1/TOSC1)), Q2.1
unnamed: C4.1, IC1.8 (PB7(XTAL2/TOSC2)), Q2.2
unnamed: +5V.C, R15.2
unnamed: R17.1, TX.C
RX: IC1.31 (PD1(TXD)), PROG.2
RXCAN: DA1.4 (RXD), IC2.2 (RXCAN)
SCK: IC1.17 (PB5(SCK)), IC2.14 (SCK), SC.TP
SI: IC1.16 (PB4(MISO)), IC2.17 (SO), SI.TP
SO: IC1.15 (PB3(MOSI/OC2)), IC2.16 (SI), SO.TP
TX: IC1.30 (PD0(RXD)), PROG.3
TXCAN: DA1.1 (TXD), IC2.1 (TXCAN)
VCC: +5V.A, C5.2, C6.1, C10.2, C14.2, C15.2, C16.+, DA1.3 (VDD), IC1.4 (VCC), IC1.6 (VCC), IC1.18 (AVCC), IC2.20 (VDD), IC3.8 (VCC), IC5.3 (VO), PROG.4, R1.2, R2.2

Notes on the sheet:
Program
CAN-Interface
Controler
Loco-Switch V2.2

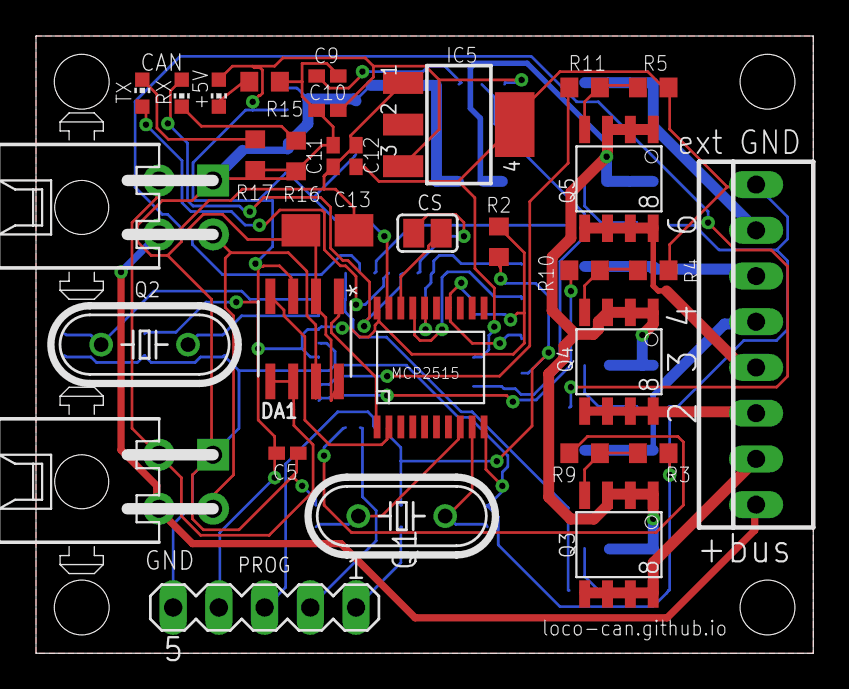
[picture p49: board LOCO-Switch.brd from above]

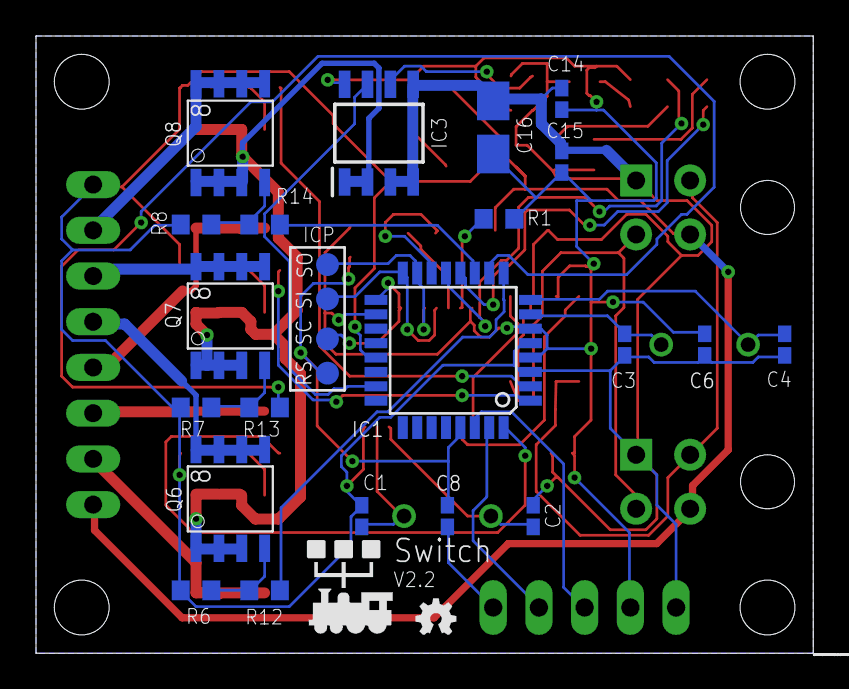
[picture p50: board LOCO-Switch.brd from below]

Board: 2 copper layers, 43.2 x 34.3 mm, 57 parts (25 on the bottom side), 47 nets.
