loco-can/loco-can-hardware/V2.x/Split/Loco-Split.brd

## EAGLE design V2.x/Split/Loco-Split.brd (2023-03-02, an earlier design)

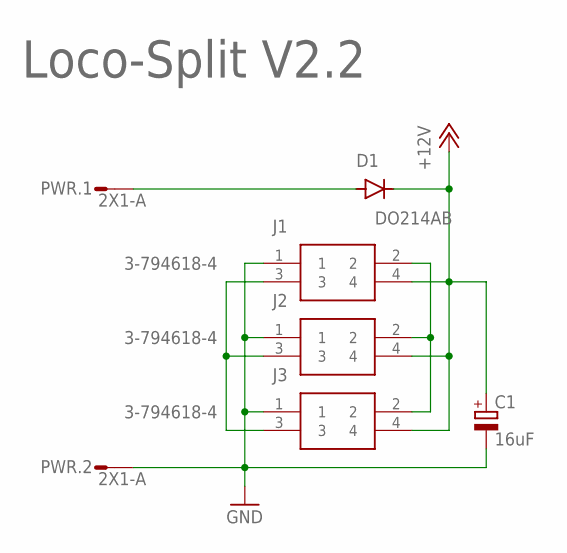
[picture p51: schematic Loco-Split.sch]

Parts:
C1: 16uF; A/3216-18W
D1: DO214AB; DO214AC
J1, J2, J3: 3-794618-4
PWR: 2X1-A; 3-794618-2

Connections:
+12V: C1.+, D1.C, J1.4, J2.4, J3.4
GND: C1.-, J1.1, J2.1, J3.1, PWR.2
unnamed: D1.A, PWR.1
unnamed: J1.3, J2.3, J3.3
unnamed: J1.2, J2.2, J3.2

Notes on the sheet:
Loco-Split V2.2

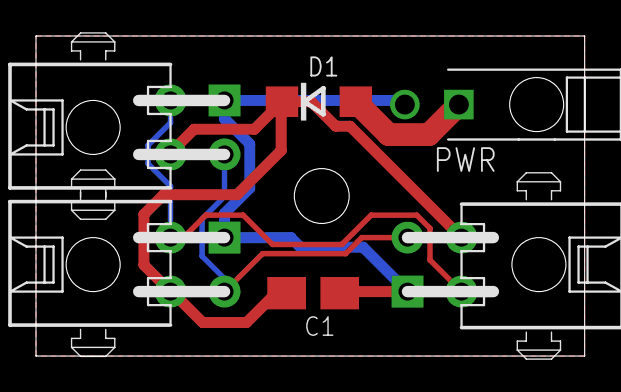
[picture p52: board Loco-Split.brd from above]

Board: 2 copper layers, 30.5 x 17.8 mm, 6 parts (0 on the bottom side), 5 nets.
