loco-can/loco-can-hardware/V2.x/Control Adapter/Loco-Control-Adapter.brd

## EAGLE design V2.x/Control Adapter/Loco-Control-Adapter.brd (2023-03-02, an earlier design)

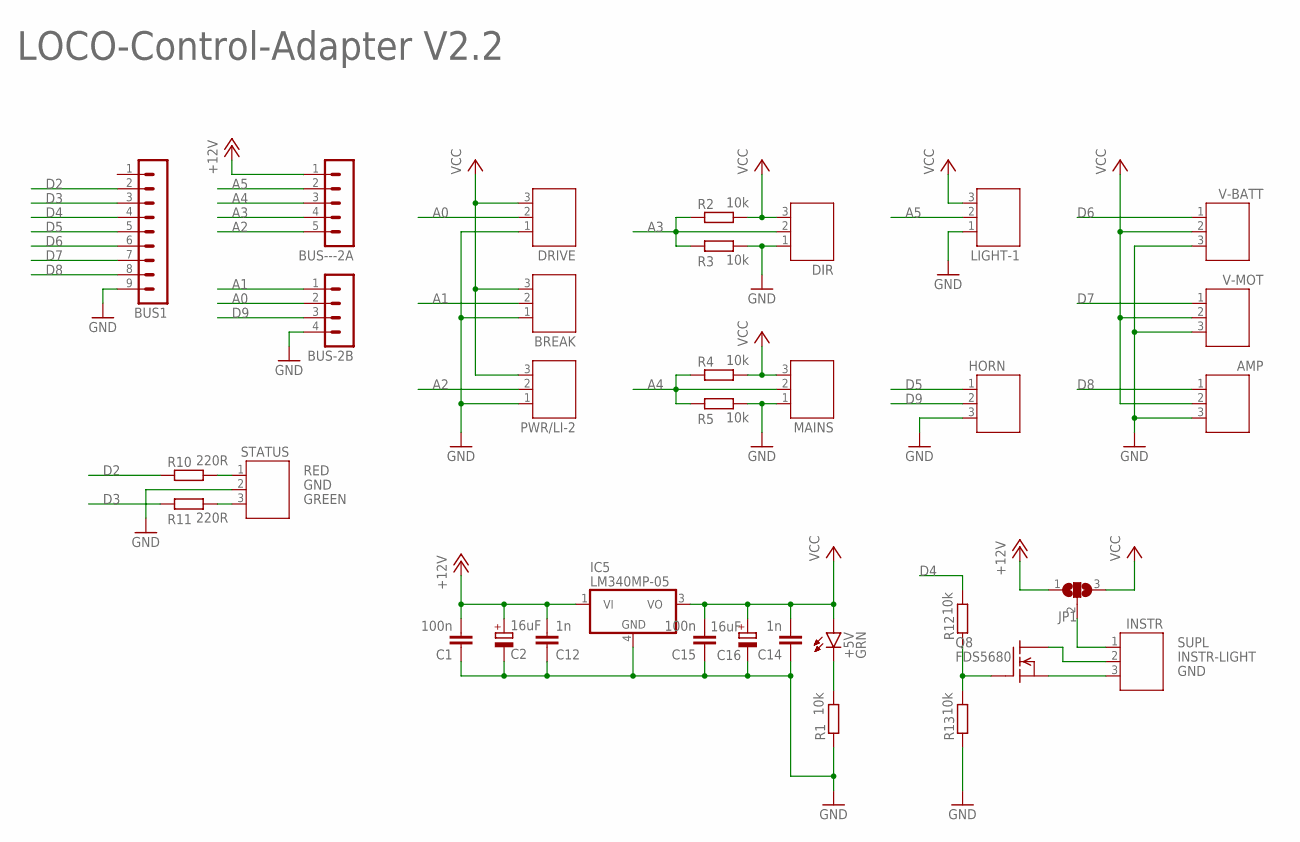
[picture p53: schematic Loco-Control-Adapter.sch, sheet 1]

Parts:
+5V: GRN; CHIP-LED0603
AMP: JST-PH3
BREAK: JST-PH3
BUS1: MA09-1
BUS-2B: MA04-1
BUS---2A: MA05-1
C1, C15: 100n; C0402K
C2, C16: 16uF; A/3216-18W
C12, C14: 1n; C0402K
DIR: JST-PH3
DRIVE: JST-PH3
HORN: JST-PH3
IC5: LM340MP-05; SOT223
INSTR: JST-PH3
JP1: SJ2W; SJ_2
LIGHT-1: JST-PH3
MAINS: JST-PH3
PWR/LI-2: JST-PH3
Q8: FDS5680; SO-8
R1, R12, R13: 10k; R0603
R2, R3, R4, R5: 10k; R0805
R10, R11: 220R; R0805
STATUS: JST-PH3
V-BATT: JST-PH3
V-MOT: JST-PH3

Connections:
+12V: BUS---2A.1, C1.2, C2.+, C12.2, IC5.1 (VI), JP1.1
A0: BUS-2B.2, DRIVE.2
A1: BREAK.2, BUS-2B.1
A2: BUS---2A.5, PWR/LI-2.2
A3: BUS---2A.4, DIR.2, R2.1, R3.1
A4: BUS---2A.3, MAINS.2, R4.1, R5.1
A5: BUS---2A.2, LIGHT-1.2
D2: BUS1.2, R10.1
D3: BUS1.3, R11.1
D4: BUS1.4, R12.2
D5: BUS1.5, HORN.1
D6: BUS1.6, V-BATT.1
D7: BUS1.7, V-MOT.1
D8: AMP.1, BUS1.8
D9: BUS-2B.3, HORN.2
GND: AMP.3, BREAK.1, BUS1.9, BUS-2B.4, C1.1, C2.-, C12.1, C14.1, C15.1, C16.-, DIR.1, DRIVE.1, HORN.3, IC5.4 (GND), INSTR.3, LIGHT-1.1, MAINS.1, PWR/LI-2.1, Q8.1 (S), Q8.2 (S), Q8.3 (S), R1.1, R3.2, R5.2, R13.1, STATUS.2, V-BATT.3, V-MOT.3
GREEN: R11.2, STATUS.3
INSTR-LIGHT: INSTR.2, Q8.5 (D), Q8.6 (D), Q8.7 (D), Q8.8 (D)
unnamed: Q8.4 (G), R12.1, R13.2
unnamed: +5V.C, R1.2
RED: R10.2, STATUS.1
SUPL: INSTR.1, JP1.2
VCC: +5V.A, AMP.2, BREAK.3, C14.2, C15.2, C16.+, DIR.3, DRIVE.3, IC5.3 (VO), JP1.3, LIGHT-1.3, MAINS.3, PWR/LI-2.3, R2.2, R4.2, V-BATT.2, V-MOT.2

Notes on the sheet:
LOCO-Control-Adapter V2.2

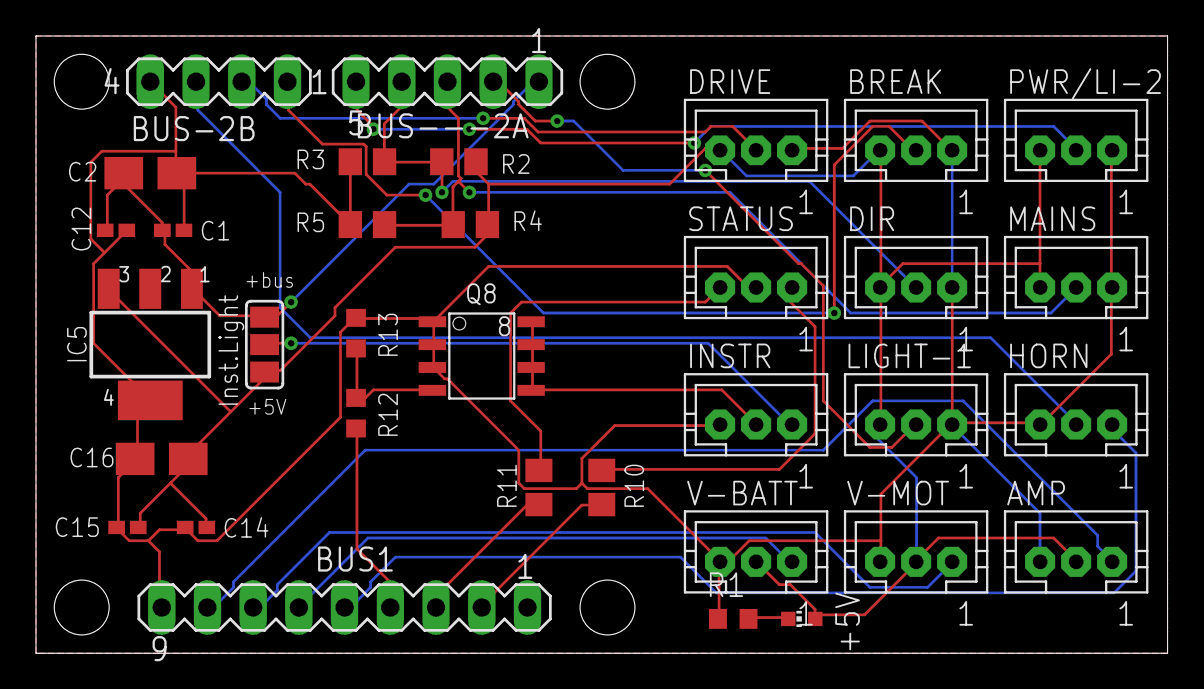
[picture p54: board Loco-Control-Adapter.brd from above]

Board: 2 copper layers, 62.9 x 34.3 mm, 34 parts (0 on the bottom side), 23 nets.
