loco-can/loco-can-hardware/V1.2/Adapter Light/Adapter Light.brd

## EAGLE design V1.2/Adapter Light/Adapter Light.brd (2023-02-24)

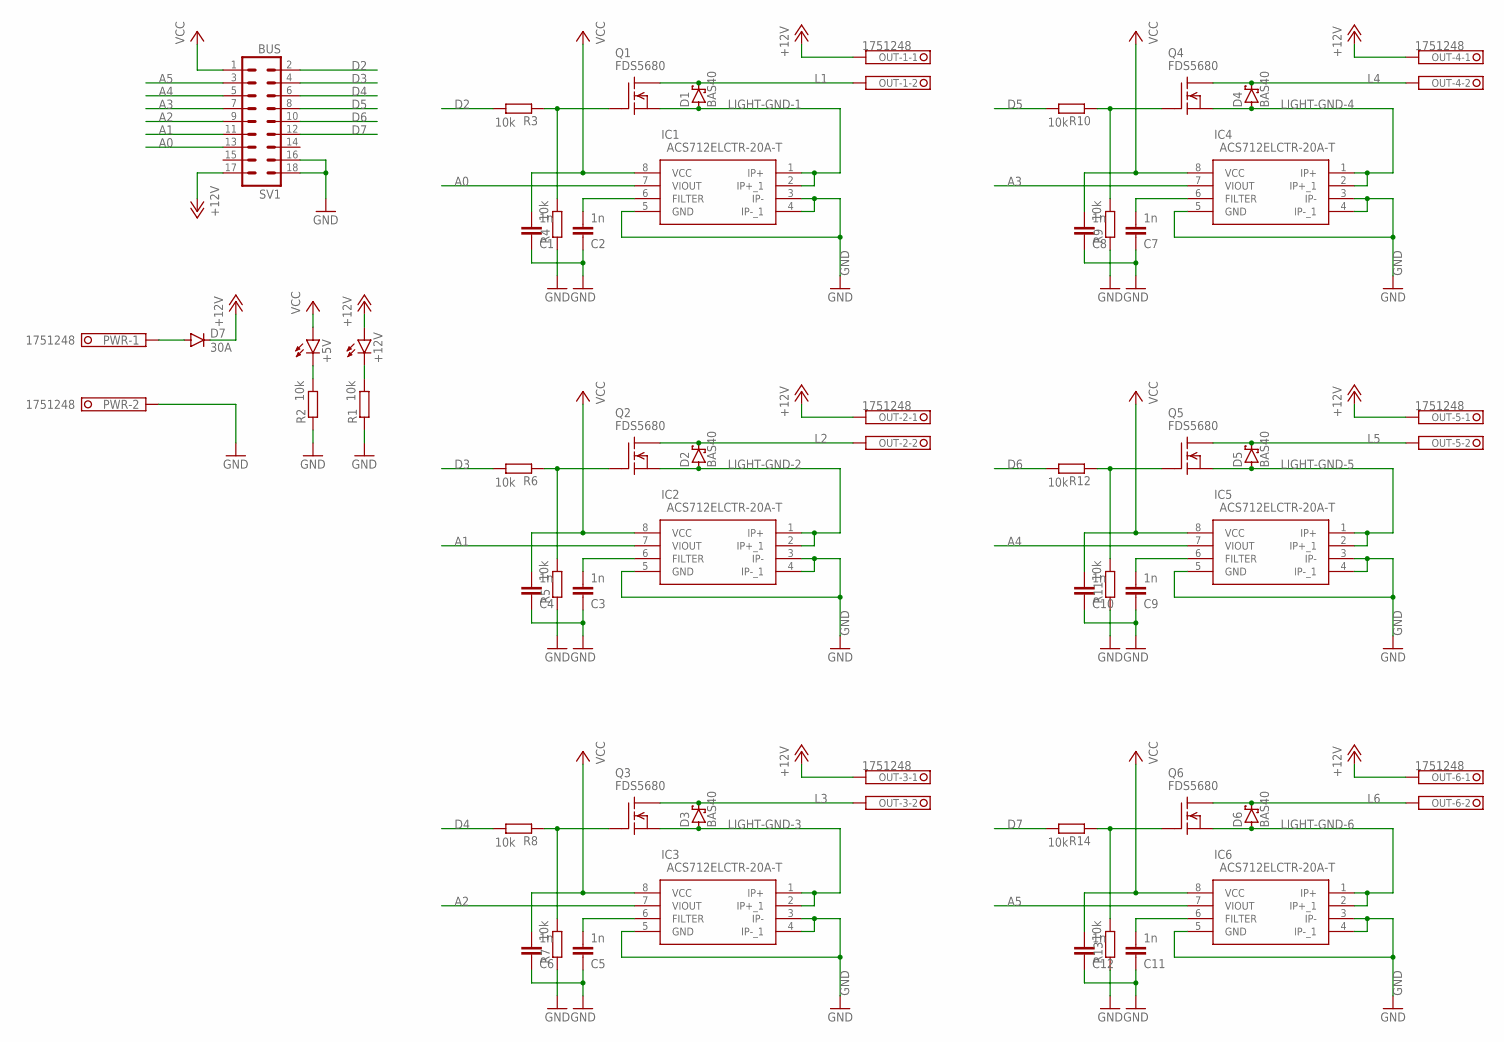
[picture p55: schematic Adapter Light.sch, sheet 1]

Parts:
+5V, +12V: LED3MM
C1, C2, C3, C4, C5, C6, C7, C8, C9, C10, C11, C12: 1n; C0402K
D1, D2, D3, D4, D5, D6: BAS40; SOT23
D7: 30A; DO15-12
IC1, IC2, IC3, IC4, IC5, IC6: ACS712ELCTR-20A-T; SOIC127P600X175-8N
OUT-1, OUT-2, OUT-3, OUT-4, OUT-5, OUT-6: 1751248
PWR: 1751248
Q1, Q2, Q3, Q4, Q5, Q6: FDS5680; SO-8
R1, R2, R3, R4, R5, R6, R7, R8, R9, R10, R11, R12, R13, R14: 10k; MINI_MELF-0102W
SV1: BUS; MA09-2

Connections:
+12V: +12V.A, D7.C, OUT-1.1, OUT-2.1, OUT-3.1, OUT-4.1, OUT-5.1, OUT-6.1, SV1.17
A0: IC1.7 (VIOUT), SV1.13
A1: IC2.7 (VIOUT), SV1.11
A2: IC3.7 (VIOUT), SV1.9
A3: IC4.7 (VIOUT), SV1.7
A4: IC5.7 (VIOUT), SV1.5
A5: IC6.7 (VIOUT), SV1.3
D2: R3.2, SV1.2
D3: R6.2, SV1.4
D4: R8.2, SV1.6
D5: R10.2, SV1.8
D6: R12.2, SV1.10
D7: R14.2, SV1.12
GND: C1.1, C2.1, C3.1, C4.1, C5.1, C6.1, C7.1, C8.1, C9.1, C10.1, C11.1, C12.1, IC1.3 (IP-), IC1.4 (IP-_1), IC1.5 (GND), IC2.3 (IP-), IC2.4 (IP-_1), IC2.5 (GND), IC3.3 (IP-), IC3.4 (IP-_1), IC3.5 (GND), IC4.3 (IP-), IC4.4 (IP-_1), IC4.5 (GND), IC5.3 (IP-), IC5.4 (IP-_1), IC5.5 (GND), IC6.3 (IP-), IC6.4 (IP-_1), IC6.5 (GND), PWR.2, R1.1, R2.1, R4.1, R5.1, R7.1, R9.1, R11.1, R13.1, SV1.16, SV1.18
L1: D1.3 (C), OUT-1.2, Q1.5 (D), Q1.6 (D), Q1.7 (D), Q1.8 (D)
L2: D2.3 (C), OUT-2.2, Q2.5 (D), Q2.6 (D), Q2.7 (D), Q2.8 (D)
L3: D3.3 (C), OUT-3.2, Q3.5 (D), Q3.6 (D), Q3.7 (D), Q3.8 (D)
L4: D4.3 (C), OUT-4.2, Q4.5 (D), Q4.6 (D), Q4.7 (D), Q4.8 (D)
L5: D5.3 (C), OUT-5.2, Q5.5 (D), Q5.6 (D), Q5.7 (D), Q5.8 (D)
L6: D6.3 (C), OUT-6.2, Q6.5 (D), Q6.6 (D), Q6.7 (D), Q6.8 (D)
LIGHT-GND-1: D1.1 (A), IC1.1 (IP+), IC1.2 (IP+_1), Q1.1 (S), Q1.2 (S), Q1.3 (S)
LIGHT-GND-2: D2.1 (A), IC2.1 (IP+), IC2.2 (IP+_1), Q2.1 (S), Q2.2 (S), Q2.3 (S)
LIGHT-GND-3: D3.1 (A), IC3.1 (IP+), IC3.2 (IP+_1), Q3.1 (S), Q3.2 (S), Q3.3 (S)
LIGHT-GND-4: D4.1 (A), IC4.1 (IP+), IC4.2 (IP+_1), Q4.1 (S), Q4.2 (S), Q4.3 (S)
LIGHT-GND-5: D5.1 (A), IC5.1 (IP+), IC5.2 (IP+_1), Q5.1 (S), Q5.2 (S), Q5.3 (S)
LIGHT-GND-6: D6.1 (A), IC6.1 (IP+), IC6.2 (IP+_1), Q6.1 (S), Q6.2 (S), Q6.3 (S)
unnamed: C2.2, IC1.6 (FILTER)
unnamed: C3.2, IC2.6 (FILTER)
unnamed: Q2.4 (G), R5.2, R6.1
unnamed: C5.2, IC3.6 (FILTER)
unnamed: Q3.4 (G), R7.2, R8.1
unnamed: +12V.K (C), R1.2
unnamed: C7.2, IC4.6 (FILTER)
unnamed: Q4.4 (G), R9.2, R10.1
unnamed: Q1.4 (G), R3.1, R4.2
unnamed: C9.2, IC5.6 (FILTER)
unnamed: Q5.4 (G), R11.2, R12.1
unnamed: +5V.K (C), R2.2
unnamed: C11.2, IC6.6 (FILTER)
unnamed: Q6.4 (G), R13.2, R14.1
unnamed: D7.A, PWR.1
VCC: +5V.A, C1.2, C4.2, C6.2, C8.2, C10.2, C12.2, IC1.8 (VCC), IC2.8 (VCC), IC3.8 (VCC), IC4.8 (VCC), IC5.8 (VCC), IC6.8 (VCC), SV1.1

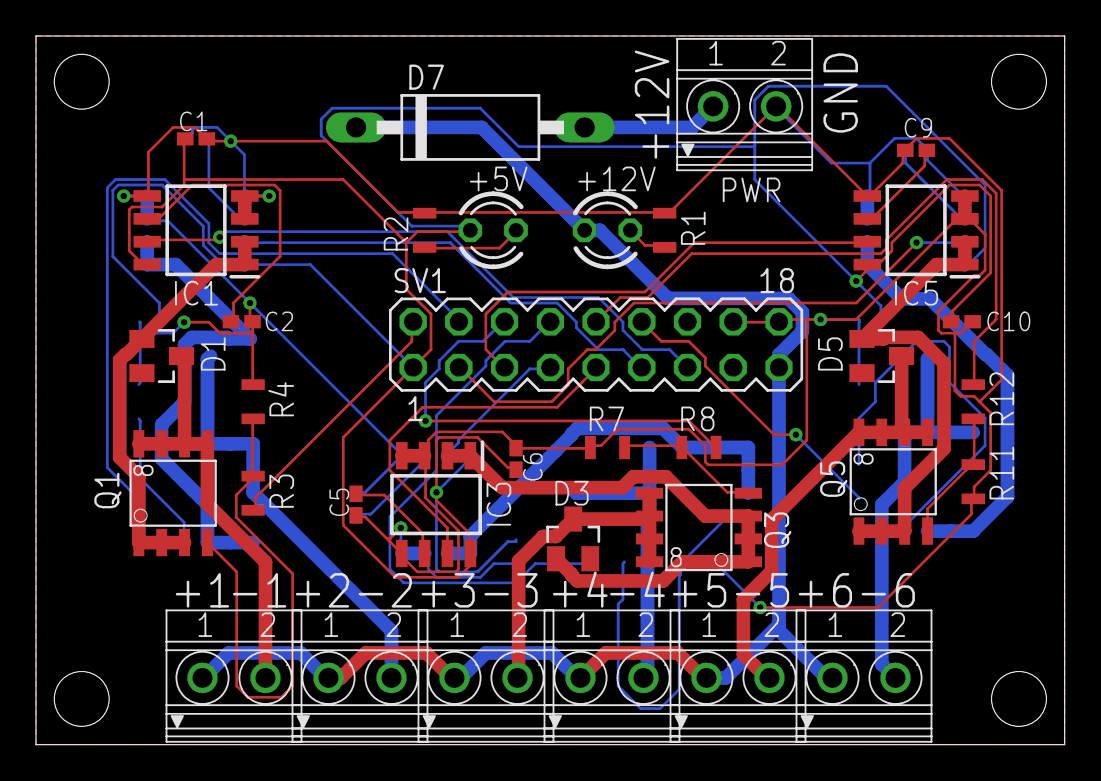
[picture p56: board Adapter Light.brd from above]

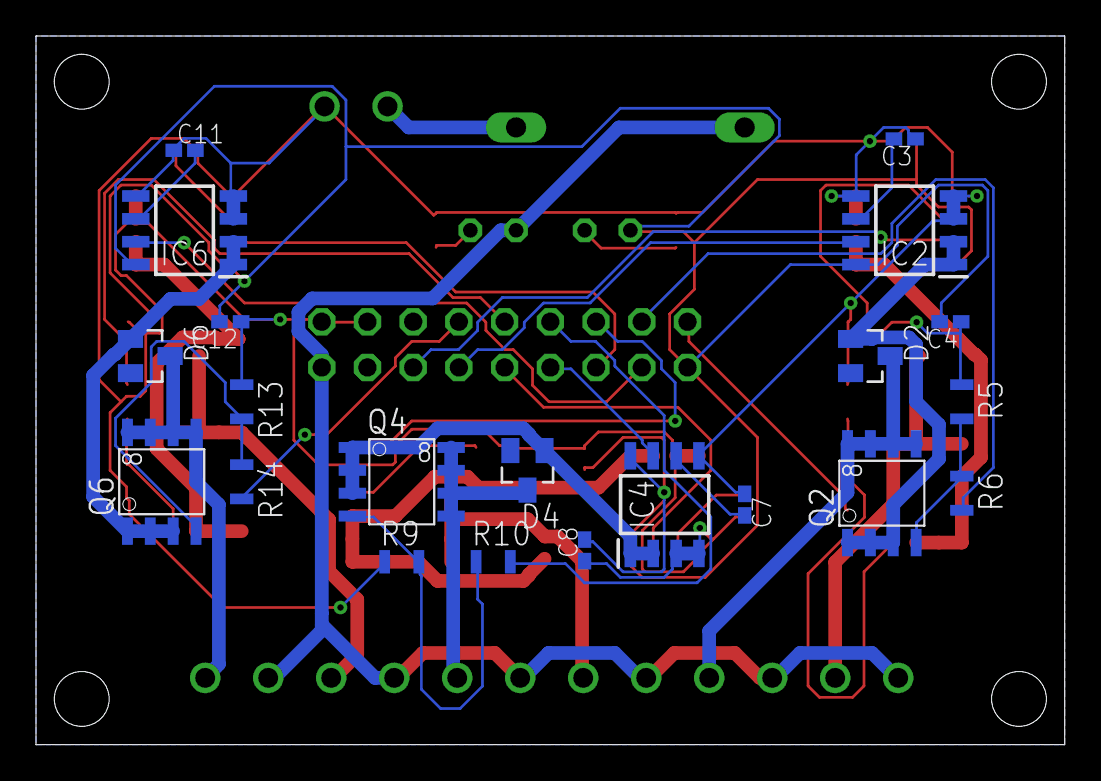
[picture p57: board Adapter Light.brd from below]

Board: 2 copper layers, 57.1 x 39.4 mm, 55 parts (21 on the bottom side), 42 nets.
