loco-can/loco-can-hardware/V1.2/Adapter LK-1/Adapter LK-1.brd

## EAGLE design V1.2/Adapter LK-1/Adapter LK-1.brd (2023-02-24)

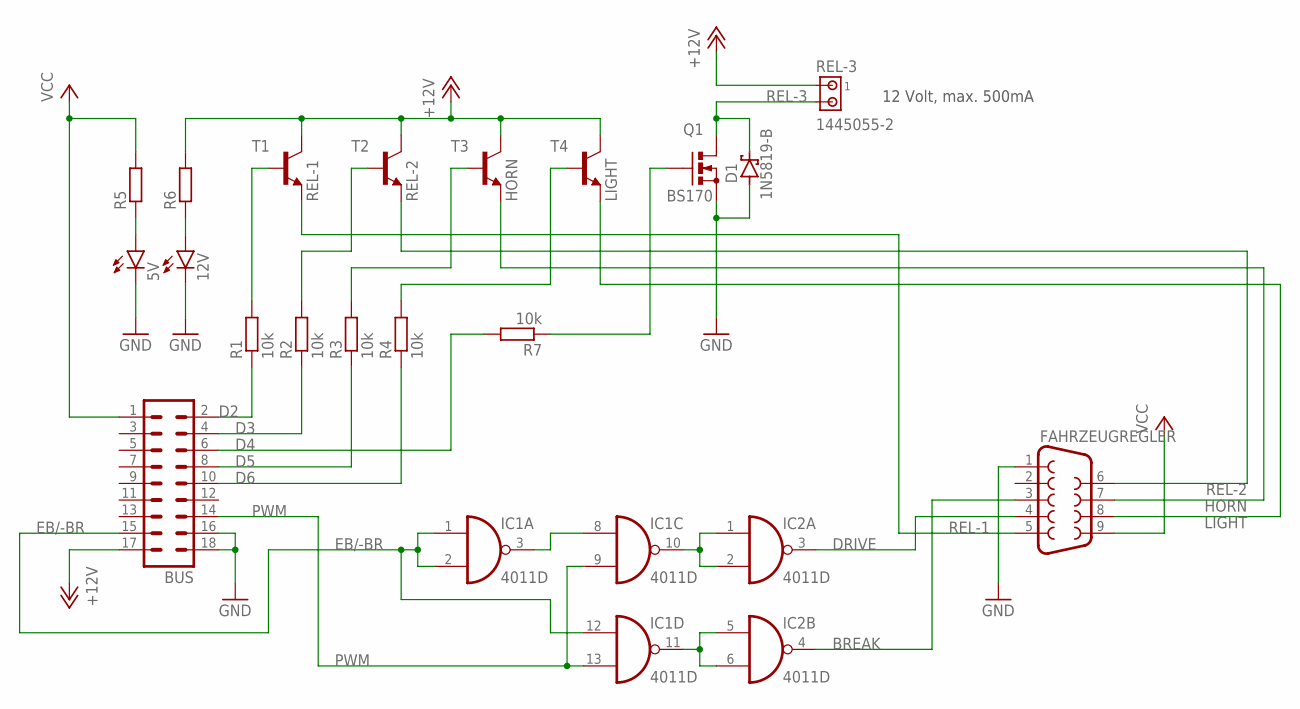
[picture p58: schematic Adapter LK-1.sch]

Parts:
5V, 12V: LED3MM
BUS: MA09-2
D1: 1N5819-B; DO41-7.6
FAHRZEUGREGLER: F09HP
IC1, IC2: 4011D; SO14
Q1: BS170; SOT54E
R1, R2, R3, R4, R7: 10k; 0204V
R5, R6: R-EU_0204/2V; 0204V
REL-3: 1445055-2
T1, T2, T3, T4: -NPN-TO92; TO92

Connections:
+12V: BUS.17, R6.2, REL-3.1, T1.3 (C), T2.3 (C), T3.3 (C), T4.3 (C)
BREAK: FAHRZEUGREGLER.3, IC2.4 (O)
D2: BUS.2, R1.1
D3: BUS.4, R2.1
D4: BUS.6, R7.2
D5: BUS.8, R3.1
D6: BUS.10, R4.1
DRIVE: FAHRZEUGREGLER.4, IC2.3 (O)
EB/-BR: BUS.15, IC1.1 (I0), IC1.2 (I1), IC1.12 (I0)
GND: 5V.K (C), 12V.K (C), BUS.16, BUS.18, D1.A, FAHRZEUGREGLER.1, Q1.S
HORN: FAHRZEUGREGLER.7, T3.1 (E)
LIGHT: FAHRZEUGREGLER.8, T4.1 (E)
unnamed: IC1.3 (O), IC1.8 (I0)
unnamed: R1.2, T1.2 (B)
unnamed: R2.2, T2.2 (B)
unnamed: IC1.10 (O), IC2.1 (I0), IC2.2 (I1)
unnamed: IC1.11 (O), IC2.5 (I0), IC2.6 (I1)
unnamed: R3.2, T3.2 (B)
unnamed: R4.2, T4.2 (B)
unnamed: 5V.A, R5.1
unnamed: 12V.A, R6.1
unnamed: Q1.G, R7.1
PWM: BUS.14, IC1.9 (I1), IC1.13 (I1)
REL-1: FAHRZEUGREGLER.5, T1.1 (E)
REL-2: FAHRZEUGREGLER.6, T2.1 (E)
REL-3: D1.C, Q1.D, REL-3.2
VCC: BUS.1, FAHRZEUGREGLER.9, R5.2
VDD: IC1.14 (VDD), IC2.14 (VDD)
VSS: IC1.7 (VSS), IC2.7 (VSS)

Notes on the sheet:
12 Volt, max. 500mA

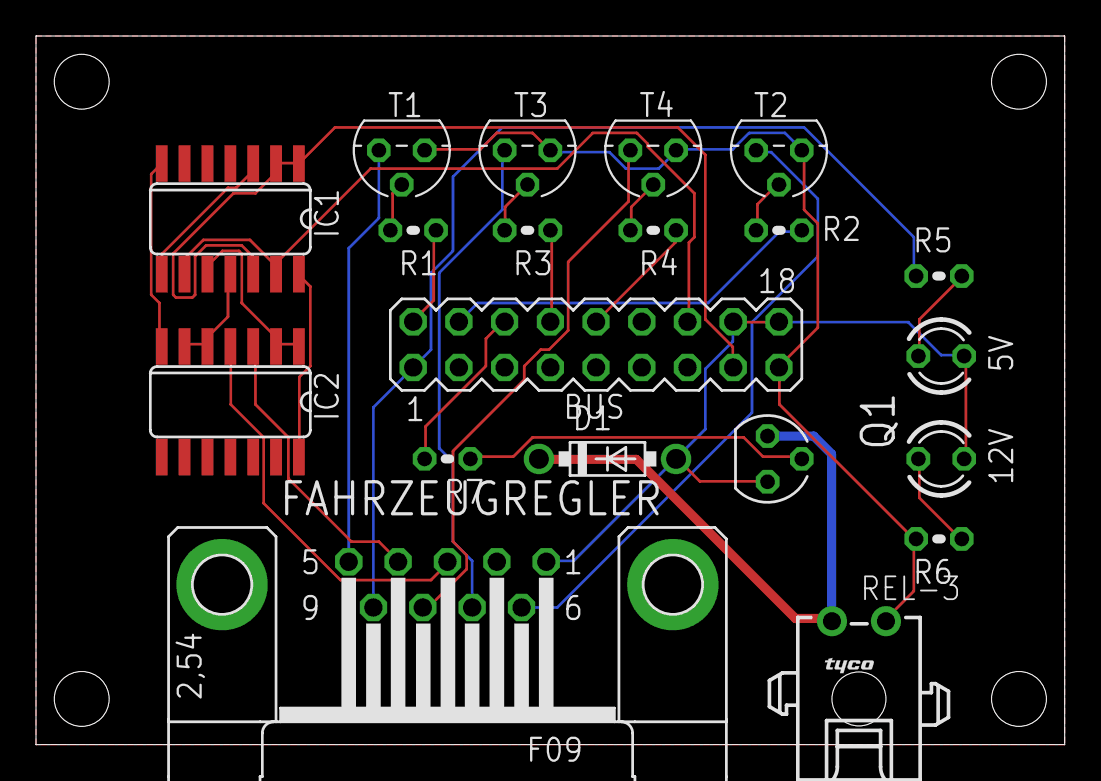
[picture p59: board Adapter LK-1.brd from above]

Board: 2 copper layers, 57.1 x 39.4 mm, 20 parts (0 on the bottom side), 29 nets.
