loco-can/loco-can-hardware/Program Cable/Program Cable.brd

## EAGLE design Program Cable/Program Cable.brd (2023-02-24)

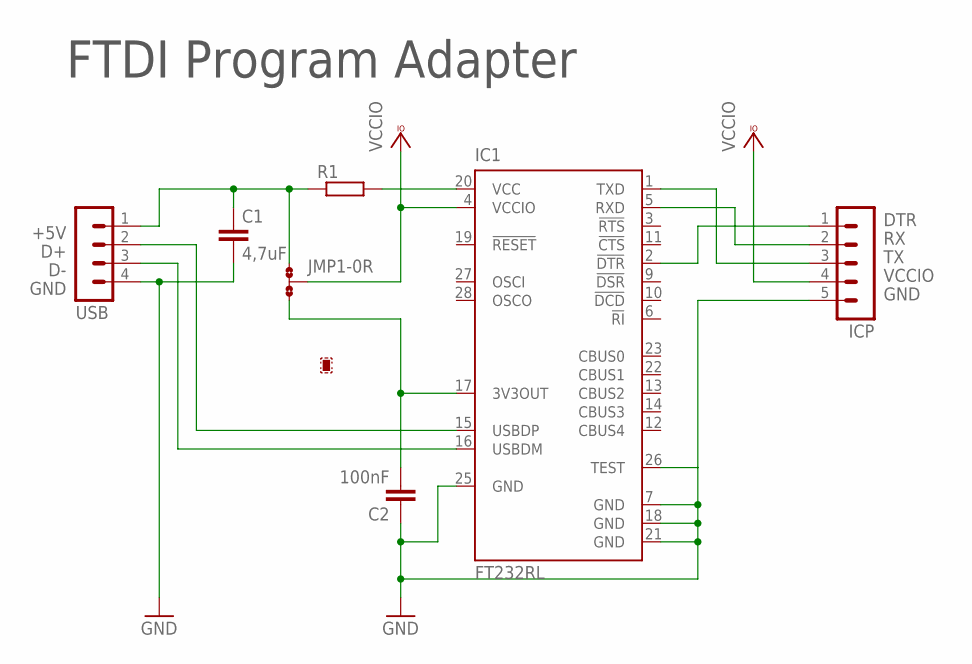
[picture p60: schematic Program Cable.sch]

Parts:
C1: 4,7uF; C1206
C2: 100nF; C0402
IC1: FT232RL; SSOP28
ICP: MA05-1
JMP1: 0R-JUMPA; A0R-JMP
R1: R-EU_R0805; R0805
USB: MA04-1

Connections:
3V3: C2.2, IC1.17 (3V3OUT), JMP1.3
+5V: C1.1, JMP1.1, R1.1, USB.1
D+: IC1.15 (USBDP), USB.2
D-: IC1.16 (USBDM), USB.3
DTR: IC1.2 (!DTR), ICP.1
GND: C1.2, C2.1, IC1.7 (GND), IC1.18 (GND), IC1.21 (GND), IC1.25 (GND), IC1.26 (TEST), ICP.5, USB.4
unnamed: IC1.20 (VCC), R1.2
RX: IC1.5 (RXD), ICP.2
TX: IC1.1 (TXD), ICP.3
VCCIO: IC1.4 (VCCIO), ICP.4, JMP1.2

Notes on the sheet:
FTDI Program Adapter

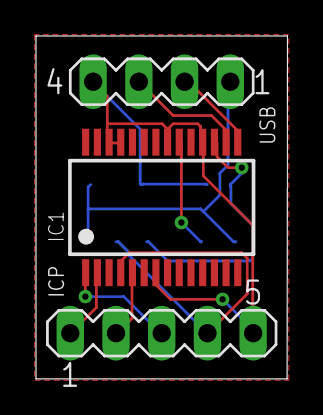
[picture p61: board Program Cable.brd from above]

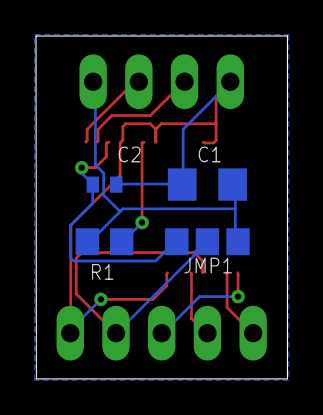
[picture p62: board Program Cable.brd from below]

Board: 2 copper layers, 14.0 x 19.1 mm, 7 parts (4 on the bottom side), 10 nets.
