loco-can/loco-can-hardware/V2.x/Powersplit/Powersplit.brd

## EAGLE design V2.x/Powersplit/Powersplit.brd (2023-02-24, an earlier design)

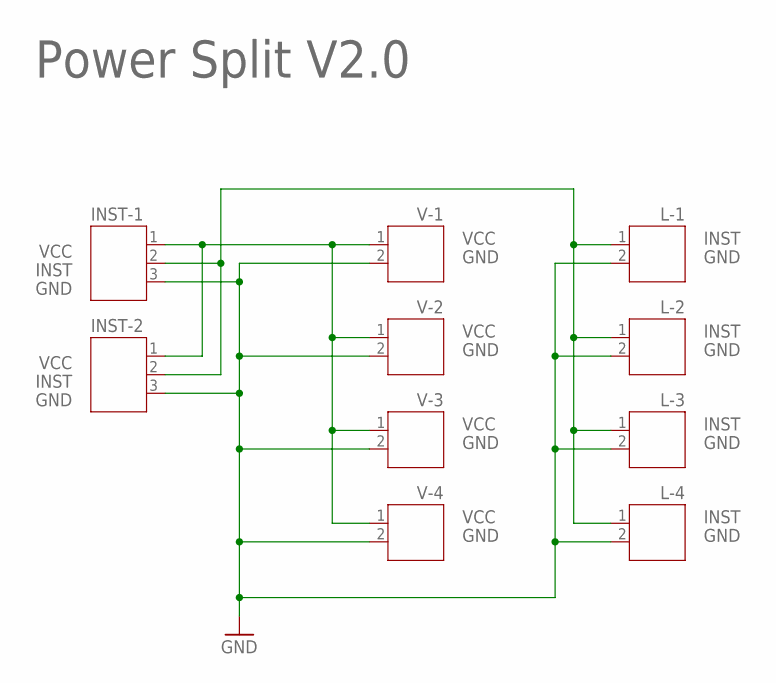
[picture p63: schematic Powersplit.sch]

Parts:
INST-1, INST-2: JST-PH3
L-1, L-2, L-3, L-4: JST-PH2
V-1, V-2, V-3, V-4: JST-PH2

Connections:
GND: INST-1.3, INST-2.3, L-1.2, L-2.2, L-3.2, L-4.2, V-1.2, V-2.2, V-3.2, V-4.2
INST: INST-1.2, INST-2.2, L-1.1, L-2.1, L-3.1, L-4.1
VCC: INST-1.1, INST-2.1, V-1.1, V-2.1, V-3.1, V-4.1

Notes on the sheet:
Power Split V2.0

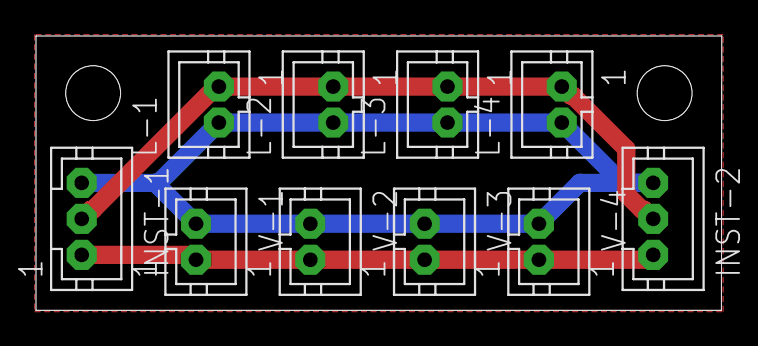
[picture p64: board Powersplit.brd from above]

Board: 2 copper layers, 38.1 x 15.2 mm, 10 parts (0 on the bottom side), 3 nets.
