loco-can/loco-can-hardware/Tripple LED/Tripple-LED.brd

## EAGLE design Tripple LED/Tripple-LED.brd (2023-02-24)

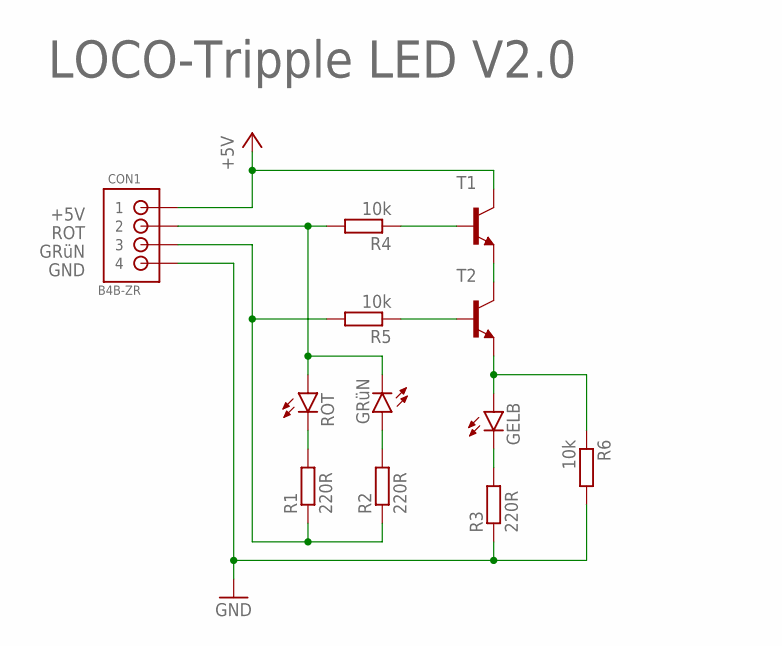
[picture p65: schematic Tripple-LED.sch]

Parts:
CON1: B4B-ZR
GELB: LED5MM
GRüN: LED5MM
R1, R2, R3: 220R; R0402
R4, R5, R6: 10k; R0402
ROT: LED5MM
T1, T2: -NPN-SOT23-EBC; SOT23-EBC

Connections:
+5V: CON1.1, T1.C
GND: CON1.4, R3.1, R6.2
GRüN: CON1.3, R1.1, R2.1, R5.2
unnamed: GRüN.A, R2.2
unnamed: R1.2, ROT.K (C)
unnamed: GELB.K (C), R3.2
unnamed: R4.1, T1.B
unnamed: R5.1, T2.B
unnamed: T1.E, T2.C
unnamed: GELB.A, R6.1, T2.E
ROT: CON1.2, GRüN.K (C), R4.2, ROT.A

Notes on the sheet:
LOCO-Tripple LED V2.0

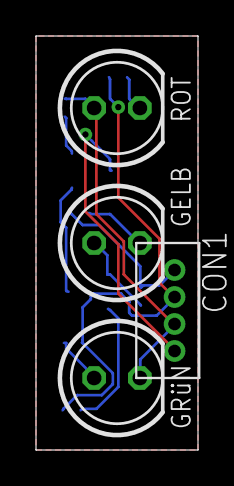
[picture p66: board Tripple-LED.brd from above]

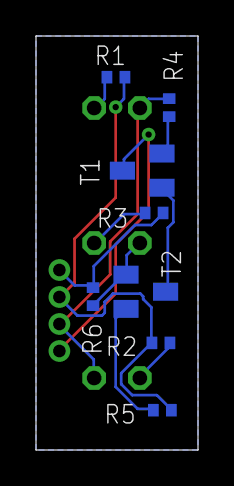
[picture p67: board Tripple-LED.brd from below]

Board: 2 copper layers, 9.0 x 23.0 mm, 12 parts (8 on the bottom side), 11 nets.
