loco-can/loco-can-hardware/V1.0/RS485 Adapter/RS485 Adapter.brd

## EAGLE design V1.0/RS485 Adapter/RS485 Adapter.brd (2023-02-24, an earlier design)

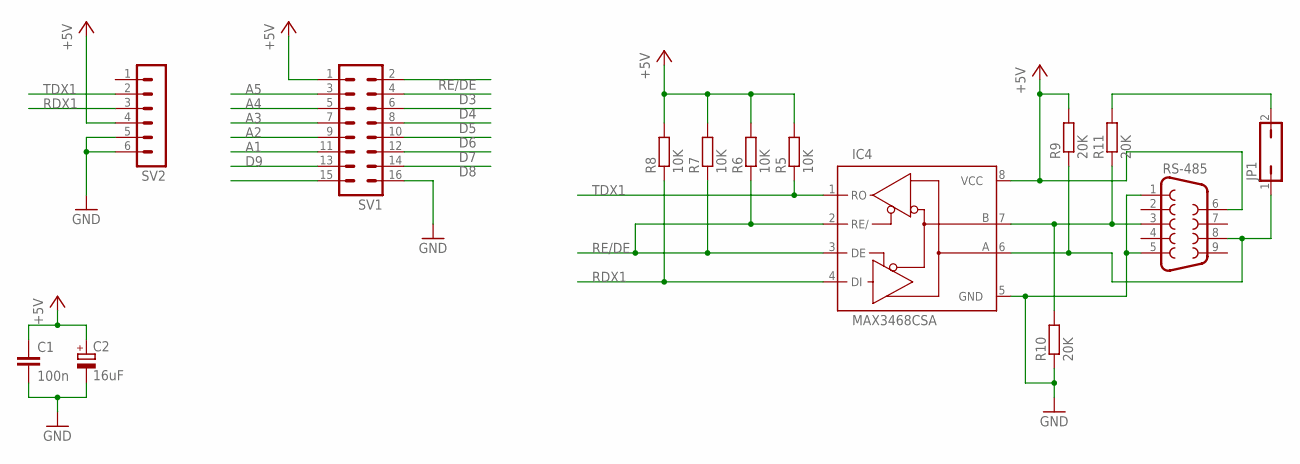
[picture p68: schematic RS485 Adapter.sch]

Parts:
C1: 100n; C0402
C2: 16uF; A/3216-18R
IC4: MAX3468CSA; SO08
JP1: JP1Q; JP1
R5, R6, R7, R8: 10K; MINI_MELF-0102R
R9, R10, R11: 20K; MINI_MELF-0102R
RS-485: F09V
SV1: MA08-2
SV2: MA06-1

Connections:
+5V: C1.1, C2.+, IC4.8 (VCC), R5.2, R6.2, R7.2, R8.2, R9.2, RS-485.6, SV1.1, SV2.4
A1: SV1.11
A2: SV1.9
A3: SV1.7
A4: SV1.5
A5: SV1.3
D3: SV1.4
D4: SV1.6
D5: SV1.8
D6: SV1.10
D7: SV1.12
D8: SV1.14
D9: SV1.13
GND: C1.2, C2.-, IC4.5 (GND), R10.1, RS-485.1, RS-485.5, SV1.16, SV2.5, SV2.6
IO14: SV1.15
unnamed: IC4.6 (A), JP1.1, R9.1, RS-485.8
unnamed: IC4.7 (B), R10.2, R11.1, RS-485.3
unnamed: JP1.2, R11.2
RDX1: IC4.4 (DI), R8.1, SV2.3
RE/DE: IC4.2 (RE/), IC4.3 (DE), R6.1, R7.1, SV1.2
TDX1: IC4.1 (RO), R5.1, SV2.2

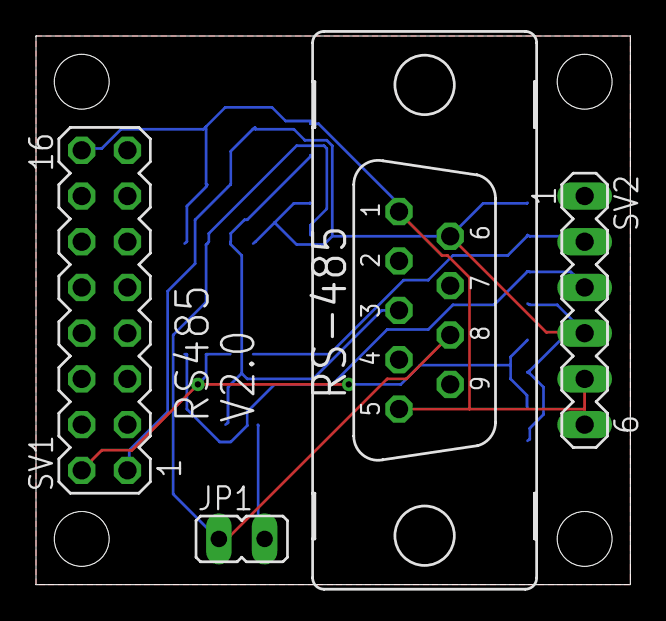
[picture p69: board RS485 Adapter.brd from above]

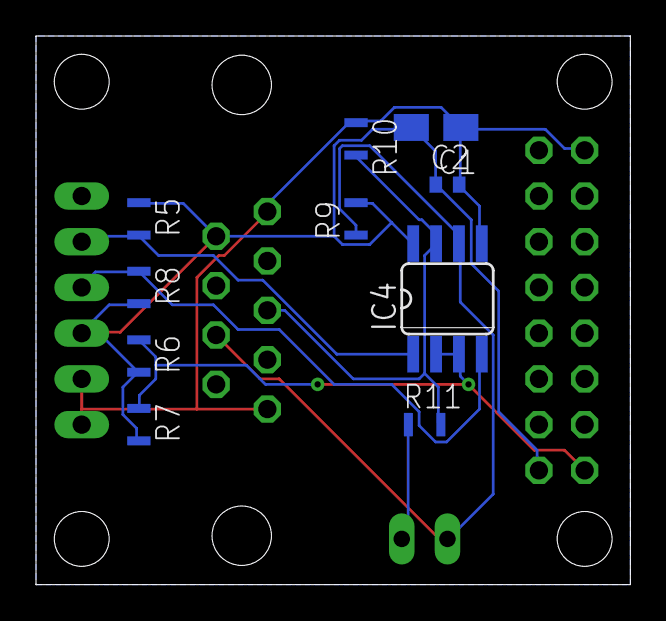
[picture p70: board RS485 Adapter.brd from below]

Board: 2 copper layers, 33.0 x 30.5 mm, 14 parts (10 on the bottom side), 8 nets.
