loco-can/loco-can-hardware/V1.0/CAN Power/CAN Power.brd

## EAGLE design V1.0/CAN Power/CAN Power.brd (2023-02-24, an earlier design)

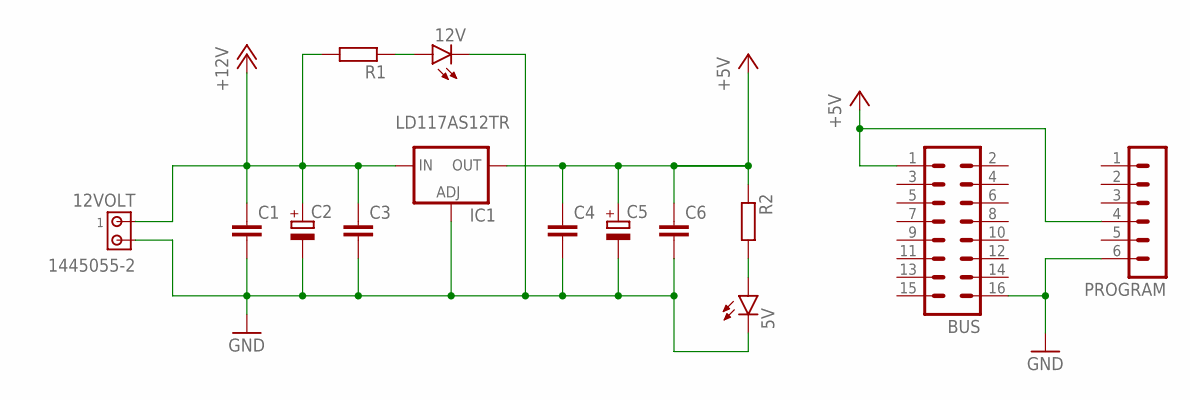
[picture p71: schematic CAN Power.sch]

Parts:
5V, 12V: LED3MM
12VOLT: 1445055-2
BUS: MA08-2
C1, C3, C4, C6: C-EUC0402; C0402
C2, C5: CPOL-EUC/6032-28R; C/6032-28R
IC1: LD117AS12TR; SOT223
PROGRAM: MA06-1
R1, R2: R-EU_R0402; R0402

Connections:
+5V: BUS.1, C4.1, C5.+, C6.1, IC1.4 (OUT), PROGRAM.4, R2.1
+12V: 12VOLT.1, C1.1, C2.+, C3.1, IC1.3 (IN), R1.2
GND: 5V.K (C), 12V.K (C), 12VOLT.2, BUS.16, C1.2, C2.-, C3.2, C4.2, C5.-, C6.2, IC1.1 (ADJ), PROGRAM.6
unnamed: 5V.A, R2.2
unnamed: 12V.A, R1.1

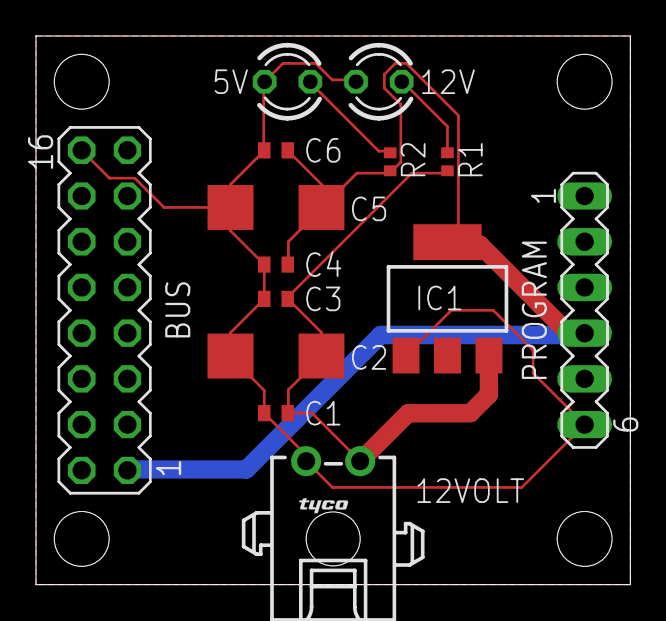
[picture p72: board CAN Power.brd from above]

Board: 2 copper layers, 33.0 x 30.5 mm, 14 parts (0 on the bottom side), 5 nets.
