loco-can/loco-can-hardware/V1.0/Light Adapter SMD/Light-Adapter SMD.brd

## EAGLE design V1.0/Light Adapter SMD/Light-Adapter SMD.brd (2023-02-24, an earlier design)

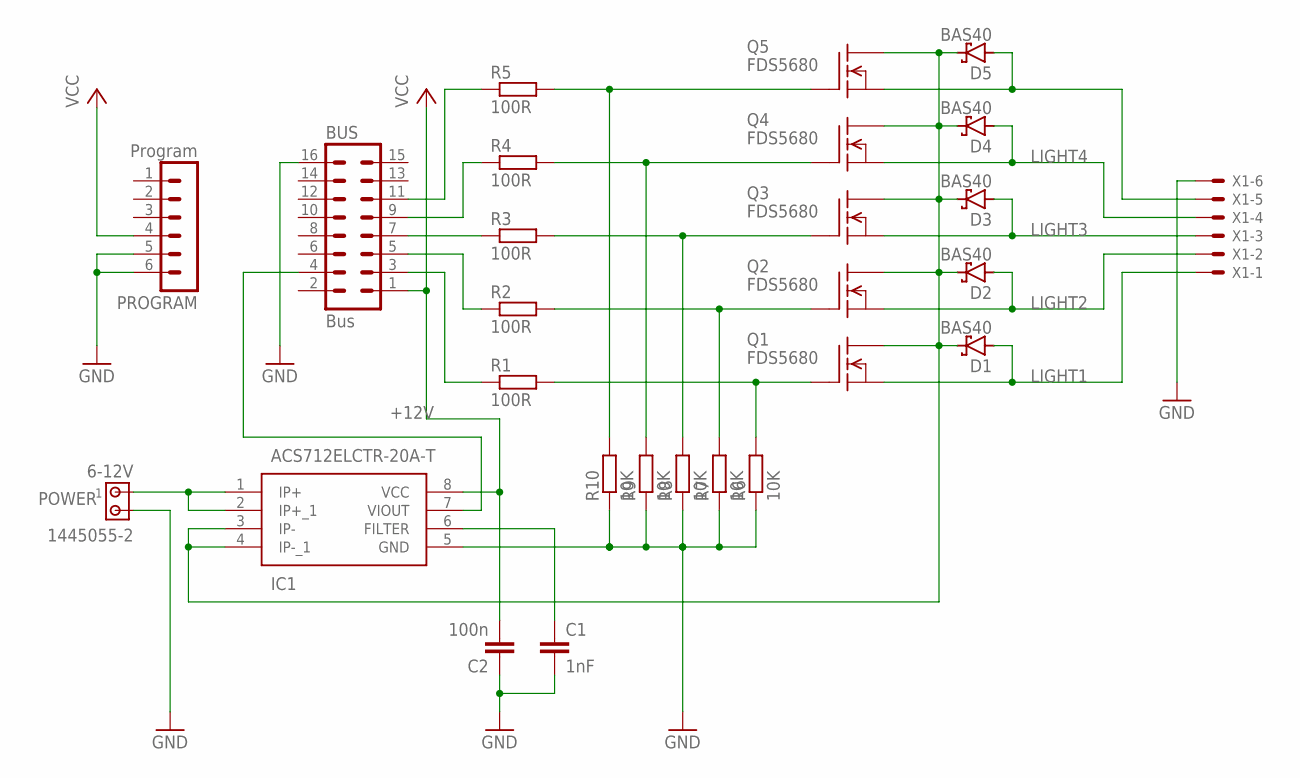
[picture p73: schematic Light-Adapter SMD.sch]

Parts:
6-12V: 1445055-2
BUS: Bus; MA08-2
C1: 1nF; C0402
C2: 100n; C0402
D1, D2, D3, D4, D5: BAS40; SOT23
IC1: ACS712ELCTR-20A-T; SOIC127P600X175-8N
PROGRAM: Program; MA06-1
Q1, Q2, Q3, Q4, Q5: FDS5680; SO-8
R1, R2, R3, R4, R5: 100R; R0402
R6, R7, R8, R9, R10: 10K; R0402
X1: 22-23-2061

Connections:
+12V: D1.3 (C), D2.3 (C), D3.3 (C), D4.3 (C), D5.3 (C), IC1.3 (IP-), IC1.4 (IP-_1), Q1.5 (D), Q1.6 (D), Q1.7 (D), Q1.8 (D), Q2.5 (D), Q2.6 (D), Q2.7 (D), Q2.8 (D), Q3.5 (D), Q3.6 (D), Q3.7 (D), Q3.8 (D), Q4.5 (D), Q4.6 (D), Q4.7 (D), Q4.8 (D), Q5.5 (D), Q5.6 (D), Q5.7 (D), Q5.8 (D)
GND: 6-12V.2, BUS.16, C1.2, C2.1, IC1.5 (GND), PROGRAM.5, PROGRAM.6, R6.1, R7.1, R8.1, R9.1, R10.1, X1.6
LIGHT1: D1.1 (A), Q1.1 (S), Q1.2 (S), Q1.3 (S), X1.1
LIGHT2: D2.1 (A), Q2.1 (S), Q2.2 (S), Q2.3 (S), X1.2
LIGHT3: D3.1 (A), Q3.1 (S), Q3.2 (S), Q3.3 (S), X1.3
LIGHT4: D4.1 (A), Q4.1 (S), Q4.2 (S), Q4.3 (S), X1.4
LIGHT5: D5.1 (A), Q5.1 (S), Q5.2 (S), Q5.3 (S), X1.5
unnamed: BUS.3, R1.1
unnamed: BUS.5, R2.1
unnamed: BUS.7, R3.1
unnamed: BUS.9, R4.1
unnamed: BUS.4, IC1.7 (VIOUT)
unnamed: C1.1, IC1.6 (FILTER)
unnamed: BUS.11, R5.1
unnamed: Q5.4 (G), R5.2, R10.2
unnamed: Q4.4 (G), R4.2, R9.2
unnamed: Q3.4 (G), R3.2, R8.2
unnamed: Q2.4 (G), R2.2, R7.2
unnamed: Q1.4 (G), R1.2, R6.2
POWER: 6-12V.1, IC1.1 (IP+), IC1.2 (IP+_1)
VCC: BUS.1, C2.2, IC1.8 (VCC), PROGRAM.4
