loco-can/loco-can-hardware/V1.0/Light Adapter SMD/Light-Adapter SMD.brd

## EAGLE design V1.0/Light Adapter SMD/Light-Adapter SMD.brd (continued)

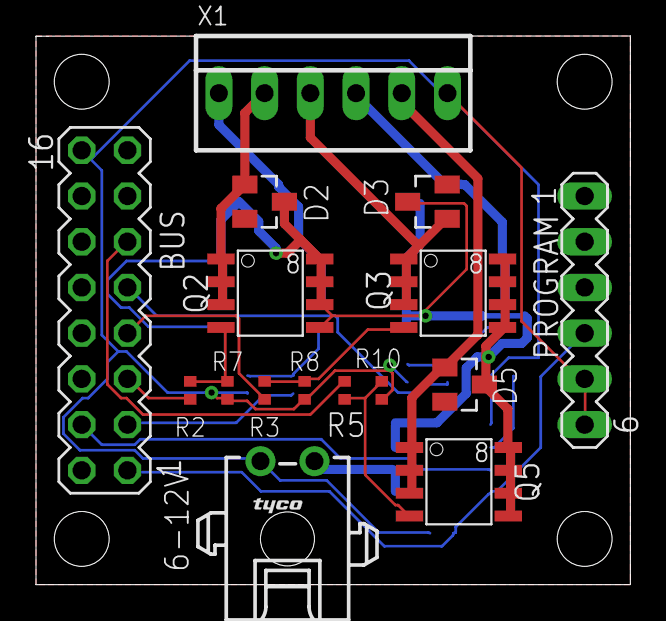
[picture p74: board Light-Adapter SMD.brd from above]

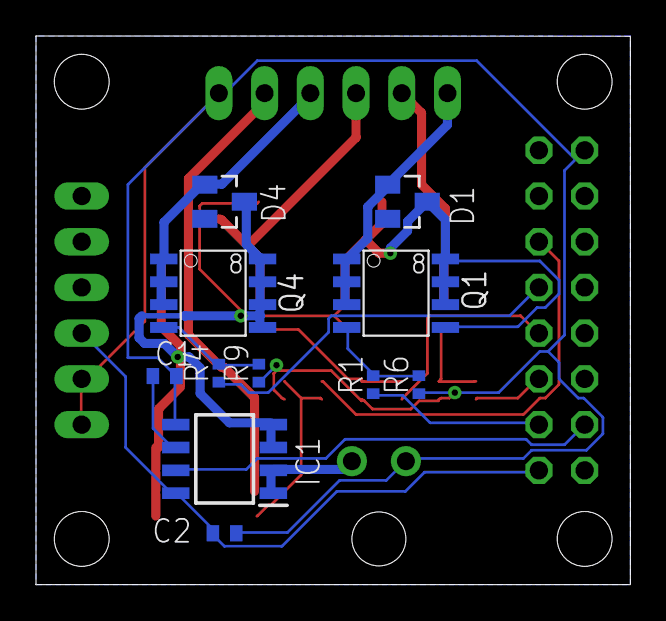
[picture p75: board Light-Adapter SMD.brd from below]

Board: 2 copper layers, 33.0 x 30.5 mm, 27 parts (11 on the bottom side), 21 nets.
