loco-can/loco-can-hardware/V1.2/Adapter Sensor/UI Adapter.brd

## EAGLE design V1.2/Adapter Sensor/UI Adapter.brd (2023-02-24)

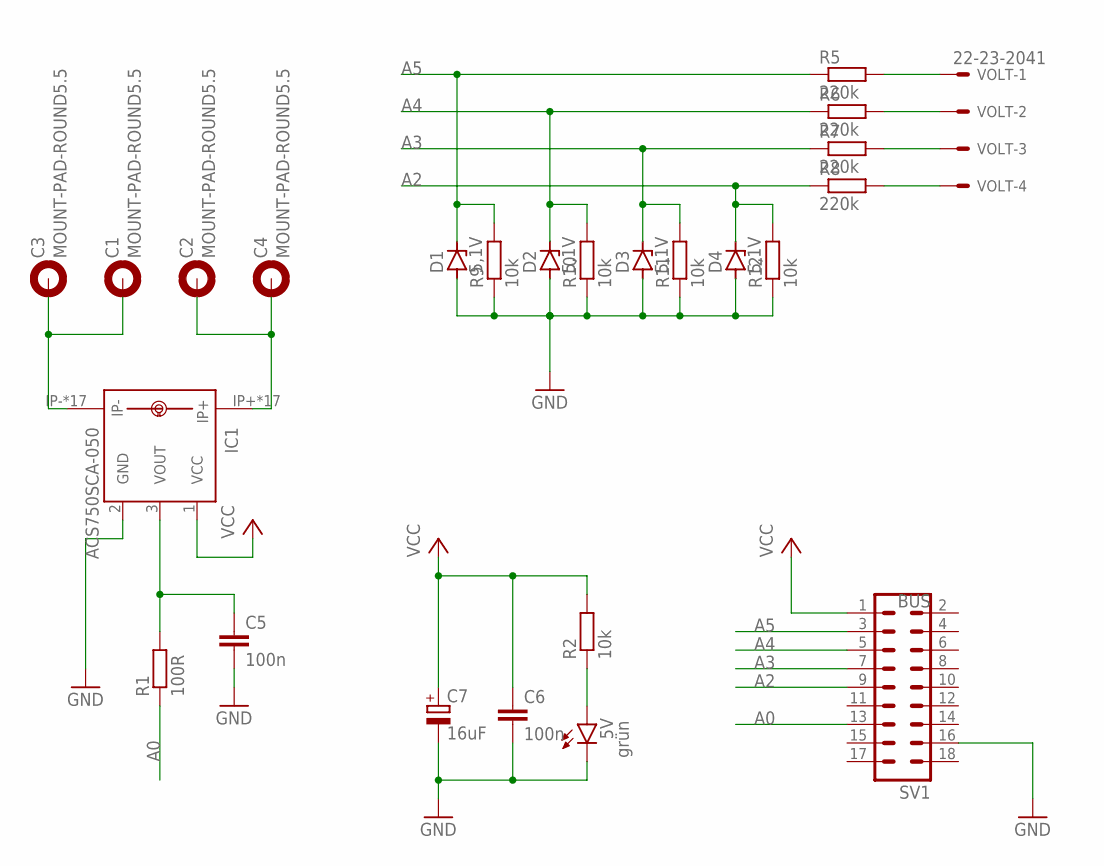
[picture p76: schematic UI Adapter.sch, sheet 1]

Parts:
5V: grün; LED3MM
C1, C2, C3, C4: MOUNT-PAD-ROUND5.5; 5,5-PAD
C5, C6: 100n; C025-024X044
C7: 16uF; E2-5
D1, D2, D3, D4: 5,1V; ZDIO-7.5
IC1: ACS750SCA-050; ACS75050
R1: 100R; 0204V
R2, R9, R10, R11, R12: 10k; 0204V
R5, R6, R7, R8: 220k; 0204V
SV1: BUS; MA09-2
VOLT: 22-23-2041

Connections:
A0: R1.1, SV1.13
A2: D4.C, R8.1, R12.2, SV1.9
A3: D3.C, R7.1, R11.2, SV1.7
A4: D2.C, R6.1, R10.2, SV1.5
A5: D1.C, R5.1, R9.2, SV1.3
C1: C1.B5,5, C3.B5,5, IC1.IP-, IC1.IP-@2 (IP-), IC1.IP-@3 (IP-), IC1.IP-@4 (IP-), IC1.IP-@5 (IP-), IC1.IP-@6 (IP-), IC1.IP-@7 (IP-), IC1.IP-@8 (IP-), IC1.IP-@9 (IP-), IC1.IP-@10 (IP-), IC1.IP-@11 (IP-), IC1.IP-@12 (IP-), IC1.IP-@13 (IP-), IC1.IP-@14 (IP-), IC1.IP-@15 (IP-), IC1.IP-@16 (IP-), IC1.IP-@17 (IP-)
C2: C2.B5,5, C4.B5,5, IC1.IP+, IC1.IP+@2 (IP+), IC1.IP+@3 (IP+), IC1.IP+@4 (IP+), IC1.IP+@5 (IP+), IC1.IP+@6 (IP+), IC1.IP+@7 (IP+), IC1.IP+@8 (IP+), IC1.IP+@9 (IP+), IC1.IP+@10 (IP+), IC1.IP+@11 (IP+), IC1.IP+@12 (IP+), IC1.IP+@13 (IP+), IC1.IP+@14 (IP+), IC1.IP+@15 (IP+), IC1.IP+@16 (IP+), IC1.IP+@17 (IP+)
GND: 5V.K (C), C5.2, C6.2, C7.-, D1.A, D2.A, D3.A, D4.A, IC1.2 (GND), R9.1, R10.1, R11.1, R12.1, SV1.16
unnamed: 5V.A, R2.1
unnamed: C5.1, IC1.3 (VOUT), R1.2
unnamed: R5.2, VOLT.1
unnamed: R6.2, VOLT.2
unnamed: R7.2, VOLT.3
unnamed: R8.2, VOLT.4
VCC: C6.1, C7.+, IC1.1 (VCC), R2.2, SV1.1

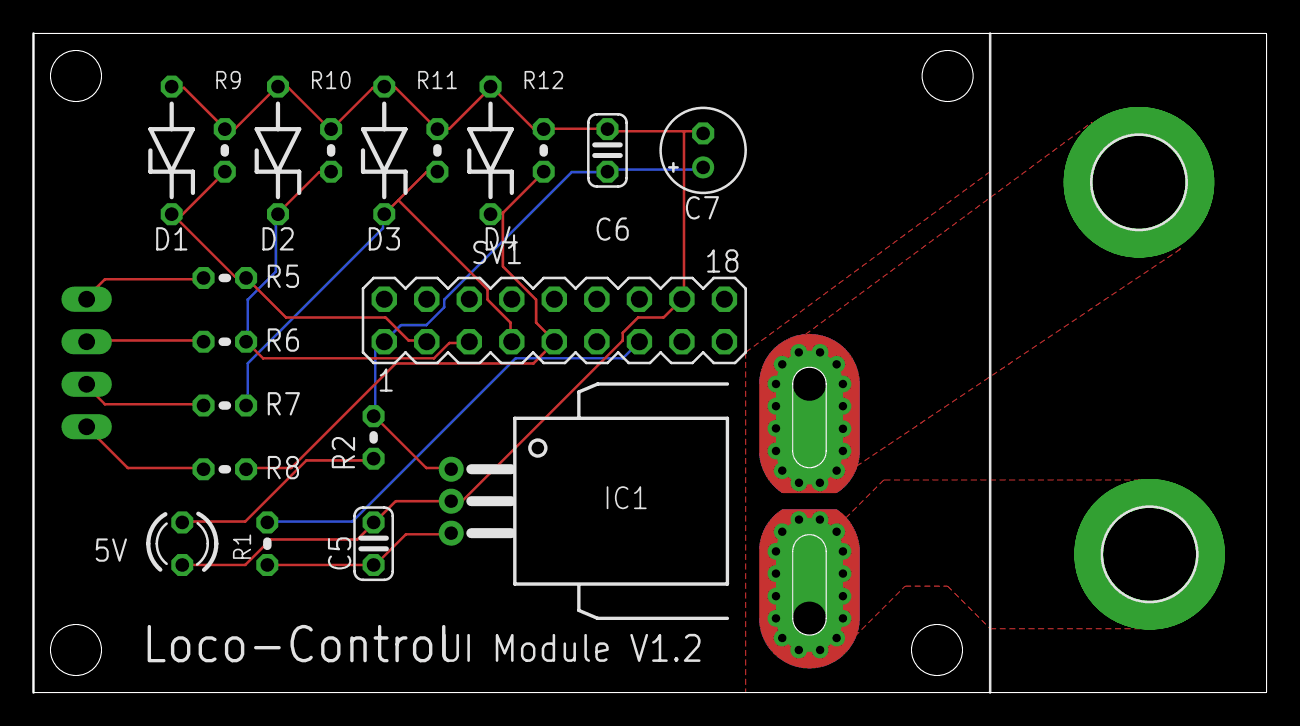
[picture p77: board UI Adapter.brd from above]

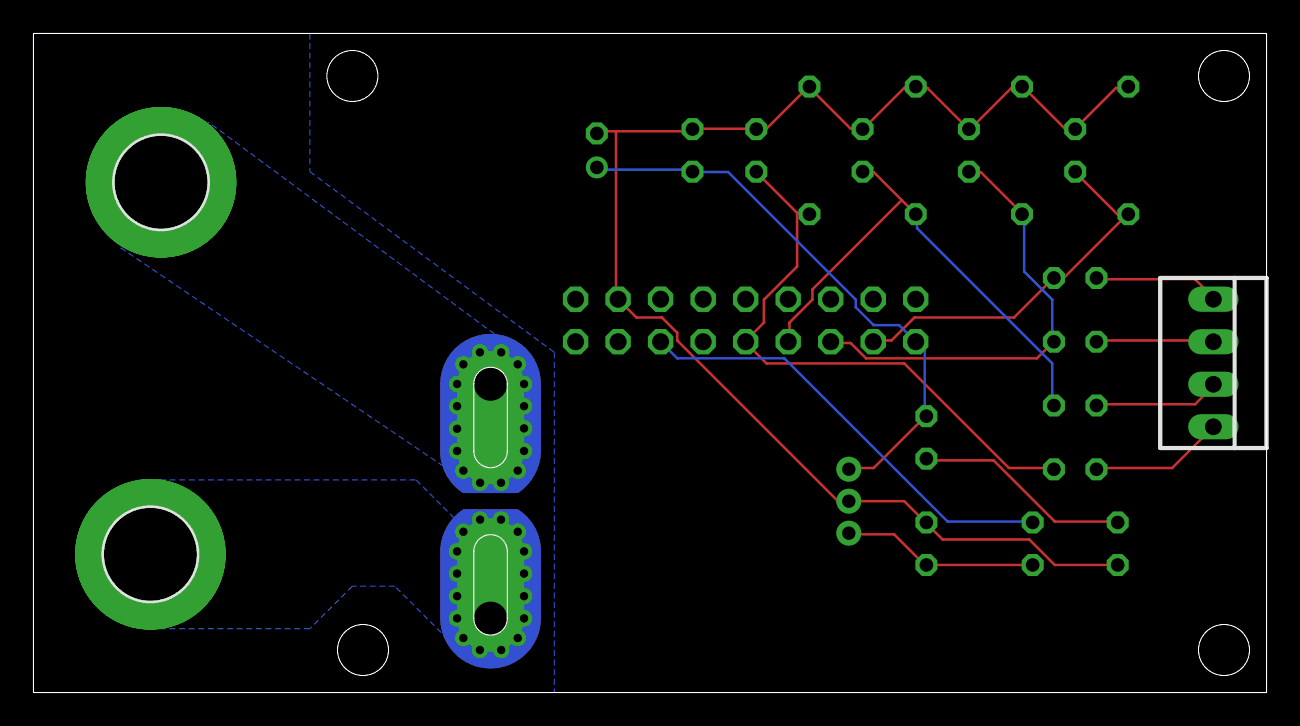
[picture p78: board UI Adapter.brd from below]

Board: 2 copper layers, 73.7 x 39.4 mm, 25 parts (3 on the bottom side), 15 nets.
