loco-can/loco-can-hardware/V1.2/CAN Control/CAN Control SMD.brd

## EAGLE design V1.2/CAN Control/CAN Control SMD.brd (2023-02-24)

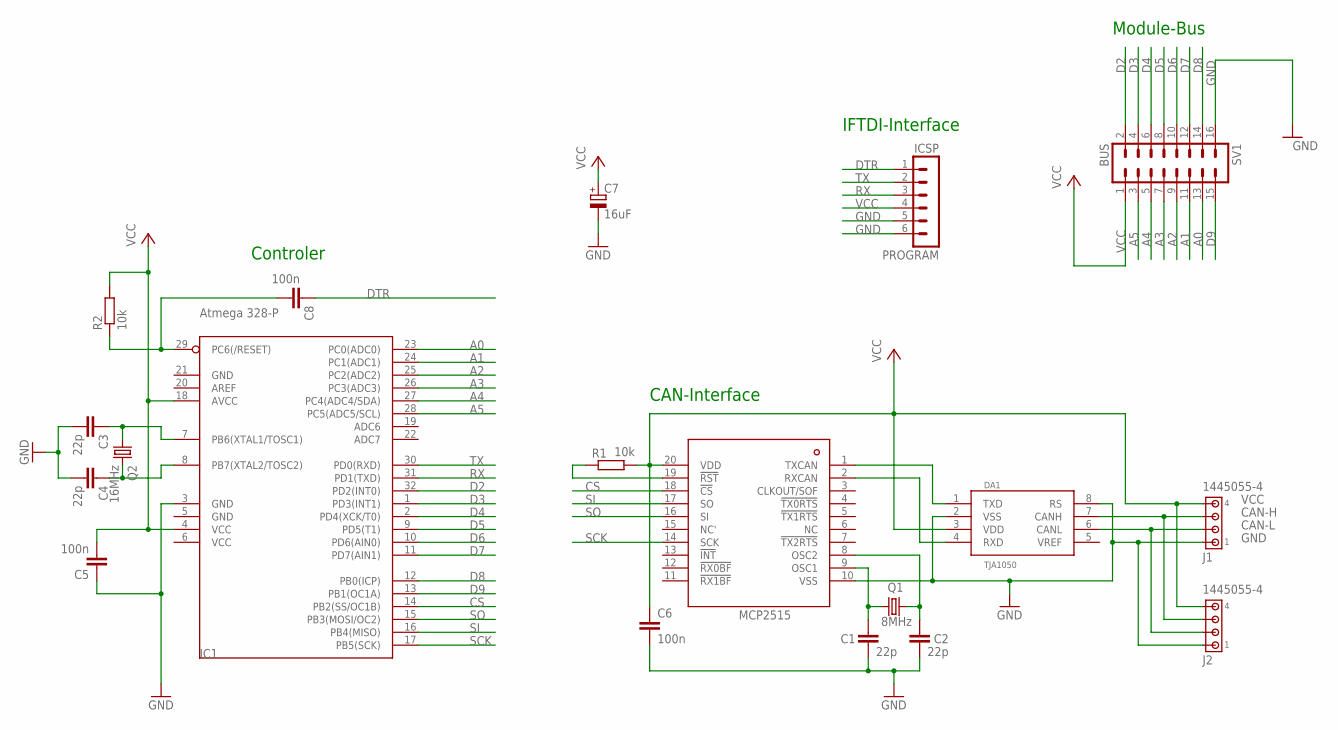
[picture p79: schematic CAN Control SMD.sch, sheet 1]

Parts:
C1, C2, C3, C4: 22p; C0402K
C5, C6, C8: 100n; C0402K
C7: 16uF; A/3216-18W
DA1: TJA1050; SO08
IC1: Atmega 328-P; TQFP32-08
IC2: MCP2515; TSSOP20
J1, J2: 1445055-4
PROGRAM: ICSP; MA06-1
Q1: 8MHz; HC49/S
Q2: 16MHz; HC49/S
R1, R2: 10k; MINI_MELF-0102W
SV1: BUS; MA08-2

Connections:
A0: IC1.23 (PC0(ADC0)), SV1.13
A1: IC1.24 (PC1(ADC1)), SV1.11
A2: IC1.25 (PC2(ADC2)), SV1.9
A3: IC1.26 (PC3(ADC3)), SV1.7
A4: IC1.27 (PC4(ADC4/SDA)), SV1.5
A5: IC1.28 (PC5(ADC5/SCL)), SV1.3
CAN-H: DA1.7 (CANH), J1.3, J2.3
CAN-L: DA1.6 (CANL), J1.2, J2.2
CAN-OCC1: C1.1, IC2.9 (OSC1), Q1.1
CAN-OCC2: C2.1, IC2.8 (OSC2), Q1.2
CS: IC1.14 (PB2(SS/OC1B)), IC2.18 (!CS)
D2: IC1.32 (PD2(INT0)), SV1.2
D3: IC1.1 (PD3(INT1)), SV1.4
D4: IC1.2 (PD4(XCK/T0)), SV1.6
D5: IC1.9 (PD5(T1)), SV1.8
D6: IC1.10 (PD6(AIN0)), SV1.10
D7: IC1.11 (PD7(AIN1)), SV1.12
D8: IC1.12 (PB0(ICP)), SV1.14
D9: IC1.13 (PB1(OC1A)), SV1.15
DTR: C8.1, PROGRAM.1
GND: C1.2, C2.2, C3.2, C4.2, C5.1, C6.2, C7.-, DA1.2 (VSS), DA1.8 (RS), IC1.3 (GND), IC1.5 (GND), IC1.21 (GND), IC2.10 (VSS), J1.1, J2.1, PROGRAM.5, PROGRAM.6, SV1.16
unnamed: IC2.19 (!RST), R1.1
unnamed: C3.1, IC1.7 (PB6(XTAL1/TOSC1)), Q2.1
unnamed: C4.1, IC1.8 (PB7(XTAL2/TOSC2)), Q2.2
unnamed: C8.2, IC1.29 (PC6(/RESET)), R2.1
RX: IC1.31 (PD1(TXD)), PROGRAM.3
RXCAN: DA1.4 (RXD), IC2.2 (RXCAN)
SCK: IC1.17 (PB5(SCK)), IC2.14 (SCK)
SI: IC1.16 (PB4(MISO)), IC2.17 (SO)
SO: IC1.15 (PB3(MOSI/OC2)), IC2.16 (SI)
TX: IC1.30 (PD0(RXD)), PROGRAM.2
TXCAN: DA1.1 (TXD), IC2.1 (TXCAN)
VCC: C5.2, C6.1, C7.+, DA1.3 (VDD), IC1.4 (VCC), IC1.6 (VCC), IC1.18 (AVCC), IC2.20 (VDD), J1.4, J2.4, PROGRAM.4, R1.2, R2.2, SV1.1

Notes on the sheet:
Module-Bus
IFTDI-Interface
CAN-Interface
Controler

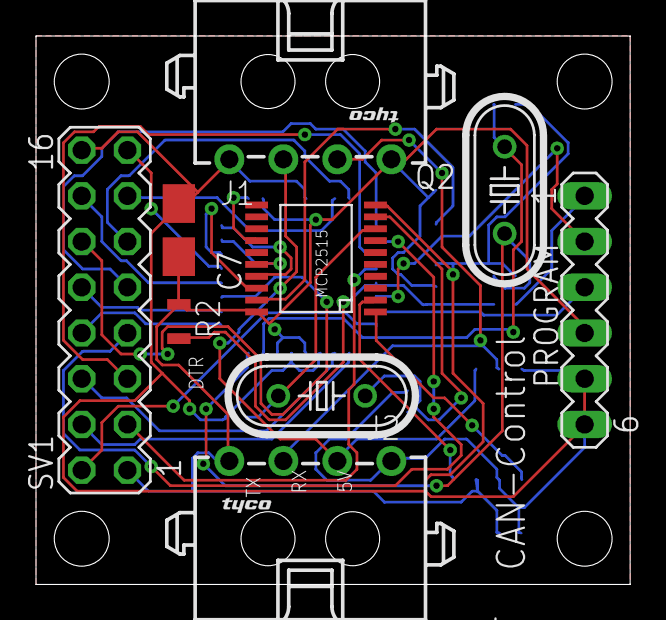
[picture p80: board CAN Control SMD.brd from above]

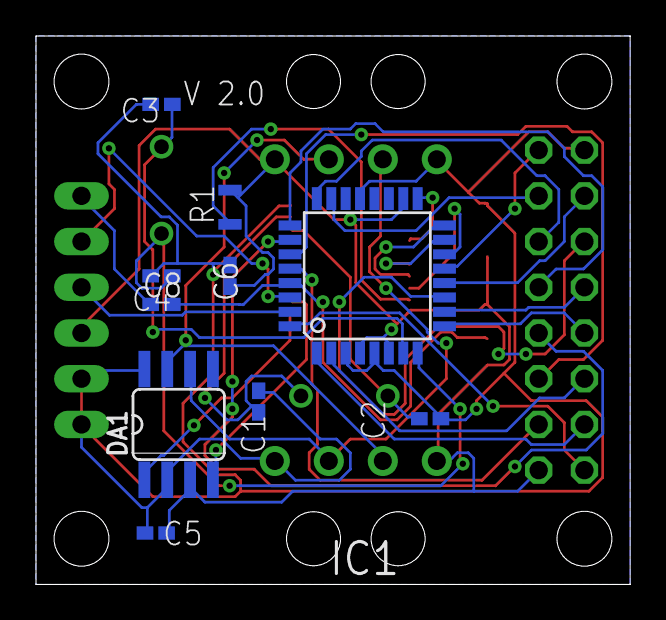
[picture p81: board CAN Control SMD.brd from below]

Board: 2 copper layers, 33.0 x 30.5 mm, 19 parts (10 on the bottom side), 33 nets.
