loco-can/loco-can-hardware/V2.x/Sensor/LOCO-Sensor.brd

## EAGLE design V2.x/Sensor/LOCO-Sensor.brd (2023-02-24, an earlier design)

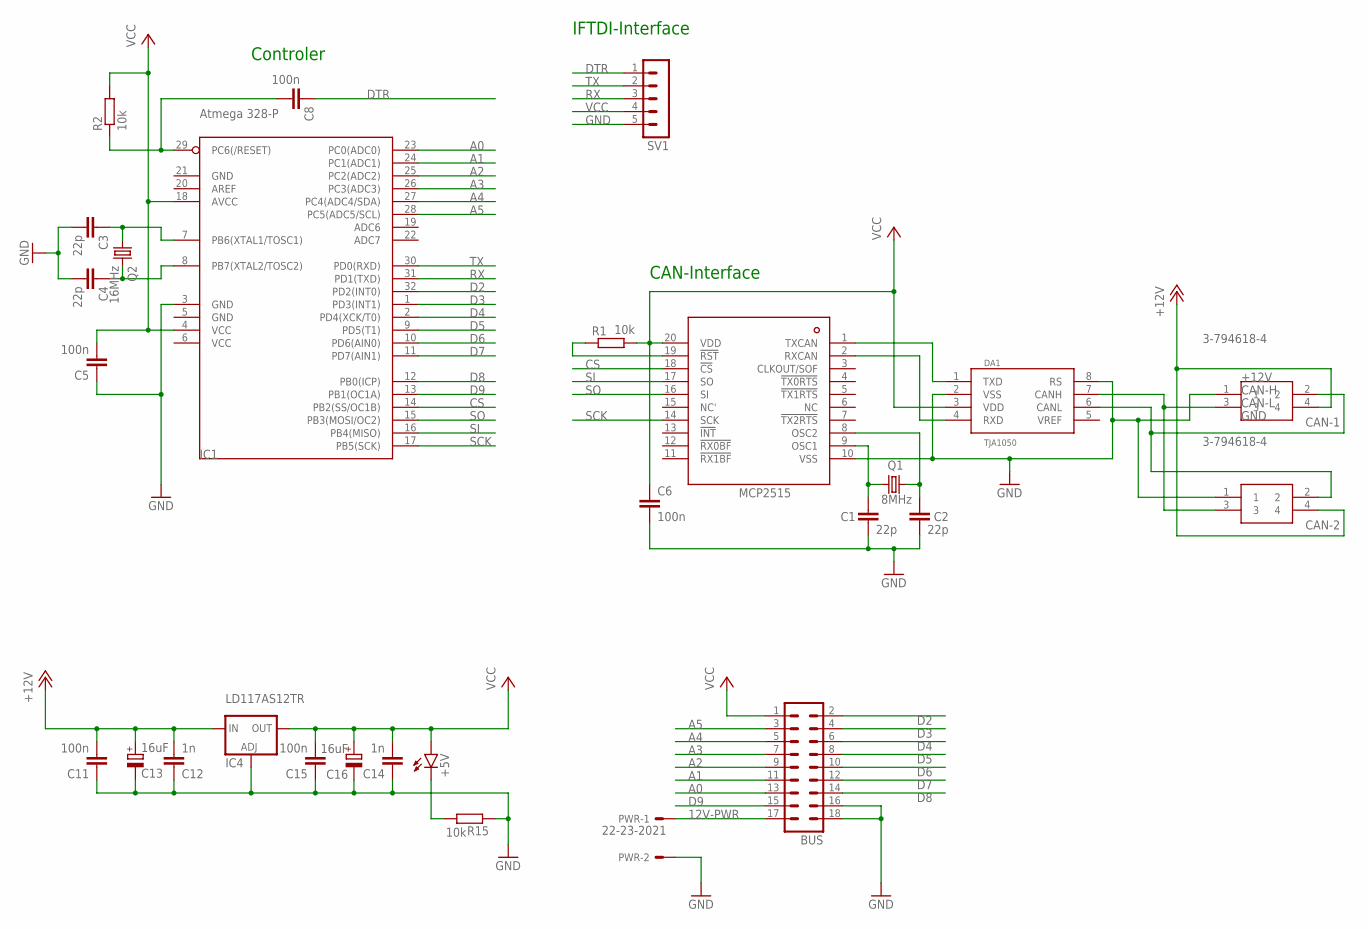
[picture p82: schematic LOCO-Sensor.sch, sheet 1]

Parts:
+5V: LEDCHIP-LED0603; CHIP-LED0603
BUS: MA09-2
C1, C2, C3, C4: 22p; C0402K
C5, C6, C8, C11, C15: 100n; C0402K
C12, C14: 1n; C0402K
C13, C16: 16uF; A/3216-18W
CAN-1, CAN-2: 3-794618-4; SHDRRA4W102P300_2X2_686X892X73
DA1: TJA1050; SO08
IC1: Atmega 328-P; TQFP32-08
IC2: MCP2515; TSSOP20
IC4: LD117AS12TR; SOT223
PWR: 22-23-2021
Q1: 8MHz; HC49/S
Q2: 16MHz; HC49/S
R1, R2, R15: 10k; MINI_MELF-0102W
SV1: MA05-1

Connections:
12V-PWR: BUS.17, PWR.1
+12V: C11.2, C12.2, C13.+, CAN-1.4, CAN-2.4, IC4.3 (IN)
A0: BUS.13, IC1.23 (PC0(ADC0))
A1: BUS.11, IC1.24 (PC1(ADC1))
A2: BUS.9, IC1.25 (PC2(ADC2))
A3: BUS.7, IC1.26 (PC3(ADC3))
A4: BUS.5, IC1.27 (PC4(ADC4/SDA))
A5: BUS.3, IC1.28 (PC5(ADC5/SCL))
CAN-H: CAN-1.3, CAN-2.3, DA1.7 (CANH)
CAN-L: CAN-1.2, CAN-2.2, DA1.6 (CANL)
CAN-OCC1: C1.1, IC2.9 (OSC1), Q1.1
CAN-OCC2: C2.1, IC2.8 (OSC2), Q1.2
CS: IC1.14 (PB2(SS/OC1B)), IC2.18 (!CS)
D2: BUS.2, IC1.32 (PD2(INT0))
D3: BUS.4, IC1.1 (PD3(INT1))
D4: BUS.6, IC1.2 (PD4(XCK/T0))
D5: BUS.8, IC1.9 (PD5(T1))
D6: BUS.10, IC1.10 (PD6(AIN0))
D7: BUS.12, IC1.11 (PD7(AIN1))
D8: BUS.14, IC1.12 (PB0(ICP))
D9: BUS.15, IC1.13 (PB1(OC1A))
DTR: C8.1, SV1.1
GND: BUS.16, BUS.18, C1.2, C2.2, C3.2, C4.2, C5.1, C6.2, C11.1, C12.1, C13.-, C14.1, C15.1, C16.-, CAN-1.1, CAN-2.1, DA1.2 (VSS), DA1.8 (RS), IC1.3 (GND), IC1.5 (GND), IC1.21 (GND), IC2.10 (VSS), IC4.1 (ADJ), PWR.2, R15.1, SV1.5
unnamed: IC2.19 (!RST), R1.1
unnamed: C3.1, IC1.7 (PB6(XTAL1/TOSC1)), Q2.1
unnamed: C4.1, IC1.8 (PB7(XTAL2/TOSC2)), Q2.2
unnamed: +5V.C, R15.2
unnamed: C8.2, IC1.29 (PC6(/RESET)), R2.1
RX: IC1.31 (PD1(TXD)), SV1.3
RXCAN: DA1.4 (RXD), IC2.2 (RXCAN)
SCK: IC1.17 (PB5(SCK)), IC2.14 (SCK)
SI: IC1.16 (PB4(MISO)), IC2.17 (SO)
SO: IC1.15 (PB3(MOSI/OC2)), IC2.16 (SI)
TX: IC1.30 (PD0(RXD)), SV1.2
TXCAN: DA1.1 (TXD), IC2.1 (TXCAN)
VCC: +5V.A, BUS.1, C5.2, C6.1, C14.2, C15.2, C16.+, DA1.3 (VDD), IC1.4 (VCC), IC1.6 (VCC), IC1.18 (AVCC), IC2.20 (VDD), IC4.4 (OUT), R1.2, R2.2, SV1.4

Notes on the sheet:
IFTDI-Interface
CAN-Interface
Controler

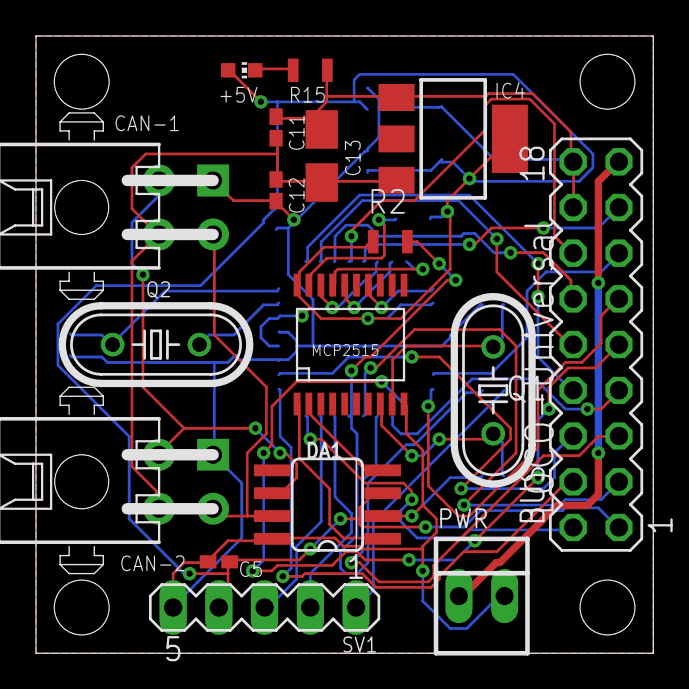
[picture p83: board LOCO-Sensor.brd from above]

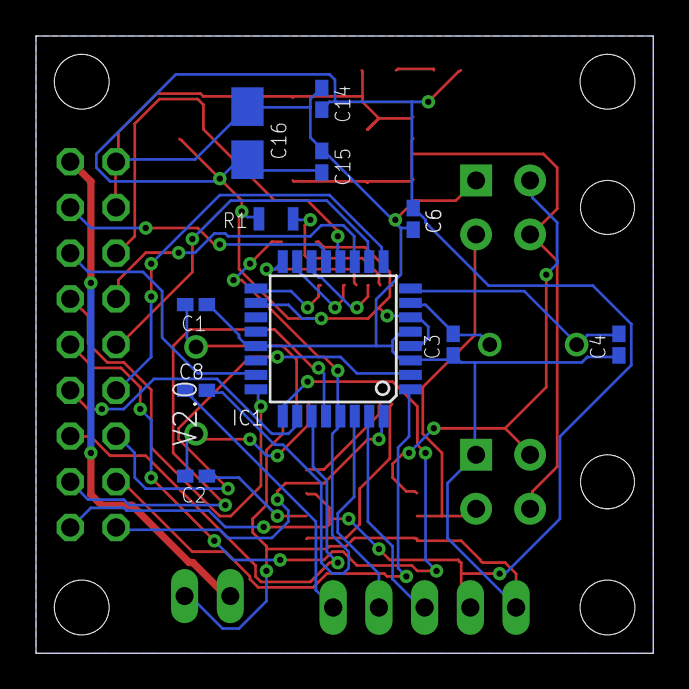
[picture p84: board LOCO-Sensor.brd from below]

Board: 2 copper layers, 34.3 x 34.3 mm, 28 parts (11 on the bottom side), 36 nets.
