loco-can/loco-can-hardware/V2.x/Universal WiFi/Universal-WIFI.brd

## EAGLE design V2.x/Universal WiFi/Universal-WIFI.brd (2023-02-24, an earlier design)

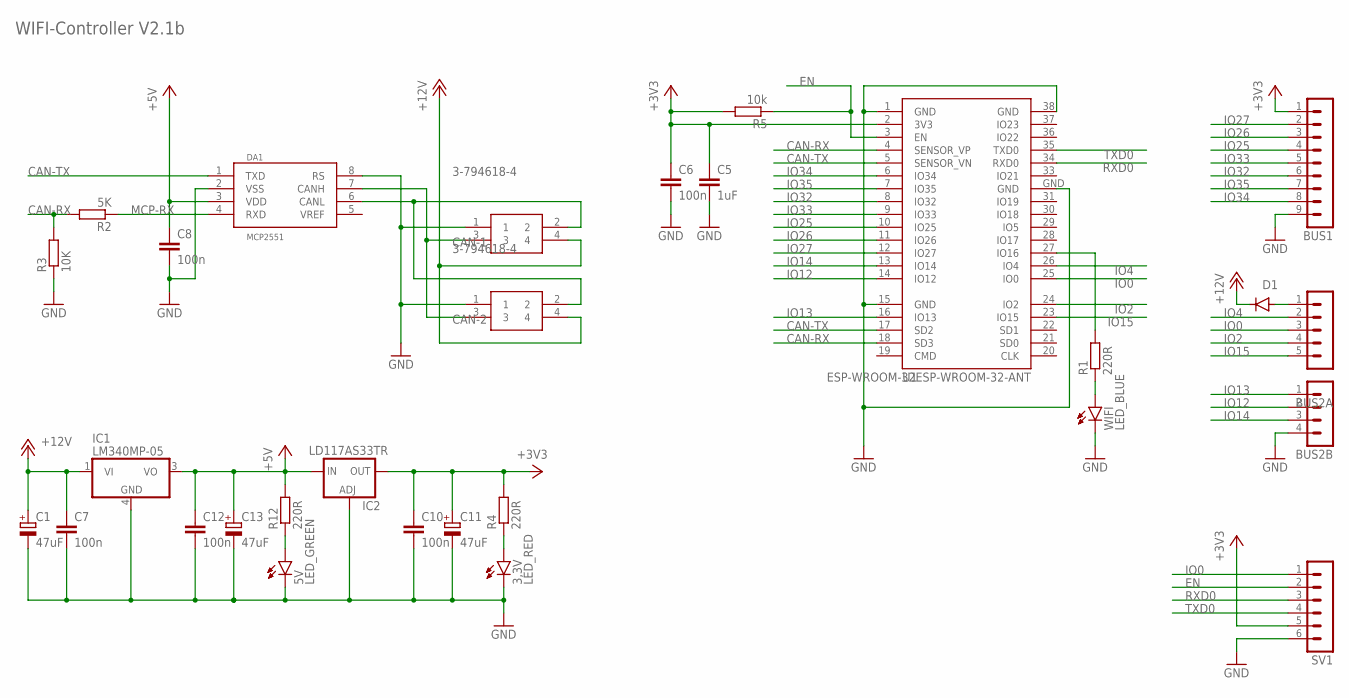
[picture p85: schematic Universal-WIFI.sch]

Parts:
3,3V: LED_RED; LEDC1608X39N_R
5V: LED_GREEN; LEDC1608X39N_G
BUS1: MA09-1
BUS2A: MA05-1
BUS2B: MA04-1
C1, C11, C13: 47uF; B/3528-21R
C5: 1uF; C0402
C6, C7, C8, C10, C12: 100n; C0402
CAN-1, CAN-2: 3-794618-4; SHDRRA4W102P300_2X2_686X892X73
D1: DIODE-DO-214AC; DO-214AC
DA1: MCP2551; SO08
IC1: LM340MP-05; SOT223
IC2: LD117AS33TR; SOT223
R1, R4, R12: 220R; R0805
R2: 5K; R0805
R3: 10K; R0805
R5: 10k; R0805
SV1: MA06-1
U1: ESP-WROOM-32ESP-WROOM-32-ANT; ESP-WROOM-32-ANT
WIFI: LED_BLUE; LEDC1608X39N_B

Connections:
+3V3: BUS1.1, C5.1, C6.1, C10.1, C11.+, IC2.4 (OUT), R4.2, R5.2, SV1.5, U1.2 (3V3)
+5V: C8.1, C12.1, C13.+, DA1.3 (VDD), IC1.3 (VO), IC2.3 (IN), R12.2
+12V: C1.+, C7.1, CAN-1.4, CAN-2.4, D1.C, IC1.1 (VI)
CAN-RX: R2.2, R3.2, U1.4 (SENSOR_VP), U1.18 (SD3)
CAN-TX: DA1.1 (TXD), U1.5 (SENSOR_VN), U1.17 (SD2)
EN: R5.1, SV1.2, U1.3 (EN)
GND: 3,3V.1 (C), 5V.1 (C), BUS1.9, BUS2B.4, C1.-, C5.2, C6.2, C7.2, C8.2, C10.2, C11.-, C12.2, C13.-, CAN-1.1, CAN-2.1, DA1.2 (VSS), DA1.8 (RS), IC1.4 (GND), IC2.1 (ADJ), R3.1, SV1.6, U1.1 (GND), U1.15 (GND), U1.38 (GND), U1.GND, WIFI.1 (C)
IO0: BUS2A.3, SV1.1, U1.25 (IO0)
IO2: BUS2A.4, U1.24 (IO2)
IO4: BUS2A.2, U1.26 (IO4)
IO12: BUS2B.2, U1.14 (IO12)
IO13: BUS2B.1, U1.16 (IO13)
IO14: BUS2B.3, U1.13 (IO14)
IO15: BUS2A.5, U1.23 (IO15)
IO25: BUS1.4, U1.10 (IO25)
IO26: BUS1.3, U1.11 (IO26)
IO27: BUS1.2, U1.12 (IO27)
IO32: BUS1.6, U1.8 (IO32)
IO33: BUS1.5, U1.9 (IO33)
IO34: BUS1.8, U1.6 (IO34)
IO35: BUS1.7, U1.7 (IO35)
MCP-RX: DA1.4 (RXD), R2.1
unnamed: BUS2A.1, D1.A
unnamed: R1.2, U1.27 (IO16)
unnamed: R1.1, WIFI.2 (A)
unnamed: 3,3V.2 (A), R4.1
unnamed: CAN-1.3, CAN-2.3, DA1.7 (CANH)
unnamed: CAN-1.2, CAN-2.2, DA1.6 (CANL)
unnamed: 5V.2 (A), R12.1
RXD0: SV1.3, U1.34 (RXD0)
TXD0: SV1.4, U1.35 (TXD0)

Notes on the sheet:
WIFI-Controller V2.1b

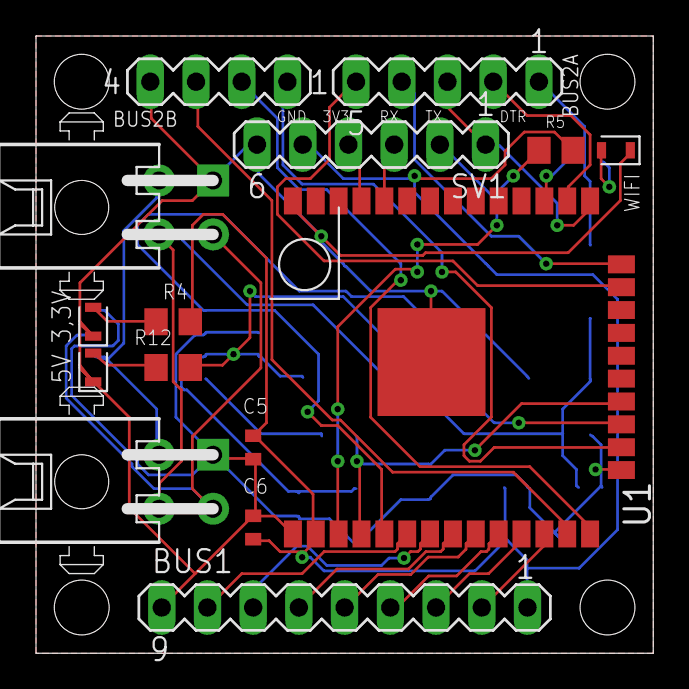
[picture p86: board Universal-WIFI.brd from above]

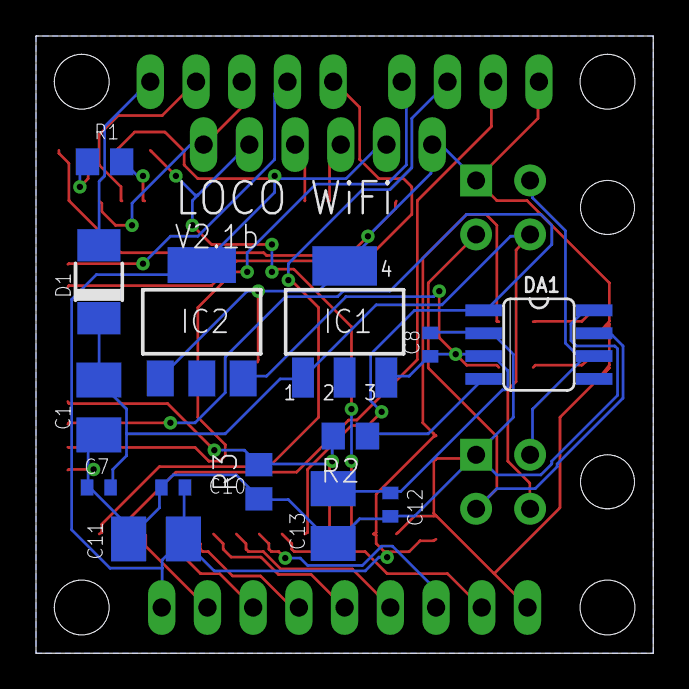
[picture p87: board Universal-WIFI.brd from below]

Board: 2 copper layers, 34.3 x 34.3 mm, 29 parts (14 on the bottom side), 31 nets.
