loco-can/loco-can-hardware/V2.x/Leistungsstufe/Leistungsstufe.brd

## EAGLE design V2.x/Leistungsstufe/Leistungsstufe.brd (2023-02-24, an earlier design)

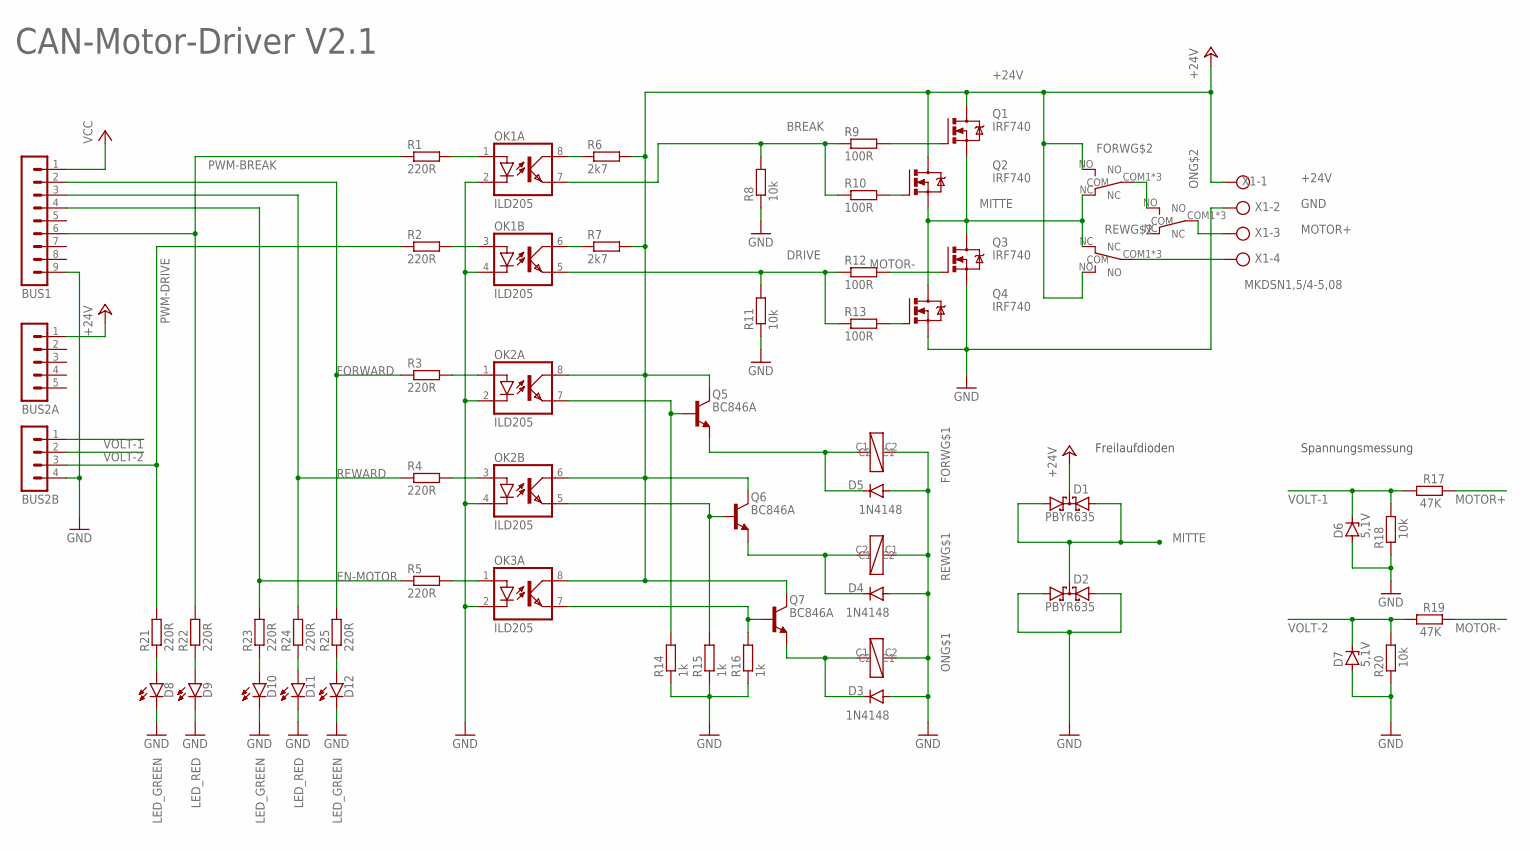
[picture p88: schematic Leistungsstufe.sch]

Parts:
BUS1: MA09-1
BUS2A: MA05-1
BUS2B: MA04-1
D1, D2: PBYR635; SOT82S
D3, D4, D5: 1N4148; SOD323-R
D6, D7: 5,1V; SOD80C
D8, D10, D12: LED_GREEN; LEDC1608X39N_G
D9, D11: LED_RED; LEDC1608X39N_R
FORW: FRA2C-2
OK1, OK2, OK3: ILD205; SOIC08
ON: FRA2C-2
Q1, Q2, Q3, Q4: IRF740; TO220BV
Q5, Q6, Q7: BC846A; SOT95P237X112-3N
R1, R2, R3, R4, R5, R21, R22, R23, R24, R25: 220R; R0805
R6, R7: 2k7; R0805
R8, R11: 10k; R0805
R9, R10, R12, R13: 100R; R0805
R14, R15, R16: 1k; R0805
R17, R19: 47K; MINI_MELF-0102W
R18, R20: 10k; MINI_MELF-0102W
REW: FRA2C-2
X1: MKDSN1,5/4-5,08

Connections:
+24V: BUS2A.1, D1.C, FORW.NO, OK2.6 (COL), OK2.8 (COL), OK3.8 (COL), Q1.D, Q2.D, Q5.3 (C), Q6.3 (C), Q7.3 (C), R6.2, R7.2, REW.NO, X1.1
BREAK: OK1.7 (EMIT), R8.2, R9.1, R10.1
DRIVE: OK1.5 (EMIT), R11.2, R12.1, R13.1
EN-MOTOR: BUS1.4, R5.1, R23.2
FORWARD: BUS1.2, R3.1, R25.2
GND: BUS1.9, BUS2B.4, D2.A1, D2.A2, D3.A, D4.A, D5.A, D6.A, D7.A, D8.1 (C), D9.1 (C), D10.1 (C), D11.1 (C), D12.1 (C), FORW.C2, OK1.2 (C), OK1.4 (C), OK2.2 (C), OK2.4 (C), OK3.2 (C), ON.C2, Q3.S, Q4.S, R8.1, R11.1, R14.1, R15.1, R16.1, R18.1, R20.1, REW.C1, X1.2
M+SWITCH: FORW.COM1 (COM), FORW.COM2 (COM), FORW.COM3 (COM), ON.NO
MITTE: D1.A1, D1.A2, D2.C, FORW.NC, Q1.S, Q2.S, Q3.D, Q4.D, REW.NC
MOTOR+: ON.COM1 (COM), ON.COM2 (COM), ON.COM3 (COM), R17.2, X1.3
MOTOR-: R19.2, REW.COM1 (COM), REW.COM2 (COM), REW.COM3 (COM), X1.4
unnamed: Q2.G, R10.2
unnamed: Q3.G, R12.2
unnamed: Q4.G, R13.2
unnamed: OK2.7 (EMIT), Q5.1 (B), R14.2
unnamed: Q1.G, R9.2
unnamed: OK1.3 (A), R2.2
unnamed: D4.C, Q6.2 (E), REW.C2
unnamed: D8.2 (A), R21.1
unnamed: D5.C, FORW.C1, Q5.2 (E)
unnamed: OK2.5 (EMIT), Q6.1 (B), R15.2
unnamed: D3.C, ON.C1, Q7.2 (E)
unnamed: OK1.8 (COL), R6.1
unnamed: OK1.6 (COL), R7.1
unnamed: OK1.1 (A), R1.2
unnamed: OK2.1 (A), R3.2
unnamed: OK2.3 (A), R4.2
unnamed: OK3.1 (A), R5.2
unnamed: OK3.7 (EMIT), Q7.1 (B), R16.2
unnamed: D10.2 (A), R23.1
unnamed: D9.2 (A), R22.1
unnamed: D11.2 (A), R24.1
unnamed: D12.2 (A), R25.1
PWM-BREAK: BUS1.6, R1.1, R22.2
PWM-DRIVE: BUS2B.3, R2.1, R21.2
REWARD: BUS1.3, R4.1, R24.2
VCC: BUS1.1
VOLT-1: BUS2B.1, D6.C, R17.1, R18.2
VOLT-2: BUS2B.2, D7.C, R19.1, R20.2

Notes on the sheet:
Freilaufdioden
Spannungsmessung
CAN-Motor-Driver V2.1

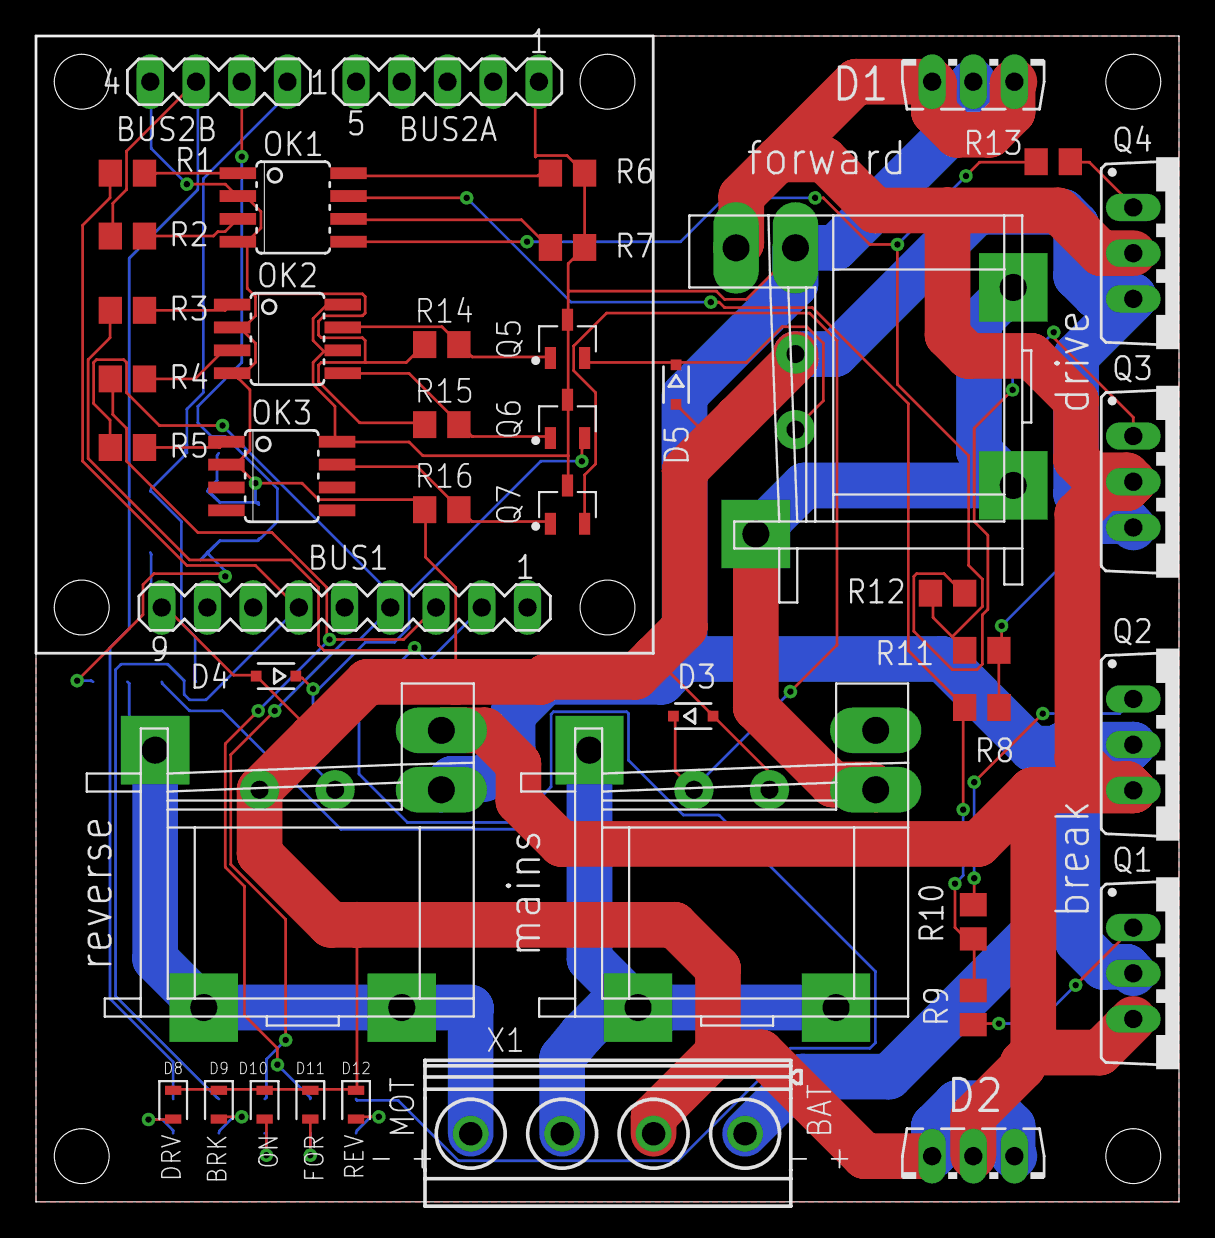
[picture p89: board Leistungsstufe.brd from above]

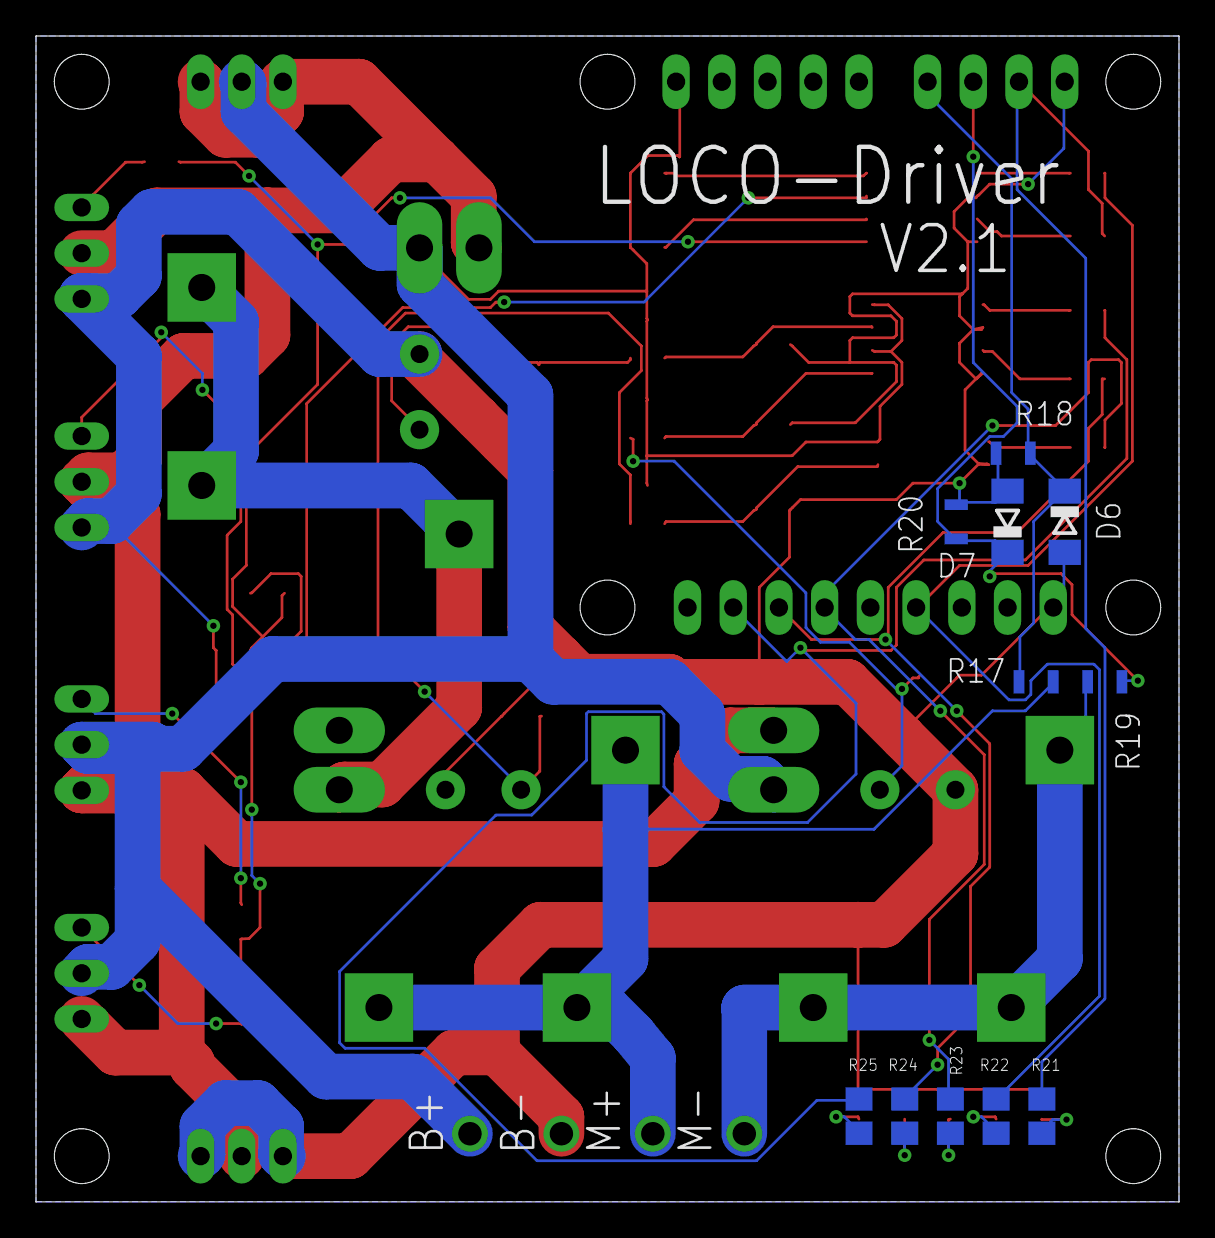
[picture p90: board Leistungsstufe.brd from below]

Board: 2 copper layers, 63.5 x 64.8 mm, 54 parts (11 on the bottom side), 37 nets.
