loco-can/loco-can-hardware/V1.2/CAN Control/CAN Control.brd

## EAGLE design V1.2/CAN Control/CAN Control.brd (2023-02-24)

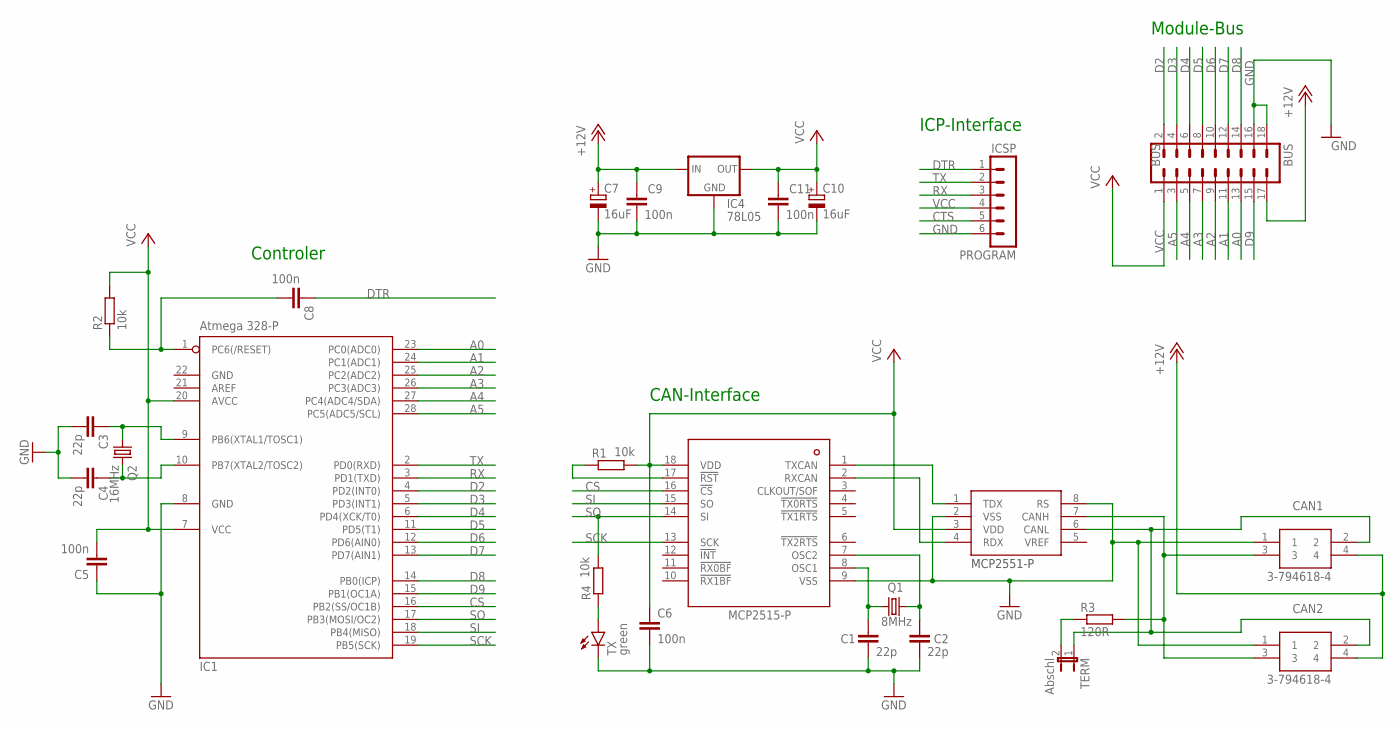
[picture p91: schematic CAN Control.sch, sheet 1]

Parts:
BUS: BUS; MA09-2
C1, C2, C3, C4: 22p; C025-024X044
C5, C6, C8, C9, C11: 100n; C025-024X044
C7, C10: 16uF; E2-5
CAN1, CAN2: 3-794618-4; SHDRRA4W102P300_2X2_686X892X73
IC1: Atmega 328-P; DIL28-3
IC2: MCP2515-P; DIL18
IC3: MCP2551-P; DIL8
IC4: 78L05; 78LXX
PROGRAM: ICSP; MA06-1
Q1: 8MHz; HC49/S
Q2: 16MHz; HC49/S
R1, R2, R4: 10k; 0204V
R3: 120R; 0204V
TERM: Abschl; JP1
TX: green; LED3MM

Connections:
+12V: BUS.17, C7.+, C9.1, CAN1.4, CAN2.4, IC4.IN
A0: BUS.13, IC1.23 (PC0(ADC0))
A1: BUS.11, IC1.24 (PC1(ADC1))
A2: BUS.9, IC1.25 (PC2(ADC2))
A3: BUS.7, IC1.26 (PC3(ADC3))
A4: BUS.5, IC1.27 (PC4(ADC4/SDA))
A5: BUS.3, IC1.28 (PC5(ADC5/SCL))
CAN2: CAN1.2, CAN2.2, IC3.6 (CANL), TERM.1
CAN-H: CAN1.3, CAN2.3, IC3.7 (CANH), R3.2
CAN-OCC1: C1.1, IC2.8 (OSC1), Q1.1
CAN-OCC2: C2.1, IC2.7 (OSC2), Q1.2
CS: IC1.16 (PB2(SS/OC1B)), IC2.16 (!CS)
CTS: PROGRAM.5
D2: BUS.2, IC1.4 (PD2(INT0))
D3: BUS.4, IC1.5 (PD3(INT1))
D4: BUS.6, IC1.6 (PD4(XCK/T0))
D5: BUS.8, IC1.11 (PD5(T1))
D6: BUS.10, IC1.12 (PD6(AIN0))
D7: BUS.12, IC1.13 (PD7(AIN1))
D8: BUS.14, IC1.14 (PB0(ICP))
D9: BUS.15, IC1.15 (PB1(OC1A))
DTR: C8.1, PROGRAM.1
GND: BUS.16, BUS.18, C1.2, C2.2, C3.2, C4.2, C5.1, C6.2, C7.-, C9.2, C10.-, C11.2, CAN1.1, CAN2.1, IC1.8 (GND), IC1.22 (GND), IC2.9 (VSS), IC3.2 (VSS), IC3.8 (RS), IC4.GND, PROGRAM.6, TX.K (C)
unnamed: R4.1, TX.A
unnamed: IC2.17 (!RST), R1.1
unnamed: C3.1, IC1.9 (PB6(XTAL1/TOSC1)), Q2.1
unnamed: C4.1, IC1.10 (PB7(XTAL2/TOSC2)), Q2.2
unnamed: R3.1, TERM.2
unnamed: C8.2, IC1.1 (PC6(/RESET)), R2.1
RX: IC1.3 (PD1(TXD)), PROGRAM.3
RXCAN: IC2.2 (RXCAN), IC3.4 (RDX)
SCK: IC1.19 (PB5(SCK)), IC2.13 (SCK)
SI: IC1.18 (PB4(MISO)), IC2.15 (SO)
SO: IC1.17 (PB3(MOSI/OC2)), IC2.14 (SI), R4.2
TX: IC1.2 (PD0(RXD)), PROGRAM.2
TXCAN: IC2.1 (TXCAN), IC3.1 (TDX)
VCC: BUS.1, C5.2, C6.1, C10.+, C11.1, IC1.7 (VCC), IC1.20 (AVCC), IC2.18 (VDD), IC3.3 (VDD), IC4.OUT, PROGRAM.4, R1.2, R2.2

Notes on the sheet:
Module-Bus
ICP-Interface
CAN-Interface
Controler
