loco-can/loco-can-hardware/V1.2/CAN Control/CAN Control.brd

## EAGLE design V1.2/CAN Control/CAN Control.brd (continued)

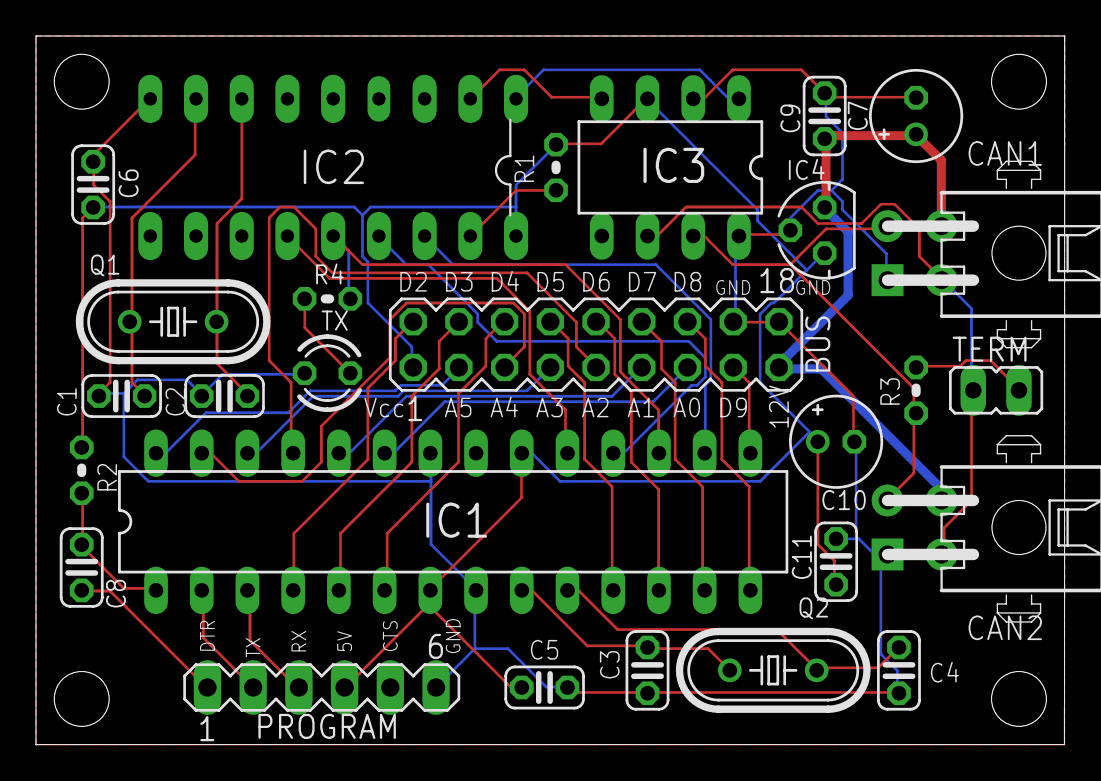
[picture p92: board CAN Control.brd from above]

Board: 2 copper layers, 57.1 x 39.4 mm, 27 parts (0 on the bottom side), 36 nets.
