loco-can/loco-can-hardware/(commit log)

2023-02-24 added Loco-CAN icon to motor, servo and switch boards
    [LOCO-Servo.brd, LOCO-Servo.sch, LOCO-Switch.brd, LOCO-Switch.sch, Motor.brd, Motor.sch]
2023-02-27 new single light and single light akku versions
    [LOCO-Single Light-Akku.brd, LOCO-Single Light-Akku.f3z, LOCO-Single Light-Akku.sch, LOCO-Single Light.brd, LOCO-Single Light.f3z, LOCO-Single_Light.sch]
2023-03-02 design clean up
    [LOCO-Servo.brd, LOCO-Servo.sch, LOCO-Single Light-Akku.brd, LOCO-Single Light-Akku.f3z, LOCO-Single Light-Akku.sch, LOCO-Single Light.brd, LOCO-Single Light.f3z, LOCO-Single_Light.sch]
2023-03-07 Assembly PDF english and german added
2023-03-21 switch module: can tx status led added manufacturing data for switch module
    [Loco-Switch v23_top_bom.csv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]
2023-03-22 add RX/TX led to motor module
2023-03-22 changed sch and brd of motor and switch for RX/TX leds
    [LOCO-Switch.brd, LOCO-Switch.sch, Loco-Motor.brd, Loco-Motor.sch]
2023-03-28 added micro module
    [Loco-Micro.brd, Loco-Micro.sch]
2023-03-31 updated micro module
    [Loco-Micro.brd, Loco-Micro.f3z, Loco-Micro.sch]
2023-04-18 update switch board
    [LOCO-Switch.brd, LOCO-Switch.sch]
2023-08-17 Added Speedometer
    [Loco-Speedometer.brd, Loco-Speedometer.sch]
2023-08-22 Speedometer added mechanics with housing files added
    [Loco-Speedometer.brd, Loco-Speedometer.sch, baseplate controller.f3d, baseplate controller.stl, baseplate.f3d, baseplate.stl, cover motor module.f3d, cover motor module.stl]
