loco-can/loco-can-hardware/(notices)

Notices in the files:
V1.2/CAN Control/CAN Control.brd:
V 1.2 - (c) 2020
parts and their libraries:
crystal-geyer_V1_0: Copyright: Geyer-Electronic
ST732: COPYRIGHT: Copyright (C) 2023 Ultra Librarian. All rights reserved.
esp32: Creative Commons Attribution-ShareAlike 4.0 International
